DaVinciBot/CDR-CAD/CAD/CDR_2023/Louis-Amaury.jpg

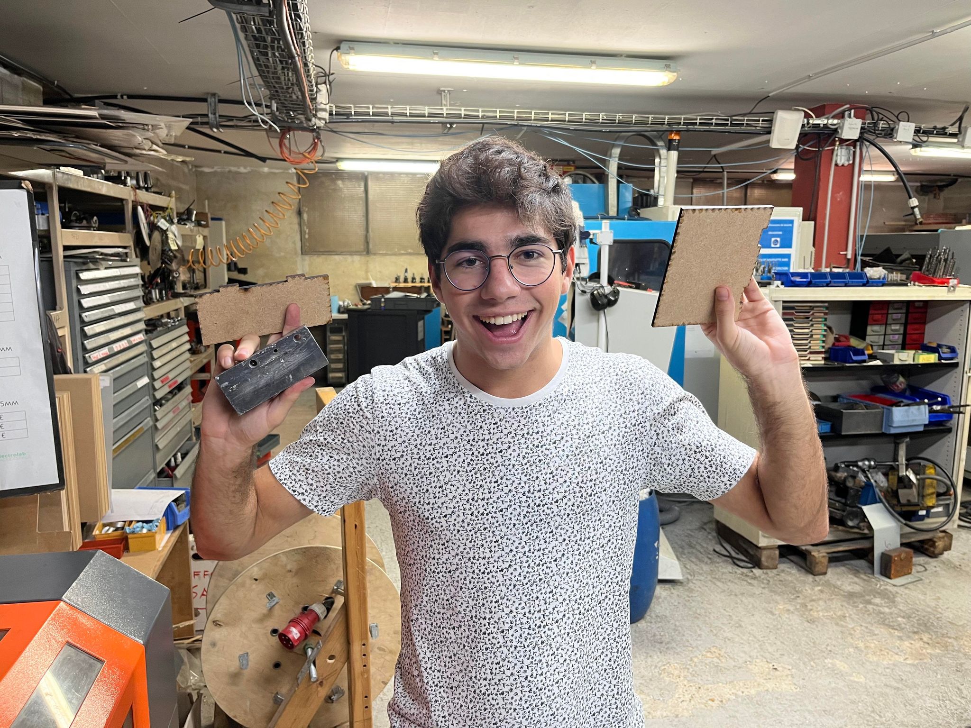
CAD/CDR_2023/Louis-Amaury.jpg
