DaVinciBot/CDR-CAD/CAD/CDR_2025/Robot_Main/1.Base_Roulante/1.Bloc_Moteur_2.0/1.Parties_Moteur_FAULHABER/3242_CR_3D-CAD/3242G_CR/3242G_CR.pdf

If you see this message, please change

"Comments and Forms" from Print Dialog to

"Document and Markups"

Explode / Move Parts
