DaVinciBot/CDR-CAD/CAD/CDR_2025/Robot_Main/1.Base_Roulante/1.Bloc_Moteur_2.0/1.Parties_Moteur_FAULHABER/32GPT_3D-CAD/32GPT_1stage/32gpt-1stage_standard+KSx+KRx.pdf

Wenn Sie diesen Text sehen, stellen Sie bitte

"Kommentare und Fomulare" im Drucken Dialog

auf "Dokument und Markierungen"

Explosion / Teile bewegen
