DaVinciBot/CDR-CAD/CAD/CDR_2025/Robot_Main/1.Base_Roulante/3.Roue_Encodeuse_2.0/Same_Sky_AMT102-0048-N5000-S/BOM.txt

3DX_Same_Sky_Supplier: Same Sky
3DX_Same_Sky_Description: AMT10 Radial, Fixed Resolution, 48 PPR, 8 Index Pulses, 5 mm Bore, Standard, Incremental, Capacitive Modular Encoder
3DX_Same_Sky_Model Number: AMT102-0048-N5000-S
