DaVinciBot/CDR-CAD/CAD/CDR_2022/Robot/etage 1/bras electrode/bras electrode sans bras.SLDASM

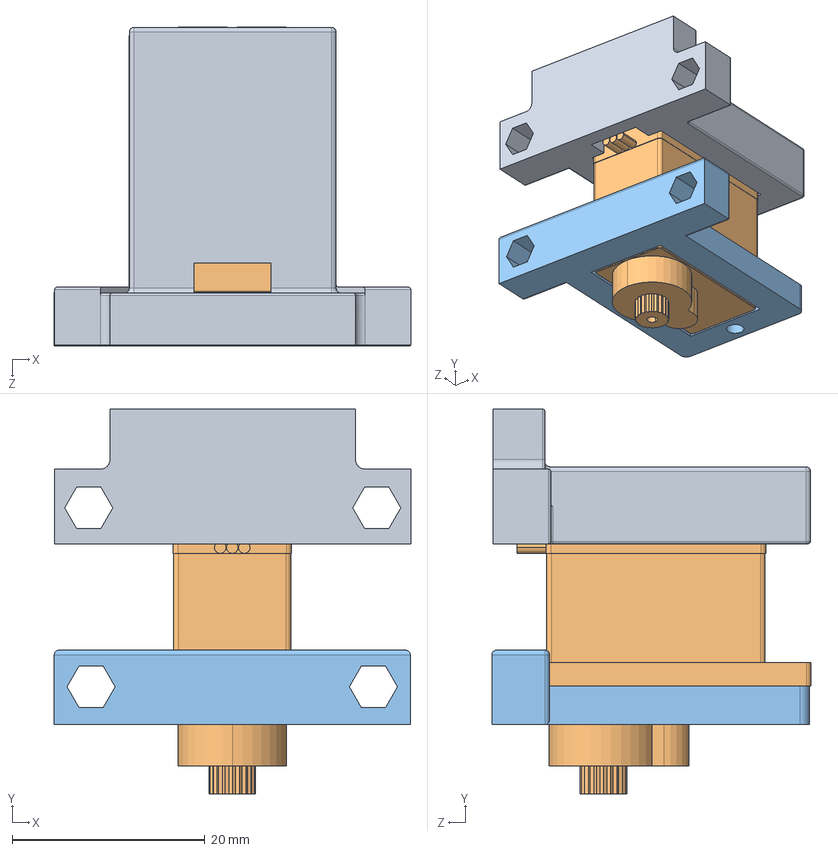
[picture p2: CAD file, 2024-01-29]
CAD/CDR_2022/Robot/etage 1/bras electrode/bras electrode sans bras.SLDASM
37.0 x 40.0 x 33.2 mm
soutien servo fond
servo 9g
soutien servo
