DaVinciBot/CDR-CAD/CAD/CDR_2022/Robot/Rdc/actionneur abri de chantier/actionneur gauche.SLDASM

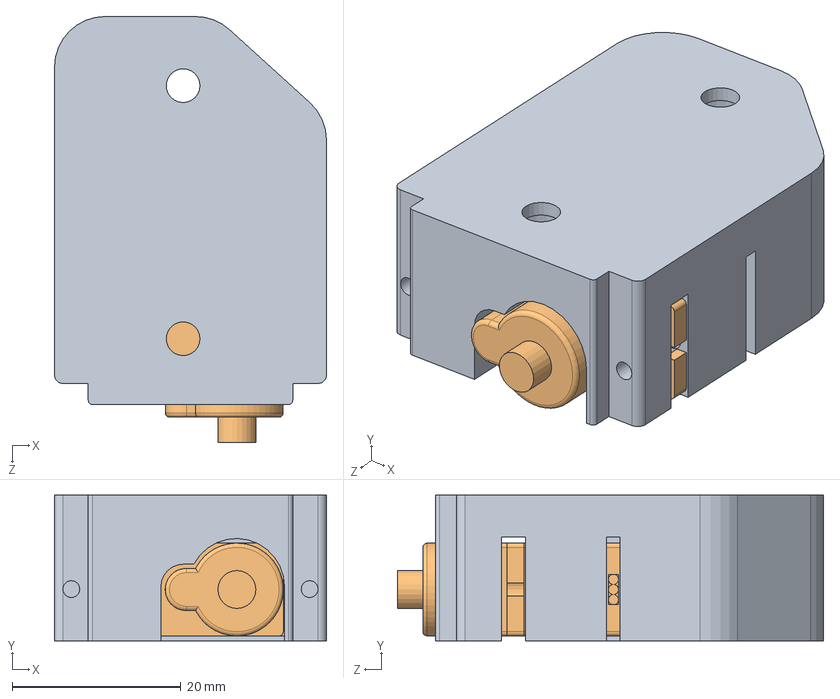
[picture p3: CAD file, 2024-01-29]
CAD/CDR_2022/Robot/Rdc/actionneur abri de chantier/actionneur gauche.SLDASM
32.2 x 17.3 x 50.5 mm
Support servo moteur (gauche)
Servo Motor SF90
