DaVinciBot/CDR-CAD/CAD/CDR_2022/Robot/Rdc/base roulante/base roulante.SLDASM

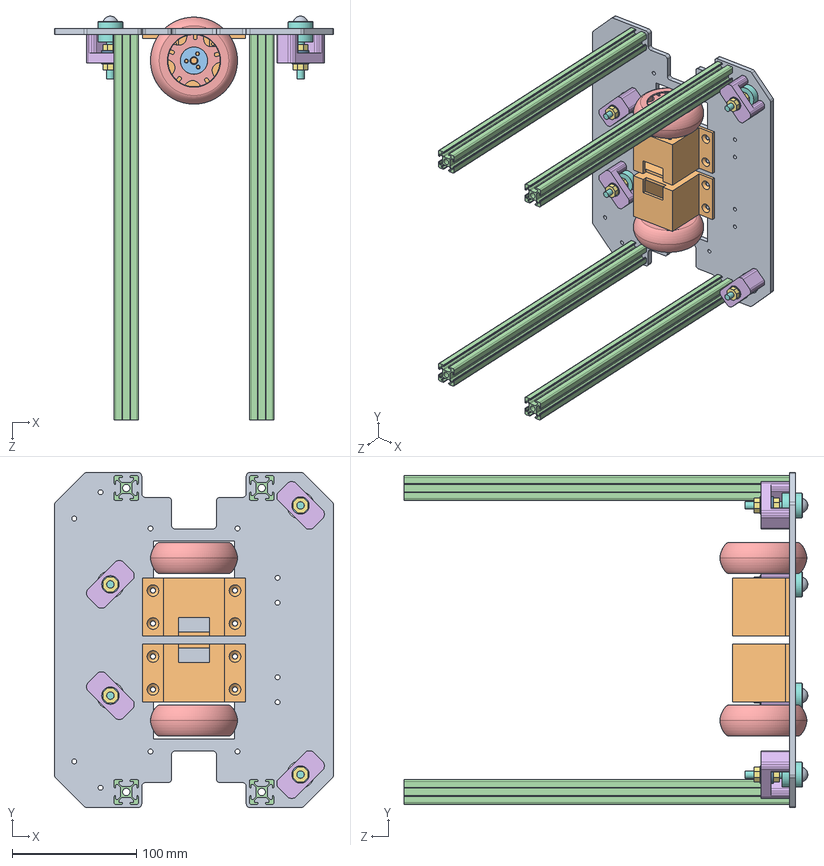
[picture p4: CAD file, 2024-01-29]
CAD/CDR_2022/Robot/Rdc/base roulante/base roulante.SLDASM
224.5 x 269.5 x 324.8 mm
plaque base roulante 2
support x 2
moyeu pololu (axe 5mm) part 2 x 2
moyeux pololu (axe 5mm) x 2
Roue Scooter noire 70x25 mm 3272 x 2
Support Bille porteuse x 4
Ecrou M6 x 8
Bille porteuse ALWAYE D12_7 x 4
Bille D12 x 4
Insert M4 x 8
Rondelle M6 x 16
Profilé Aluminium Bosch Rexroth 20 x 20 mm x 4
