DaVinciBot/CDR-CAD/CAD/CDR_2022/Robot/Rdc/base roulante/Roue/5mm/Assemblage 5mm.SLDASM

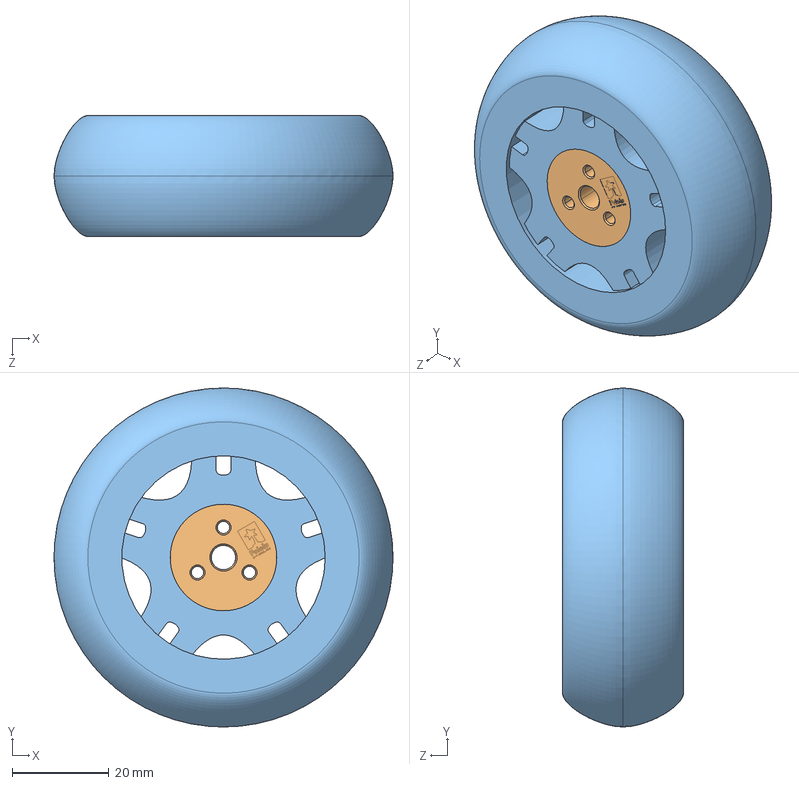
[picture p5: CAD file, 2024-01-29]
CAD/CDR_2022/Robot/Rdc/base roulante/Roue/5mm/Assemblage 5mm.SLDASM
70.0 x 70.0 x 25.0 mm
moyeu pololu (axe 5mm) part 2
moyeux pololu (axe 5mm)
Roue Scooter noire 70x25 mm 3272
