DaVinciBot/CDR-CAD/CAD/CDR_2023/Robot_1/1.Base roulante/base roulante/Assemblage Moteur-réducteur Faulhaber.SLDASM

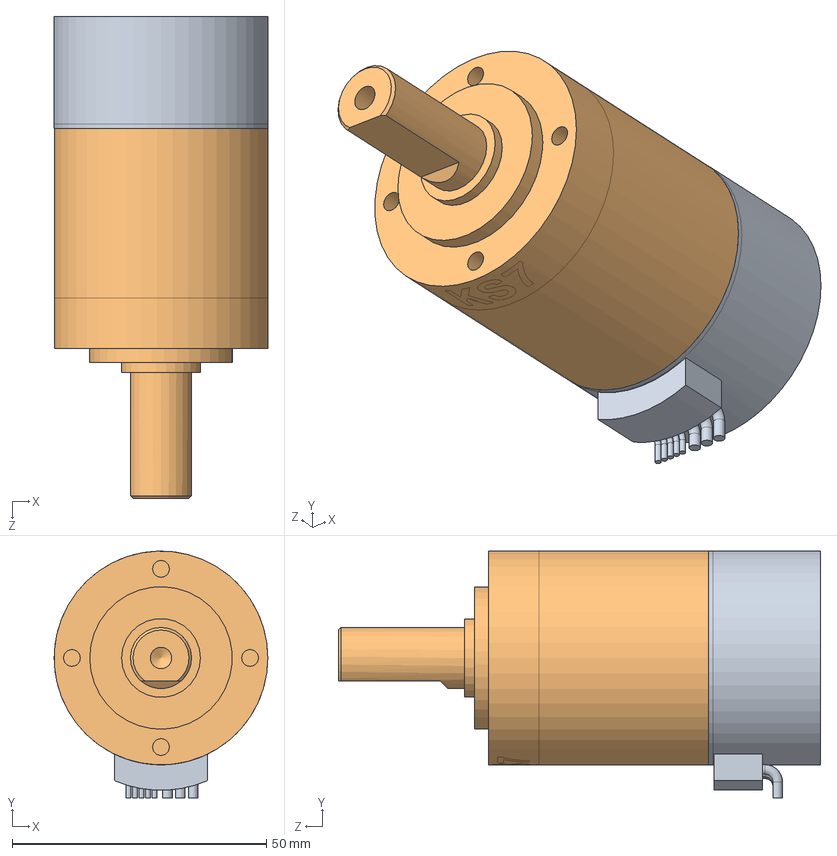
[picture p6: CAD file, 2024-01-29]
CAD/CDR_2023/Robot_1/1.Base roulante/base roulante/Assemblage Moteur-réducteur Faulhaber.SLDASM
42.0 x 48.5 x 94.7 mm
4221G_BXTH _ moteur
42gpt-2stage_standard+KSx _ reducteur
