DaVinciBot/CDR-CAD/CAD/CDR_2023/Robot_1/1.Base roulante/base roulante/Optimisation support moteur/Assemblage support opti.SLDASM

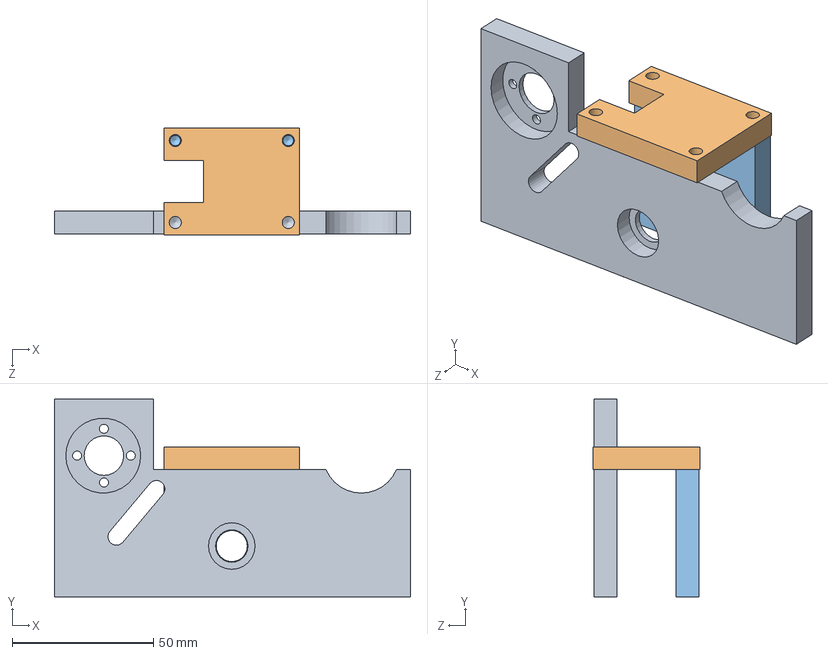
[picture p7: CAD file, 2024-01-29]
CAD/CDR_2023/Robot_1/1.Base roulante/base roulante/Optimisation support moteur/Assemblage support opti.SLDASM
126.0 x 70.0 x 38.0 mm
support principal
dessus support
côté support
