DaVinciBot/CDR-CAD/CAD/CDR_2023/Robot_1/2.Premier étage/Assemblage_interieur_Robot_1.SLDASM

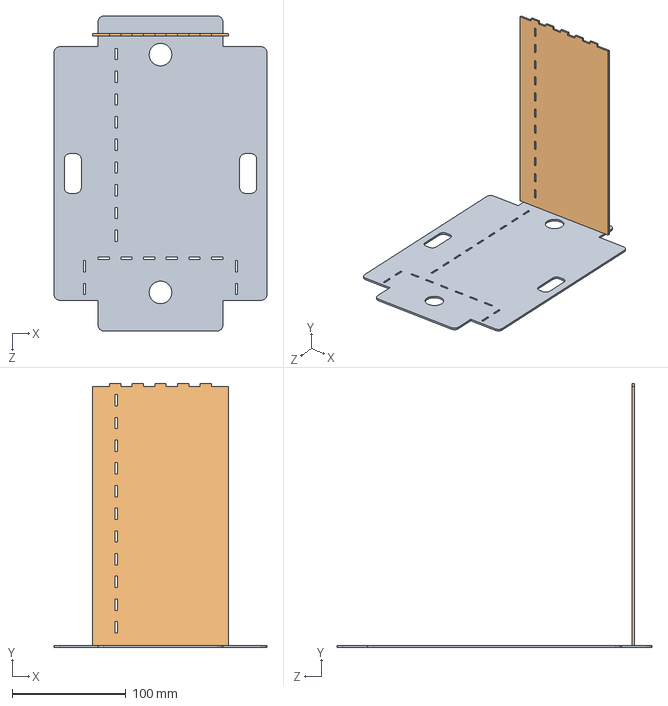
[picture p8: CAD file, 2024-01-29]
CAD/CDR_2023/Robot_1/2.Premier étage/Assemblage_interieur_Robot_1.SLDASM
187.5 x 233.0 x 277.5 mm
Plaque etage 1 BreadBoard
Plaque coté actionneur
