DaVinciBot/CDR-CAD/CAD/CDR_2023/Robot_1/5.Profilés et plexiglasse/Assemblage_plexi_exerieur.SLDASM

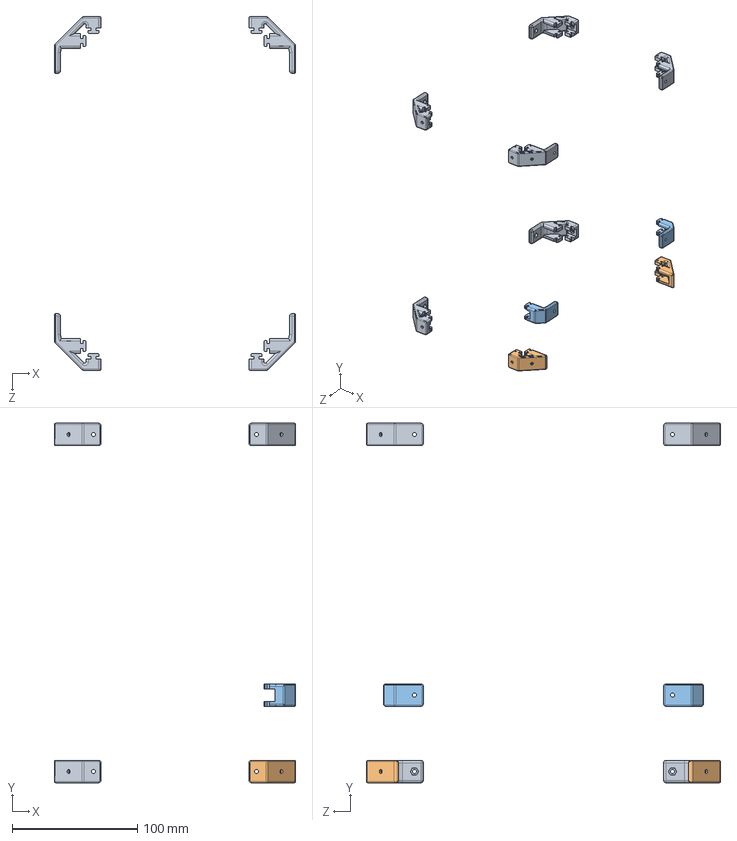
[picture p9: CAD file, 2024-01-29]
CAD/CDR_2023/Robot_1/5.Profilés et plexiglasse/Assemblage_plexi_exerieur.SLDASM
192.5 x 287.0 x 282.5 mm
support_plexi_vis_3mm_angle_1 x 6
support_plexi_vis_3mm_angle_2 x 2
support_plexi_vis_3mm_angle_3 x 2
