DaVinciBot/CDR-CAD/CAD/CDR_2023/Robot_2/5.Robot général/Système de remontée/Assemblage cage cerise milieu.SLDASM

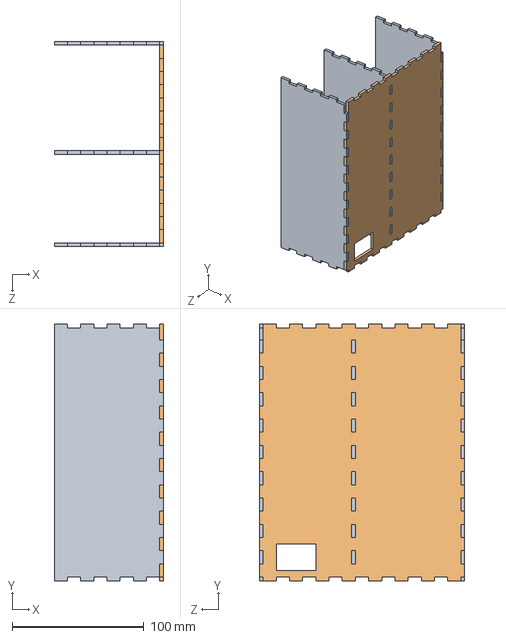
[picture p10: CAD file, 2024-01-29]
CAD/CDR_2023/Robot_2/5.Robot général/Système de remontée/Assemblage cage cerise milieu.SLDASM
83.0 x 195.1 x 156.0 mm
Paroi protection cerise 1 x 3
Paroi protection cerise 2
