DaVinciBot/CDR-CAD/CAD/CDR_2023/Robot_2/Assemblage Robot 2 2023.SLDASM

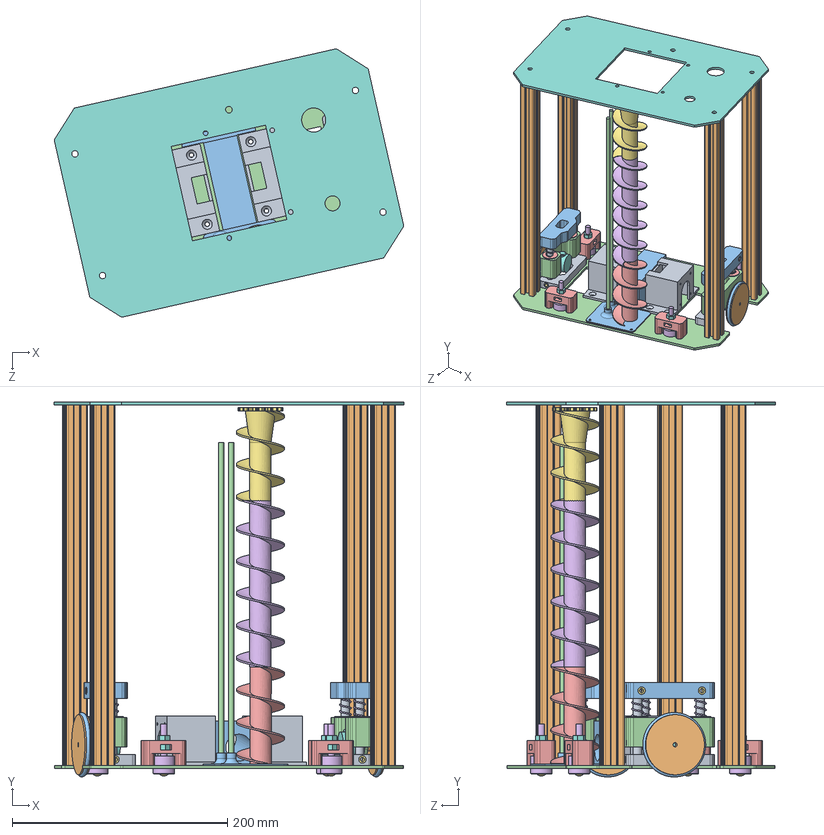
[picture p11: CAD file, 2024-01-29]
CAD/CDR_2023/Robot_2/Assemblage Robot 2 2023.SLDASM
325.2 x 348.8 x 249.8 mm
Axe_Support_Codeurs x 4
Roulement linéaire x 4
Support Ressort x 2
Support Encodeurs x 2
Rondelle M8 x 4
Ressort M8 x 4
Insert M4 x 20
Codeurs Kuebler D24 x 2
Support Plaque Encodeurs x 2
Roue folle D56 BRS x 2
Joint Torique D52 T4 BRS x 2
plaque base roulante V3
Support Bille porteuse V2 x 4
Bille porteuse ALWAYE D12_7 x 4
Bille D12 x 4
Ecrou M6 x 8
Cage stepper x 2
Profilé Aluminium Bosch Rexroth 20 x 20 x 335 mm x 4
Support vis base
Tige de guidage x 2
P1 vis sans fin
P2 vis sans fin
P3 vis sans fin V.2
Plaque LIDAR V.1
