DaVinciBot/CDR-CAD/CAD/CDR_2023/Robot_2/Robot/Bras/Assemblage support + moteur.SLDASM

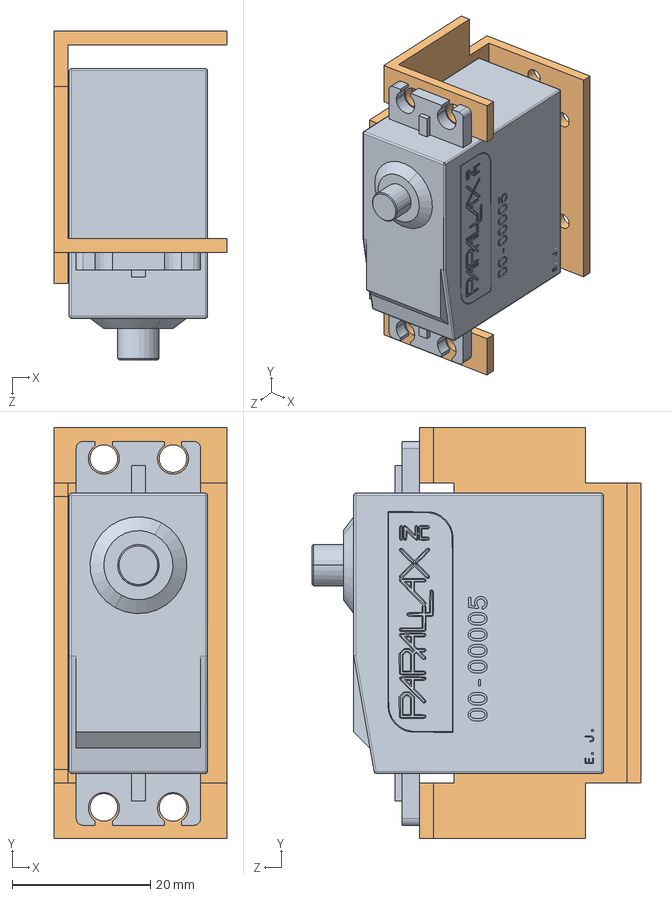
[picture p12: CAD file, 2024-01-29]
CAD/CDR_2023/Robot_2/Robot/Bras/Assemblage support + moteur.SLDASM
25.0 x 59.4 x 47.5 mm
Parallax Servo 900-00005
support servomoteur
