DaVinciBot/CDR-CAD/CAD/CDR_2024/Robot Main/1.Base roulante/2.Bille Porteuse/Assemblage Roue Porteuse V2.SLDASM

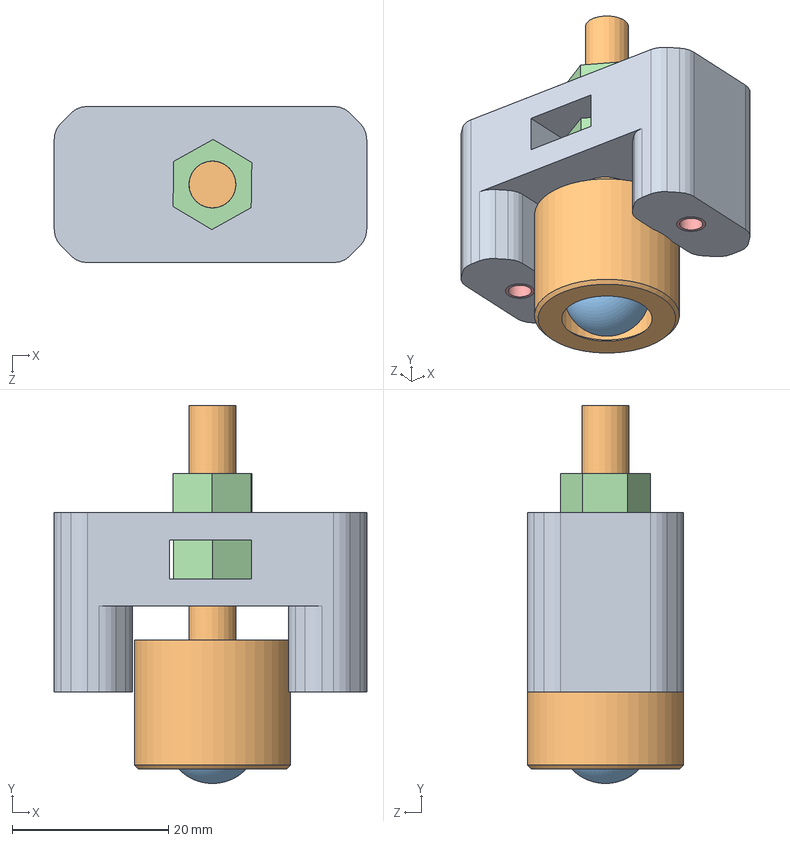
[picture p14: CAD file, 2025-04-10]
CAD/CDR_2024/Robot Main/1.Base roulante/2.Bille Porteuse/Assemblage Roue Porteuse V2.SLDASM
40.0 x 48.4 x 20.0 mm
Support Bille porteuse V3
Bille porteuse ALWAYE D12_7
Bille D12
Ecrou M6 x 2
Insert_M3x8x5 x 2
