DaVinciBot/CDR-CAD/CAD/CDR_2024/Robot Main/1.Base roulante/3.Roue Encodeuse/roue encodeuse/Assemblage Roue Codeuse.SLDASM

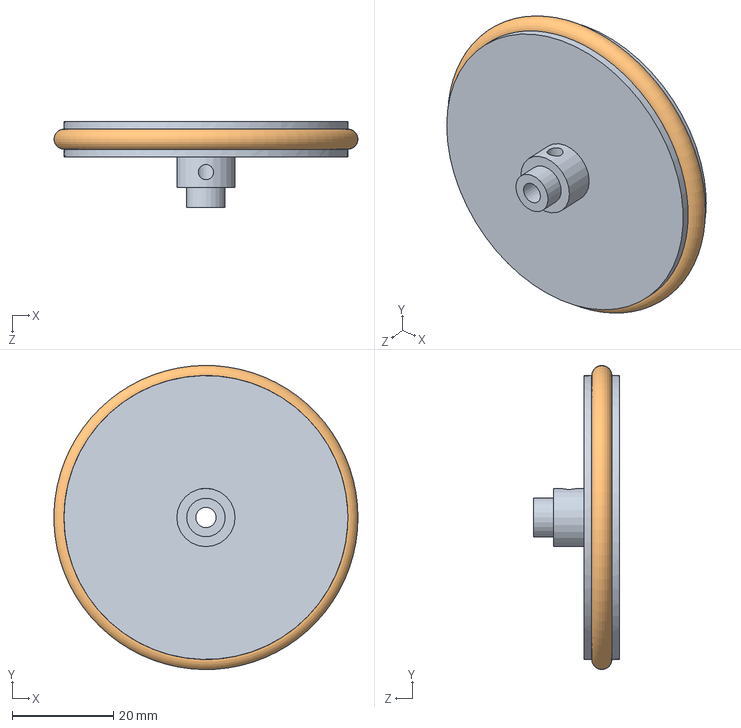
[picture p15: CAD file, 2024-05-05]
CAD/CDR_2024/Robot Main/1.Base roulante/3.Roue Encodeuse/roue encodeuse/Assemblage Roue Codeuse.SLDASM
60.0 x 60.0 x 17.0 mm
Roue folle D56 BRS
Joint Torique D52 T4 BRS
