DaVinciBot/CDR-CAD/CAD/CDR_2022/Robot/etage 1/bras retourneur/bras retourneur sans bras.SLDASM

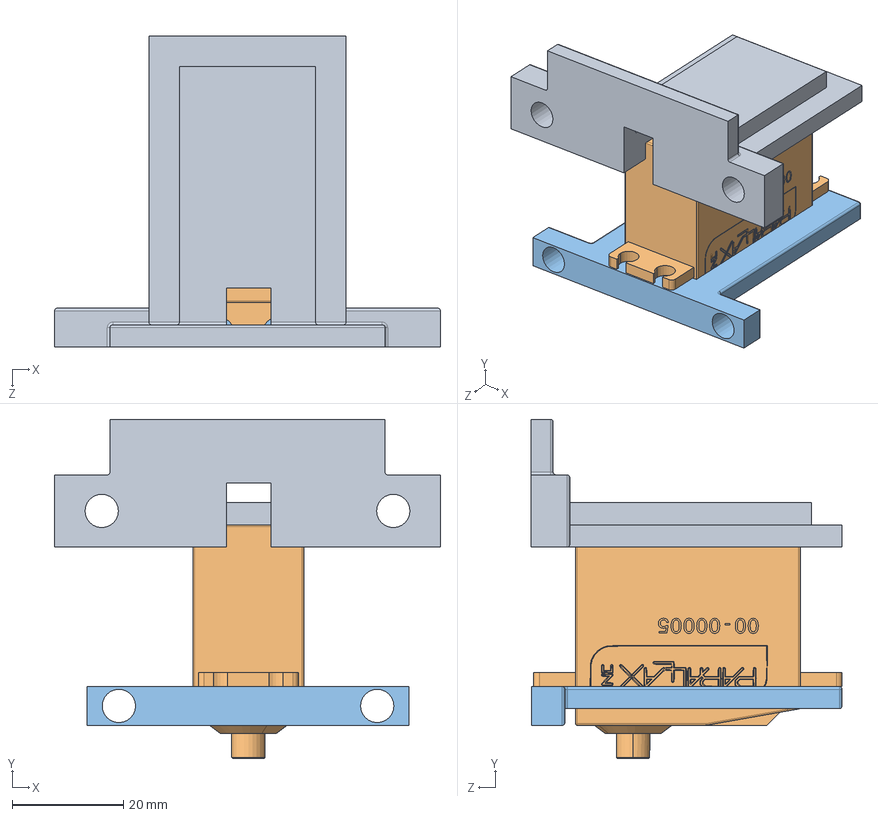
[picture p16: CAD file, 2024-01-29]
CAD/CDR_2022/Robot/etage 1/bras retourneur/bras retourneur sans bras.SLDASM
69.5 x 61.1 x 56.0 mm
soutien-servo-fond M4 INSERT BIEN
Parallax Servo 900-00005
soutien-servo M4 INSERT BIEN
