DaVinciBot/CDR-CAD/CAD/CDR_2023/Robot_1/1.Base roulante/base roulante/encodeurs/Systeme Encodeurs Partie Fixe.SLDASM

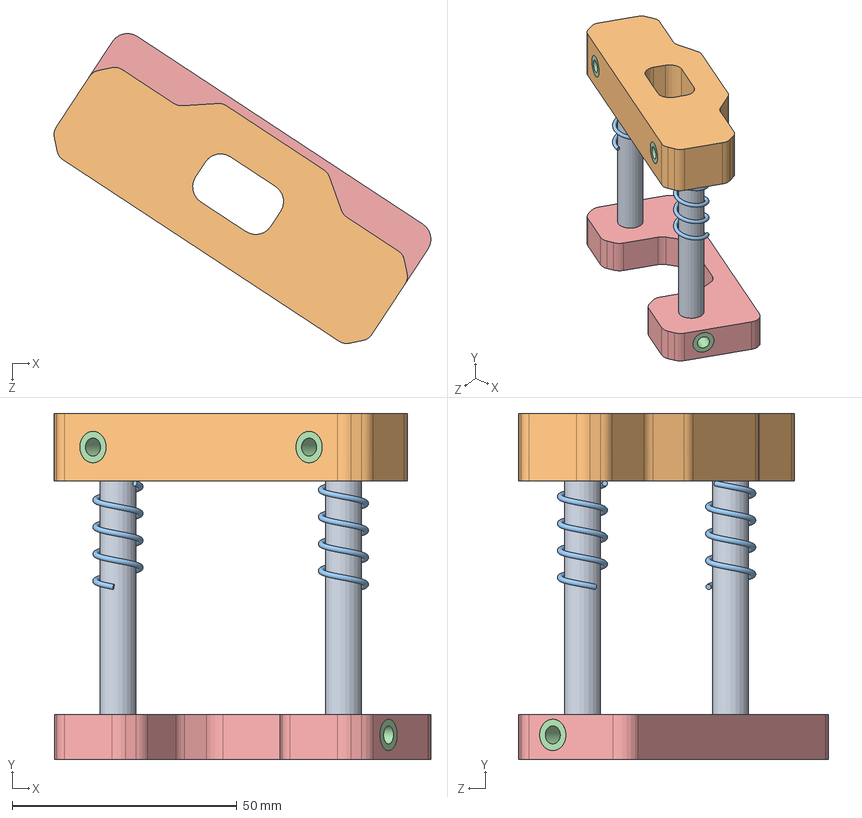
[picture p17: CAD file, 2024-01-29]
CAD/CDR_2023/Robot_1/1.Base roulante/base roulante/encodeurs/Systeme Encodeurs Partie Fixe.SLDASM
83.8 x 77.0 x 68.9 mm
Axe_Support_Codeurs x 2
Support Ressort
Ressort M8 x 2
Insert M4 x 6
Support Plaque Encodeurs
