DaVinciBot/CDR-CAD/CAD/CDR_2023/Robot_2/1.Base roulante/Assemblage Base Roulante Robot 2.SLDASM

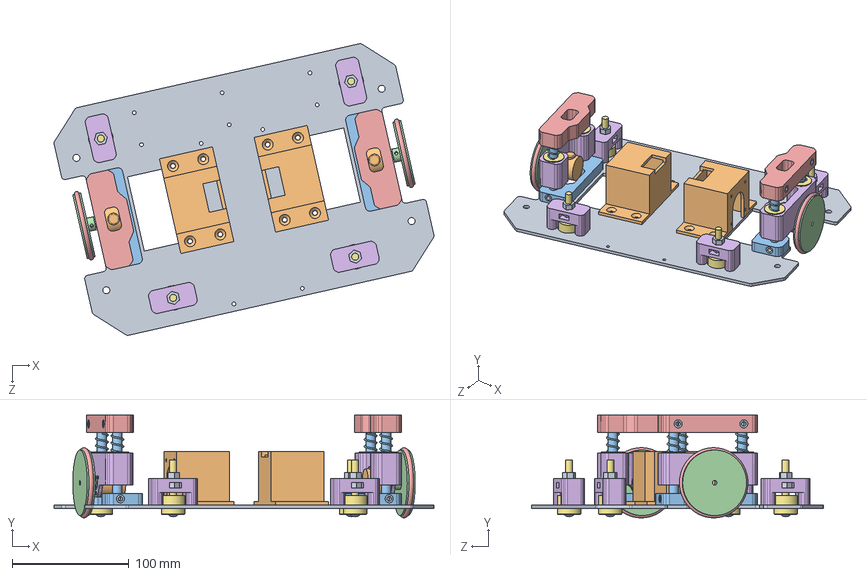
[picture p18: CAD file, 2024-01-29]
CAD/CDR_2023/Robot_2/1.Base roulante/Assemblage Base Roulante Robot 2.SLDASM
324.8 x 87.8 x 249.4 mm
plaque base roulante V3
Cage stepper x 2
Axe_Support_Codeurs x 4
Roulement linéaire x 4
Support Ressort x 2
Support Encodeurs x 2
Rondelle M8 x 4
Ressort M8 x 4
Insert M4 x 20
Codeurs Kuebler D24 x 2
Support Plaque Encodeurs x 2
Roue folle D56 BRS x 2
Joint Torique D52 T4 BRS x 2
Support Bille porteuse V2 x 4
Bille porteuse ALWAYE D12_7 x 4
Bille D12 x 4
Ecrou M6 x 8
