DaVinciBot/CDR-CAD/CAD/CDR_2023/Robot_2/3.Deuxième étage/Assemblage deuxieme etage Robot 2.SLDASM

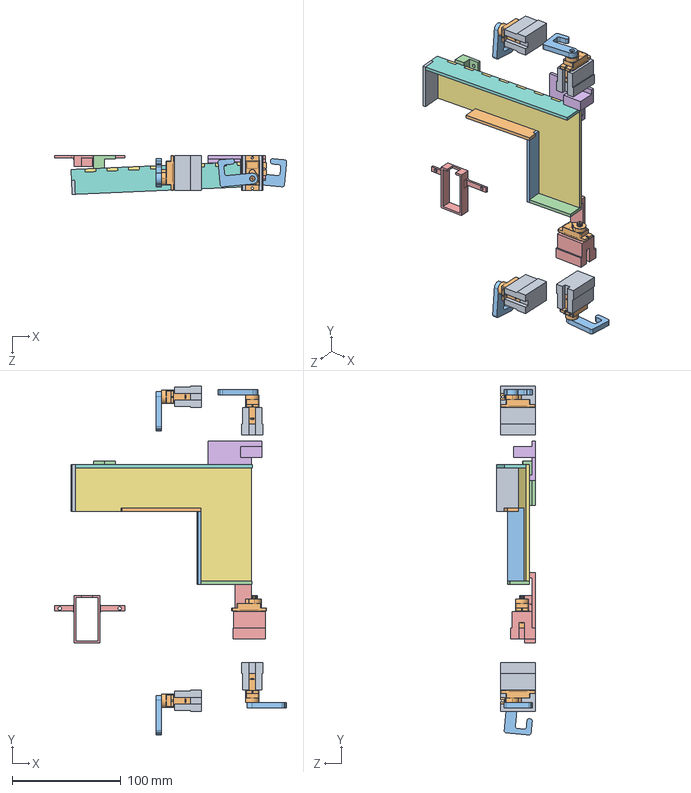
[picture p19: CAD file, 2024-01-29]
CAD/CDR_2023/Robot_2/3.Deuxième étage/Assemblage deuxieme etage Robot 2.SLDASM
213.7 x 321.1 x 35.8 mm
Support Servo x 4
SG90 Servo x 5
Crochet x 4
Support pente first
Support pente pièce 1
Support pente pièce 2
Pente stockage cerise
Mur extérieur pente cerise
Mur haut pente cerise
Mur intérieur 1 pente cerise
Mur intérieur 2 pente cerise
Mur intérieur 3 pente cerise
suport servo modifié
