DaVinciBot/CDR-CAD/CAD/CDR_2023/Robot_2/3.Deuxième étage/Déguisement/Assemblage Servo-Support Servo.SLDASM

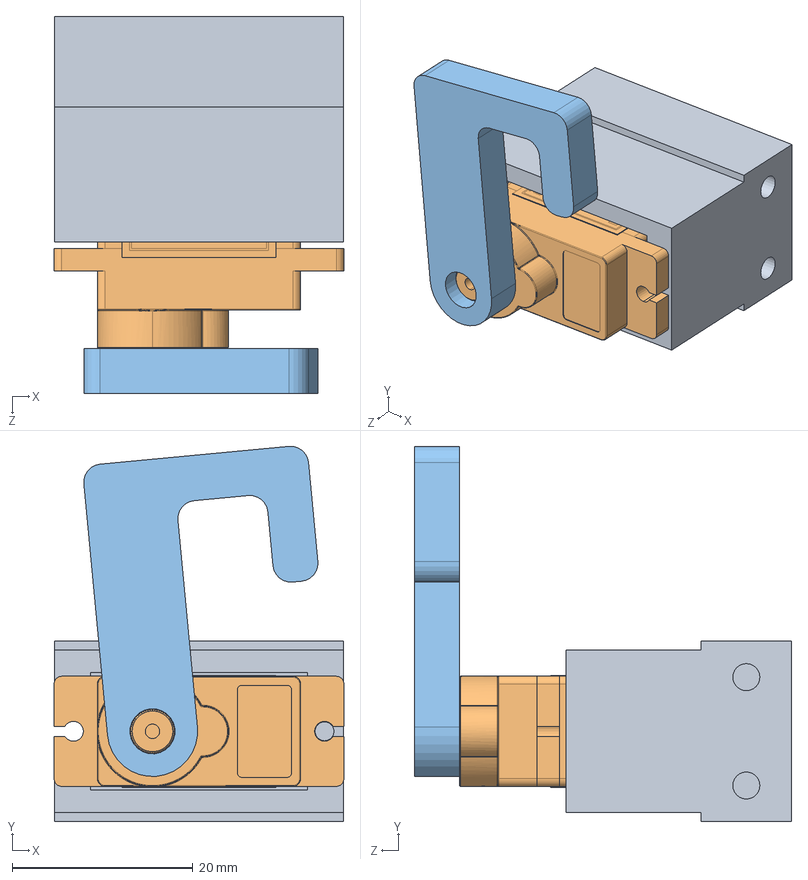
[picture p20: CAD file, 2024-01-29]
CAD/CDR_2023/Robot_2/3.Deuxième étage/Déguisement/Assemblage Servo-Support Servo.SLDASM
32.1 x 41.6 x 41.7 mm
Support Servo
SG90 Servo
Crochet
