DaVinciBot/CDR-CAD/CAD/CDR_2023/Robot_2/6.Cartes électroniques/Teensy-Sheild.SLDASM

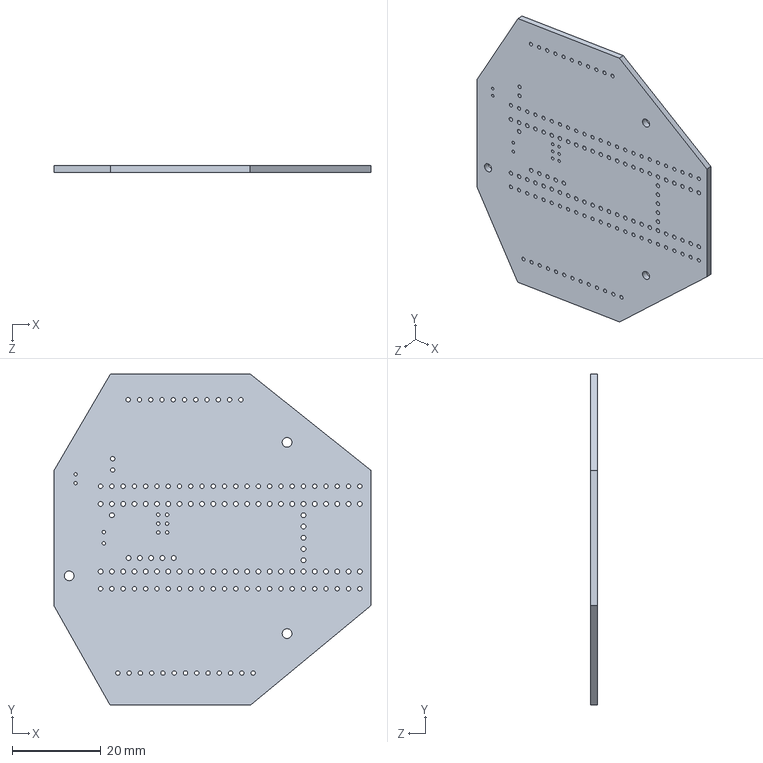
[picture p21: CAD file, 2024-01-29]
CAD/CDR_2023/Robot_2/6.Cartes électroniques/Teensy-Sheild.SLDASM
71.4 x 74.6 x 1.60 mm
