DaVinciBot/CDR-CAD/CAD/CDR_2023/Robot_2/Assemblage Robot 2 CDR 2023 V3.SLDASM

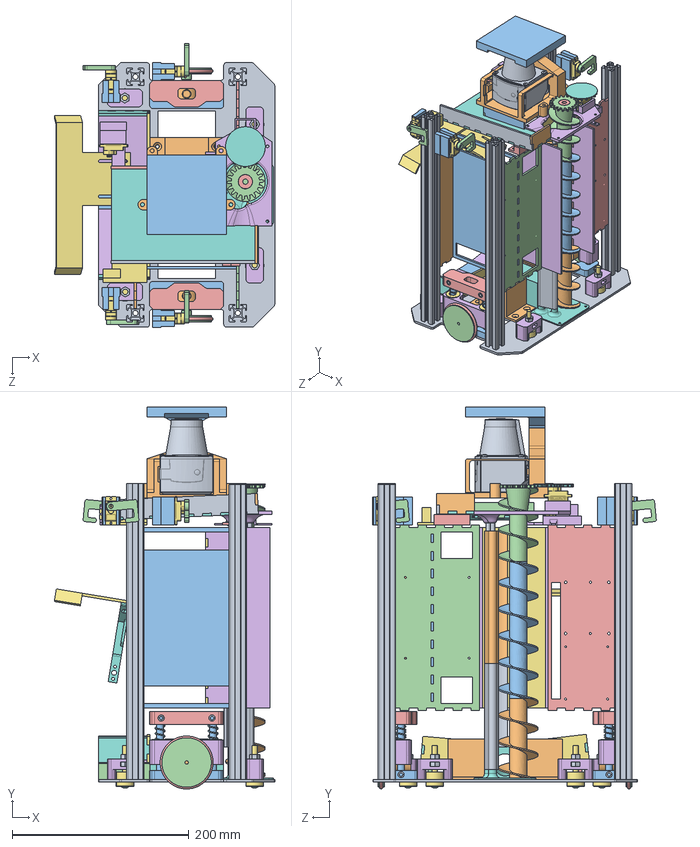
[picture p22: CAD file, 2024-01-29]
CAD/CDR_2023/Robot_2/Assemblage Robot 2 CDR 2023 V3.SLDASM
249.6 x 432.4 x 321.1 mm
plaque base roulante V3
Cage stepper x 2
Axe_Support_Codeurs x 4
Roulement linéaire x 4
Support Ressort x 2
Support Encodeurs x 2
Rondelle M8 x 4
Ressort M8 x 4
Insert M4 x 20
Codeurs Kuebler D24 x 2
Support Plaque Encodeurs x 2
Roue folle D56 BRS x 2
Joint Torique D52 T4 BRS x 2
Support Bille porteuse V2 x 4
Bille porteuse ALWAYE D12_7 x 4
Bille D12 x 4
Ecrou M6 x 8
Support pente centrale
Pente centrale
Support pente droit
Support pente gauche
Pente billes gauche x 2
Mur pente base x 2
Mur 2 pente base x 2
Profilé Aluminium Bosch Rexroth 20 x 20 x 335 mm x 4
Plaque côté batterie
Plaque arrière batterie
Plaque support carte alim
Plaque support droite
Cagette vis côté x 2
Cagette vis arrière
Support vis base
Tige de guidage x 2
Support vis haut
SG90 Servo x 6
Engrenage
Guidage remontée 2
Guidage remontée
Support Servo x 4
Crochet x 4
Support pente first
Support pente pièce 1
Support pente pièce 2
Pente stockage cerise
Mur extérieur pente cerise
Mur haut pente cerise
Mur intérieur 1 pente cerise
Mur intérieur 2 pente cerise
Mur intérieur 3 pente cerise
suport servo modifié
bras cerise plaque
bras cerise base
TIM561-Part
Support Sick TIM562 Bas Robot 2
Support Sick TIM562 Haut Robot 2
