DaVinciBot/CDR-CAD/CAD/CDR_2023/Robot_2/Robot/Rdc/base roulante/Assemblage moteur-cache-insert Total.SLDASM

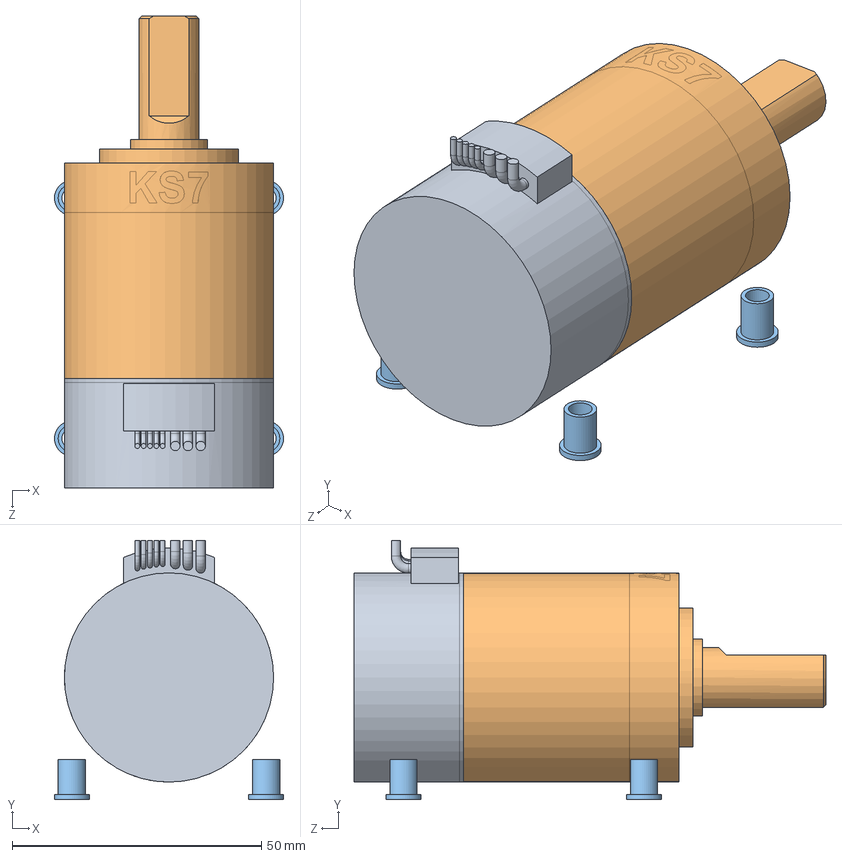
[picture p23: CAD file, 2024-01-29]
CAD/CDR_2023/Robot_2/Robot/Rdc/base roulante/Assemblage moteur-cache-insert Total.SLDASM
46.0 x 52.0 x 94.7 mm
4221G_BXTH _ moteur
42gpt-2stage_standard+KSx _ reducteur
Insert M4 x 4
