DaVinciBot/CDR-CAD/CAD/CDR_2023/Robot_2/Robot/Rdc/base roulante/Optimisation support moteur/Assemblage support opti.SLDASM

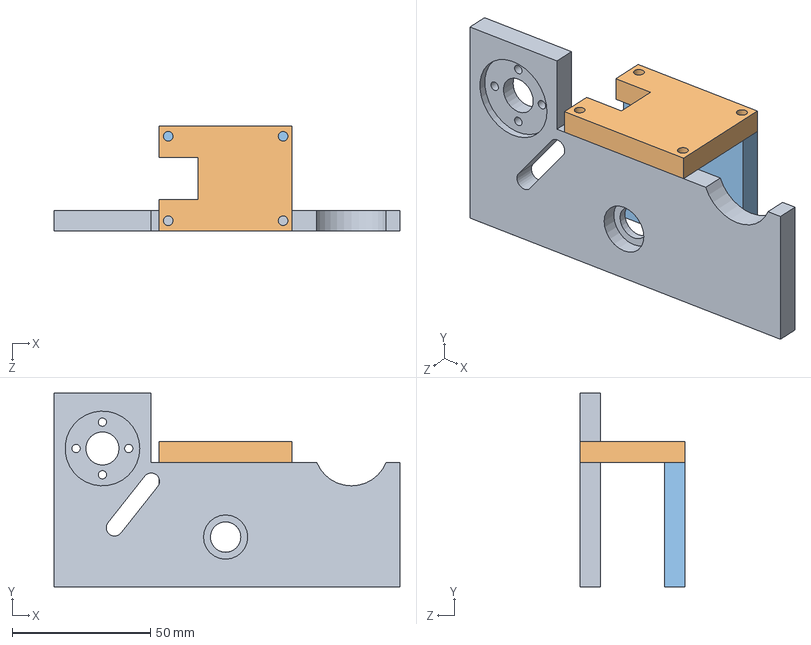
[picture p24: CAD file, 2024-01-29]
CAD/CDR_2023/Robot_2/Robot/Rdc/base roulante/Optimisation support moteur/Assemblage support opti.SLDASM
125.0 x 70.0 x 38.0 mm
support principal
dessus support
côté support
