DaVinciBot/CDR-CAD/CAD/CDR_2024/Robot Main/3.Actioneur/Main De Dieu/Support_Tige_Main_De_Dieu.SLDPRT

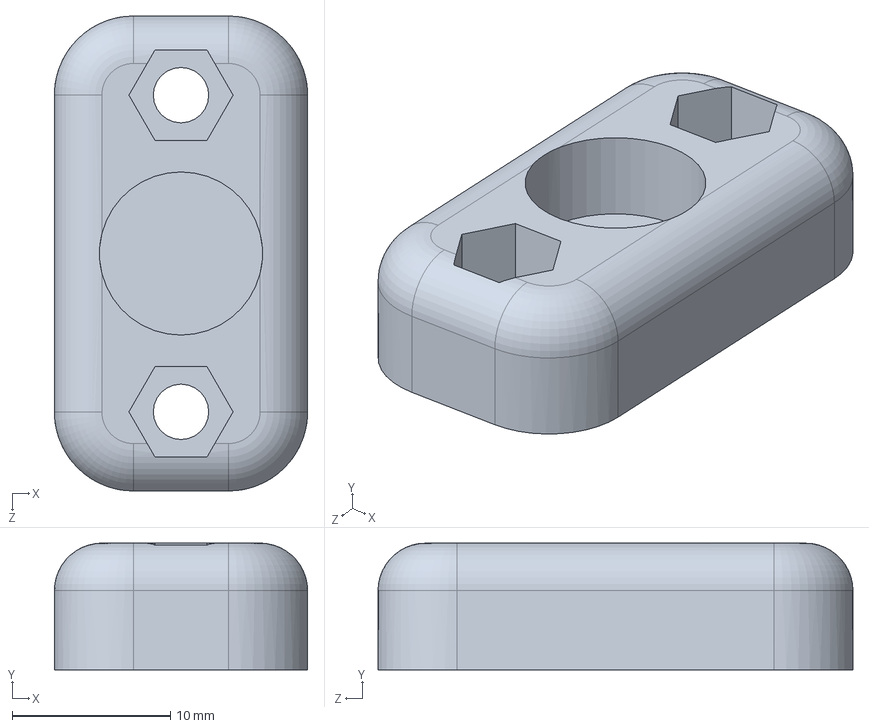
[picture p25: CAD file, 2025-04-10]
CAD/CDR_2024/Robot Main/3.Actioneur/Main De Dieu/Support_Tige_Main_De_Dieu.SLDPRT
16.0 x 8.00 x 30.0 mm
