DaVinciBot/CDR-CAD/CAD/CDR_2025/Banderole/Maintien_Banderole.SLDPRT

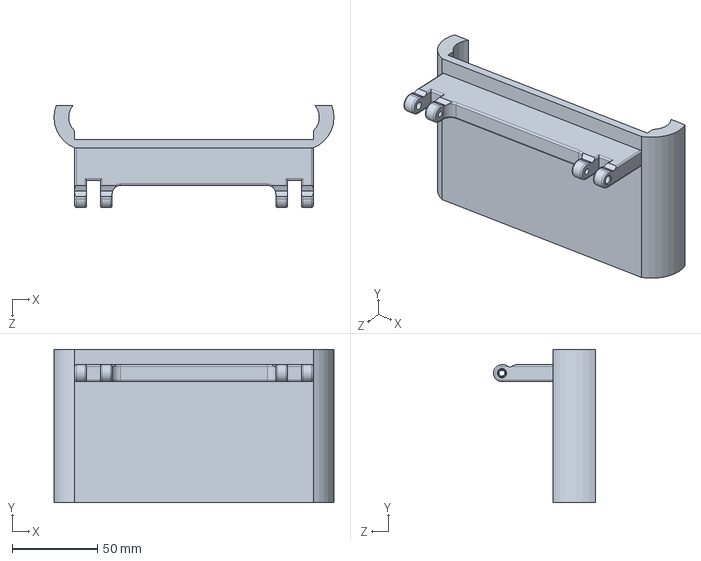
[picture p26: CAD file, 2025-05-21]
CAD/CDR_2025/Banderole/Maintien_Banderole.SLDPRT
164.3 x 90.0 x 60.0 mm
