DaVinciBot/CDR-CAD/CAD/Servos/DIGITAL SERVO ASSEMBLY.SLDASM

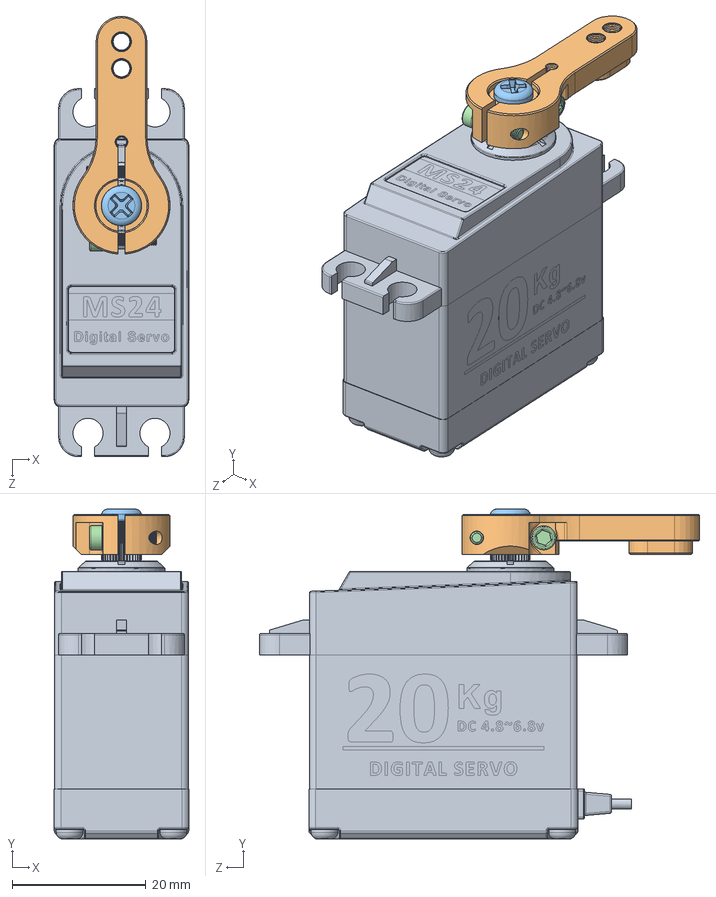
[picture p27: CAD file, 2025-04-10]
CAD/Servos/DIGITAL SERVO ASSEMBLY.SLDASM
20.1 x 49.3 x 65.8 mm
DS3218MG MS24 Digital Servo 270
Servo Arm for DS3218MG
Screw-01 for DS3218MG
Screw-02 for DS3218MG x 2
