DaVinciBot/CDR-CAD/CAD/CDR_2022/Robot/toit/Lidar/Assemblage Support SICK TIM561.SLDASM

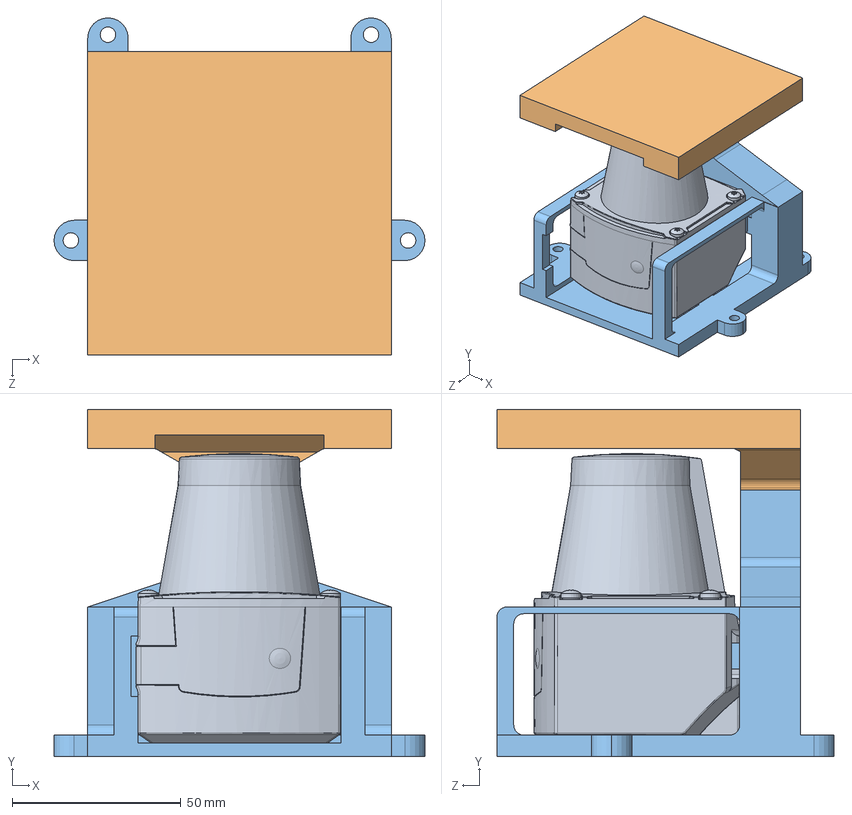
[picture p28: CAD file, 2024-01-29]
CAD/CDR_2022/Robot/toit/Lidar/Assemblage Support SICK TIM561.SLDASM
110.0 x 103.0 x 100.0 mm
TIM561-Part
Support Sick TIM562 Haut
Support Sick TIM562 Bas
