DaVinciBot/CDR-CAD/CAD/CDR_2023/Robot_1/1.Base roulante/base roulante/encodeurs/Assemblage Systeme Encodeurs.SLDASM

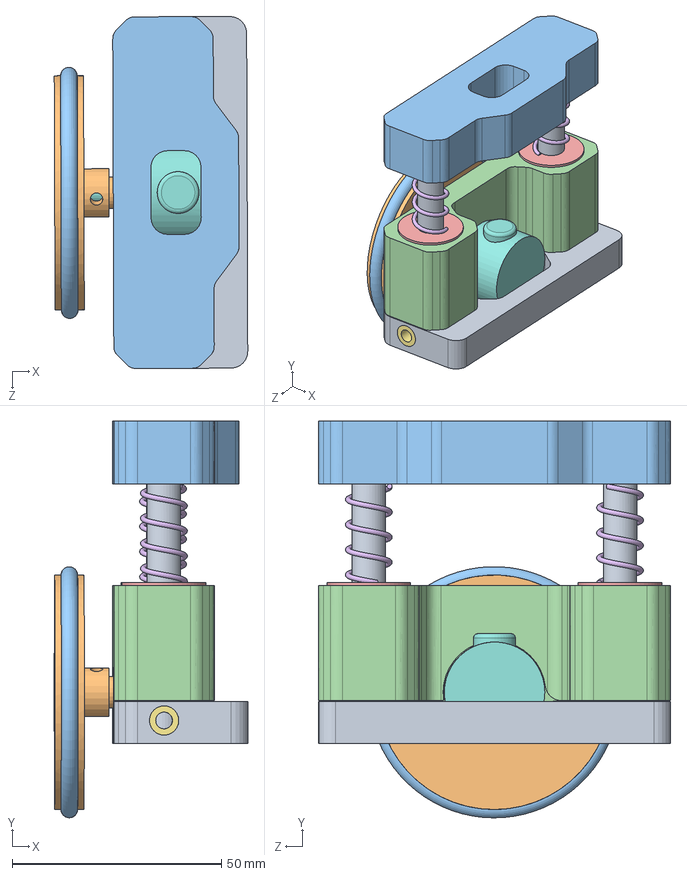
[picture p29: CAD file, 2024-01-29]
CAD/CDR_2023/Robot_1/1.Base roulante/base roulante/encodeurs/Assemblage Systeme Encodeurs.SLDASM
46.2 x 94.8 x 84.1 mm
Axe_Support_Codeurs x 2
Roulement linéaire x 2
Support Ressort
Support Encodeurs
Rondelle M8 x 2
Ressort M8 x 2
Insert M4 x 6
Codeurs Kuebler D24
Support Plaque Encodeurs
Roue folle D56 BRS
Joint Torique D52 T4 BRS
