DaVinciBot/CDR-CAD/CAD/CDR_2023/Robot_2/4.Dernier étage/Lidar/Assemblage Support SICK TIM561 Robot 2.SLDASM

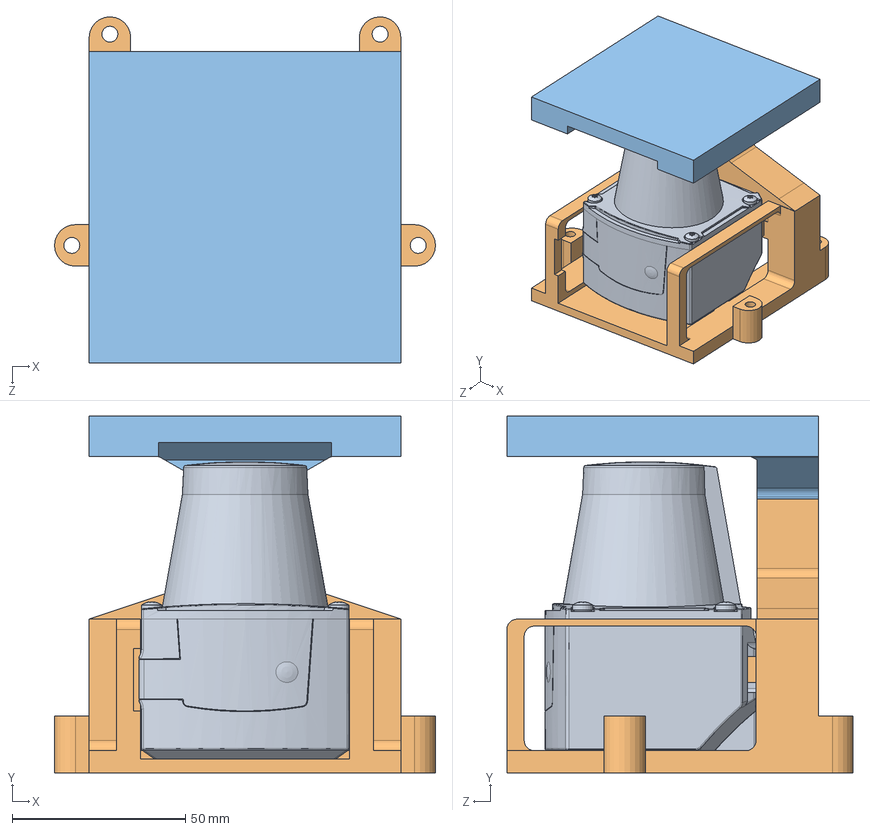
[picture p30: CAD file, 2024-01-29]
CAD/CDR_2023/Robot_2/4.Dernier étage/Lidar/Assemblage Support SICK TIM561 Robot 2.SLDASM
110.0 x 103.0 x 100.0 mm
TIM561-Part
Support Sick TIM562 Bas Robot 2
Support Sick TIM562 Haut Robot 2
