DaVinciBot/CDR-CAD/CAD/CDR_2024/Elements de jeu/Jardinière/Assemblage Jardinière.SLDASM

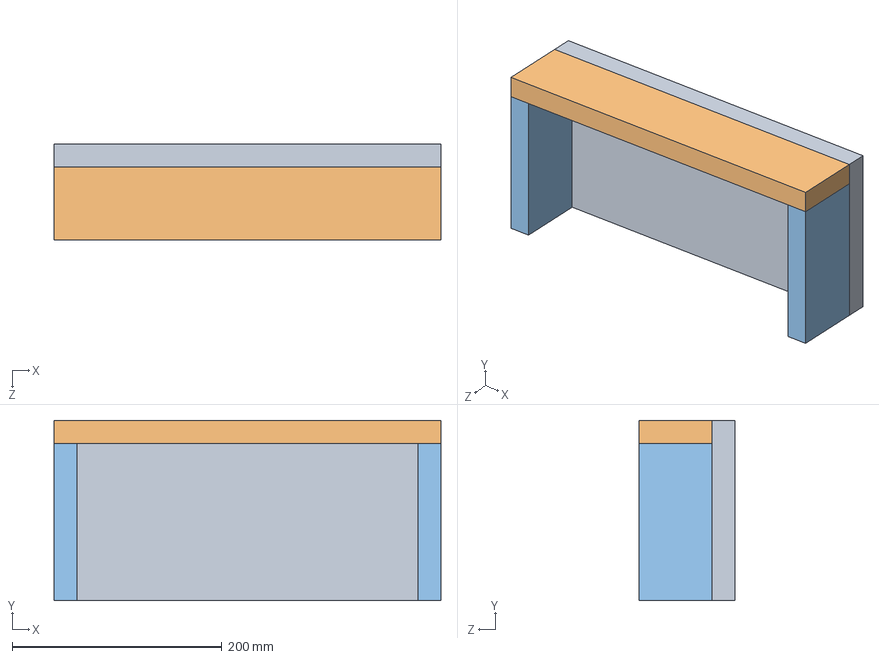
[picture p31: CAD file, 2024-01-29]
CAD/CDR_2024/Elements de jeu/Jardinière/Assemblage Jardinière.SLDASM
369.0 x 172.0 x 92.0 mm
Base_J
Fond_J
Cote_J x 2
