DaVinciBot/CDR-CAD/CAD/CDR_2024/Elements de jeu/Panneau solaire/Assemblage panneau solaire.SLDASM

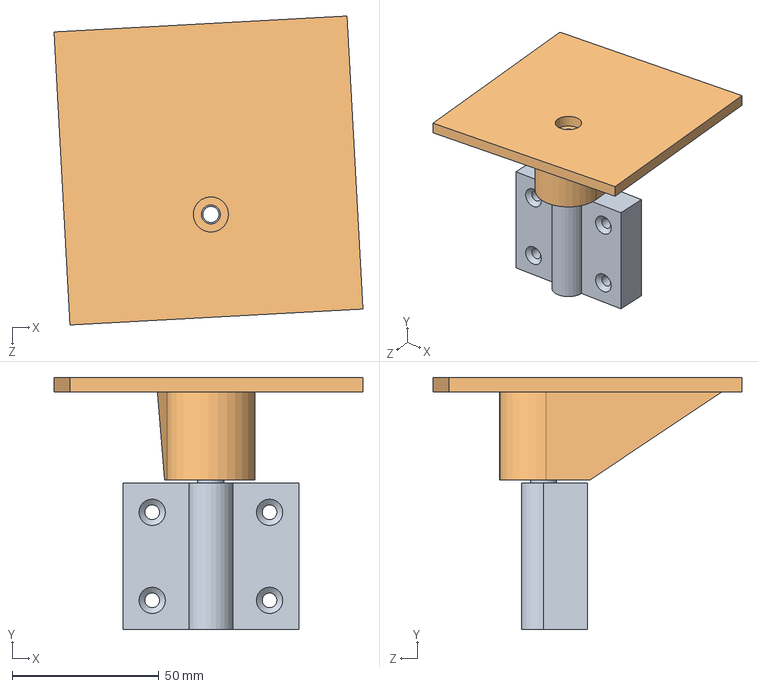
[picture p32: CAD file, 2024-01-29]
CAD/CDR_2024/Elements de jeu/Panneau solaire/Assemblage panneau solaire.SLDASM
105.3 x 86.0 x 105.3 mm
Support panneau solaire
Panneau solaire
