DaVinciBot/CDR-CAD/CAD/CDR_2024/Robot Main/2.Dernier étage/Plaque_Toit_Robot_Main.SLDPRT

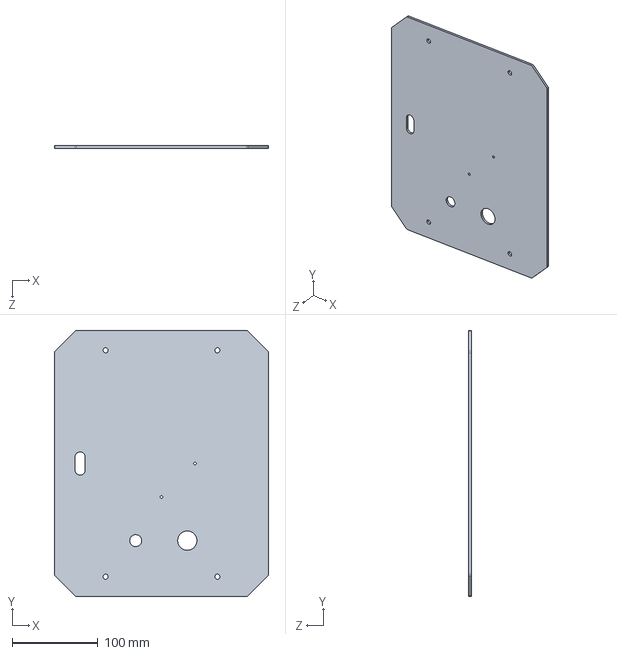
[picture p33: CAD file, 2025-04-10]
CAD/CDR_2024/Robot Main/2.Dernier étage/Plaque_Toit_Robot_Main.SLDPRT
249.5 x 309.5 x 3.00 mm
