DaVinciBot/CDR-CAD/CAD/CDR_2024/Robot Main/3.Actioneur/Main De Dieu/Support_Main_De_Dieu_V3.SLDPRT

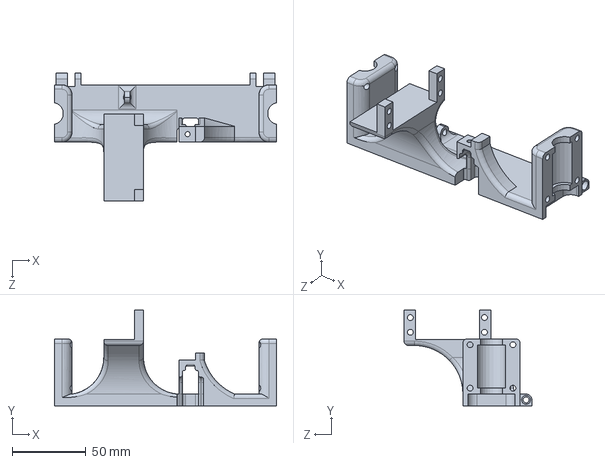
[picture p34: CAD file, 2025-04-10]
CAD/CDR_2024/Robot Main/3.Actioneur/Main De Dieu/Support_Main_De_Dieu_V3.SLDPRT
151.0 x 65.0 x 87.0 mm
