DaVinciBot/CDR-CAD/CAD/CDR_2024/Robot Main/4.Cartes électroniques/Etage_Electronique_Robot_Main.SLDPRT

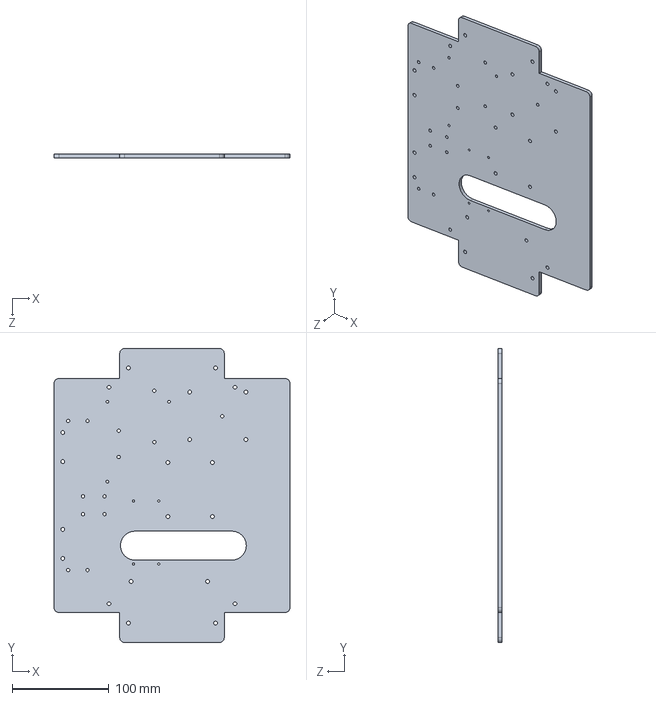
[picture p35: CAD file, 2025-04-10]
CAD/CDR_2024/Robot Main/4.Cartes électroniques/Etage_Electronique_Robot_Main.SLDPRT
243.5 x 303.5 x 4.00 mm
