DaVinciBot/CDR-CAD/CAD/CDR_2025/Elements_De_Jeu/Maintien_Pante.SLDPRT

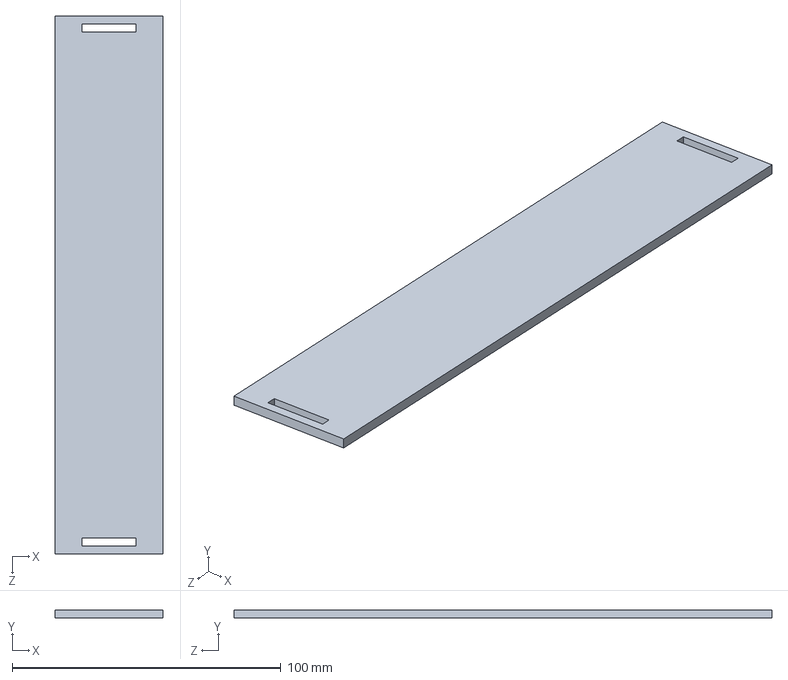
[picture p36: CAD file, 2025-05-21]
CAD/CDR_2025/Elements_De_Jeu/Maintien_Pante.SLDPRT
40.0 x 3.00 x 200.0 mm
