DaVinciBot/CDR-CAD/CAD/CDR_2025/PAMI/Base Roulante/Moteur double assemblé.SLDPRT

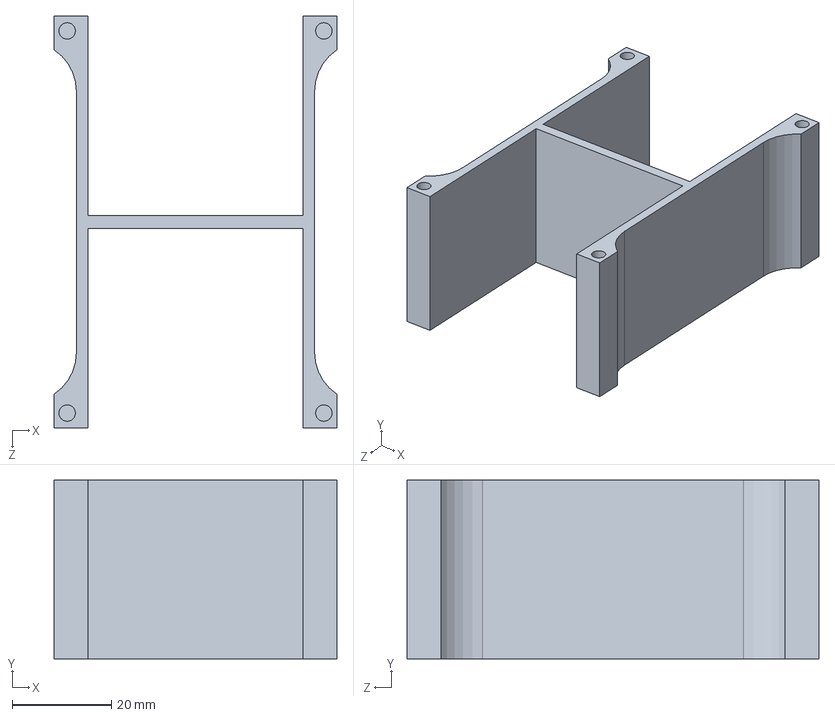
[picture p37: CAD file, 2025-05-21]
CAD/CDR_2025/PAMI/Base Roulante/Moteur double assemblé.SLDPRT
57.0 x 36.0 x 83.0 mm
