DaVinciBot/CDR-CAD/CAD/CDR_2023/Robot_2/2.Premier étage/Assemblage premier etage Robot 2.SLDASM

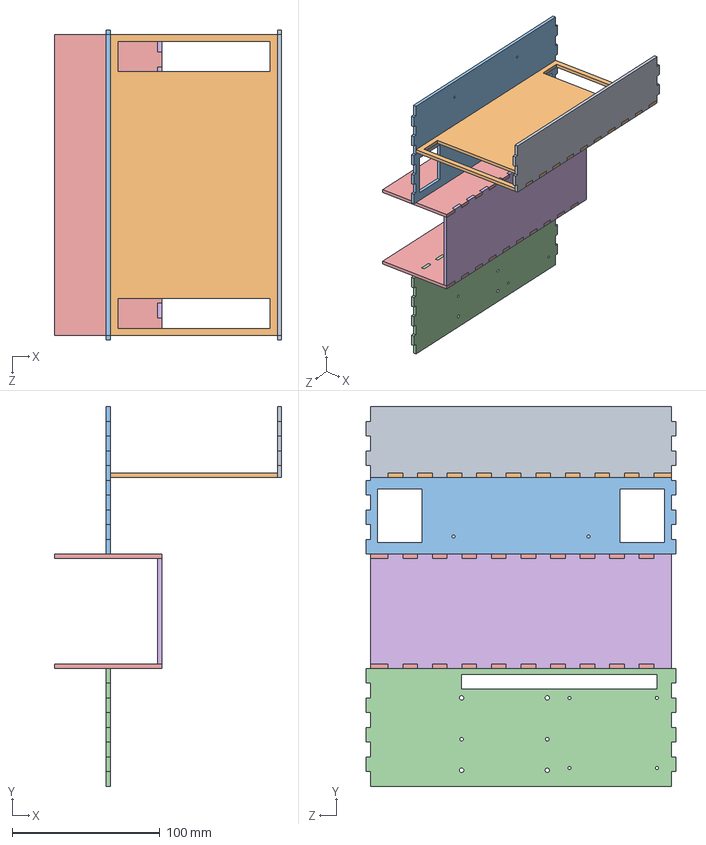
[picture p38: CAD file, 2024-01-29]
CAD/CDR_2023/Robot_2/2.Premier étage/Assemblage premier etage Robot 2.SLDASM
154.0 x 257.3 x 210.0 mm
Plaque côté batterie
Plaque arrière batterie
Plaque support carte alim
Plaque support droite
Cagette vis côté x 2
Cagette vis arrière
