DaVinciBot/CDR-CAD/CAD/CDR_2023/Robot_2/5.Robot général/Assemblage système de remontée des cerises.SLDASM

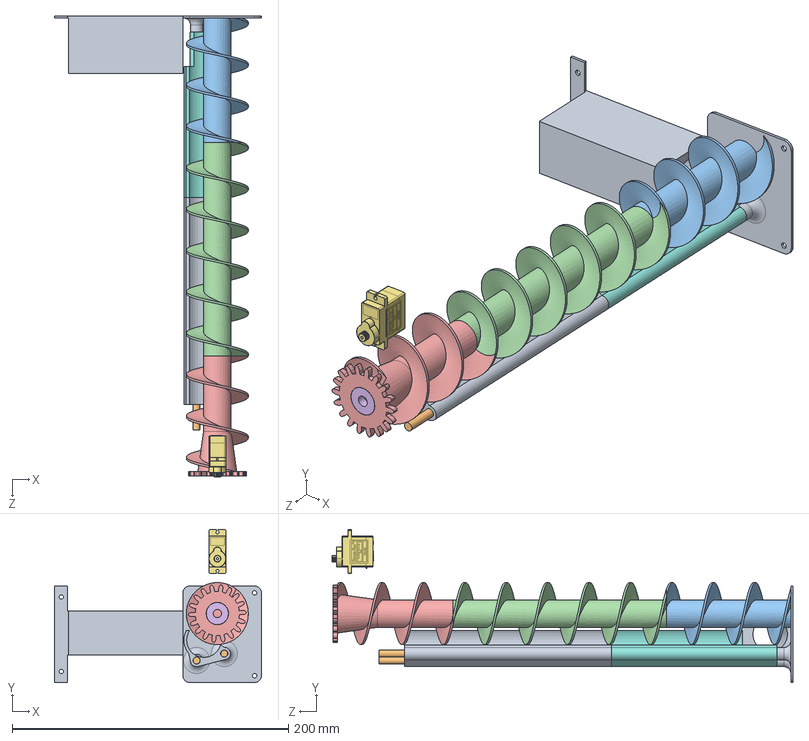
[picture p39: CAD file, 2024-01-29]
CAD/CDR_2023/Robot_2/5.Robot général/Assemblage système de remontée des cerises.SLDASM
150.0 x 110.9 x 334.0 mm
Support vis base
Tige de guidage x 2
P1 vis sans fin
P2 vis sans fin
P3 vis sans fin V.2
Roulement à bille x 2
SG90 Servo
Guidage remontée 2
Guidage remontée
