DaVinciBot/CDR-CAD/CAD/CDR_2023/Panier/V2/Assemblage Panier.SLDASM

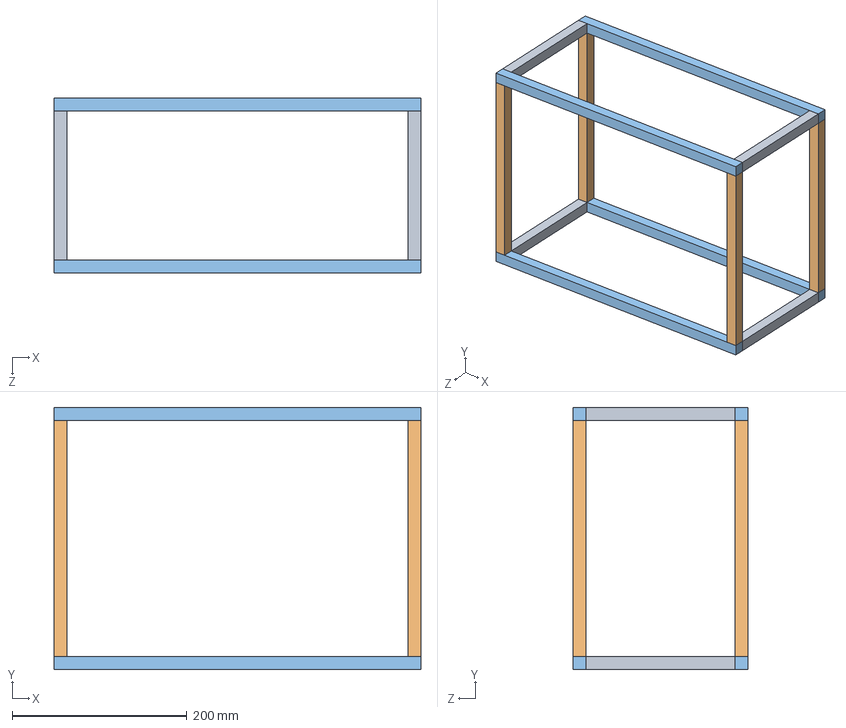
[picture p41: CAD file, 2024-01-29]
CAD/CDR_2023/Panier/V2/Assemblage Panier.SLDASM
420.0 x 300.0 x 200.0 mm
profilé 170x15x15 x 4
profilé 270x15x15 x 4
profilé 420x15x15 x 4
