DaVinciBot/CDR-CAD/CAD/CDR_2023/Robot_2/Robot/Rdc/base roulante/base roulante.SLDASM

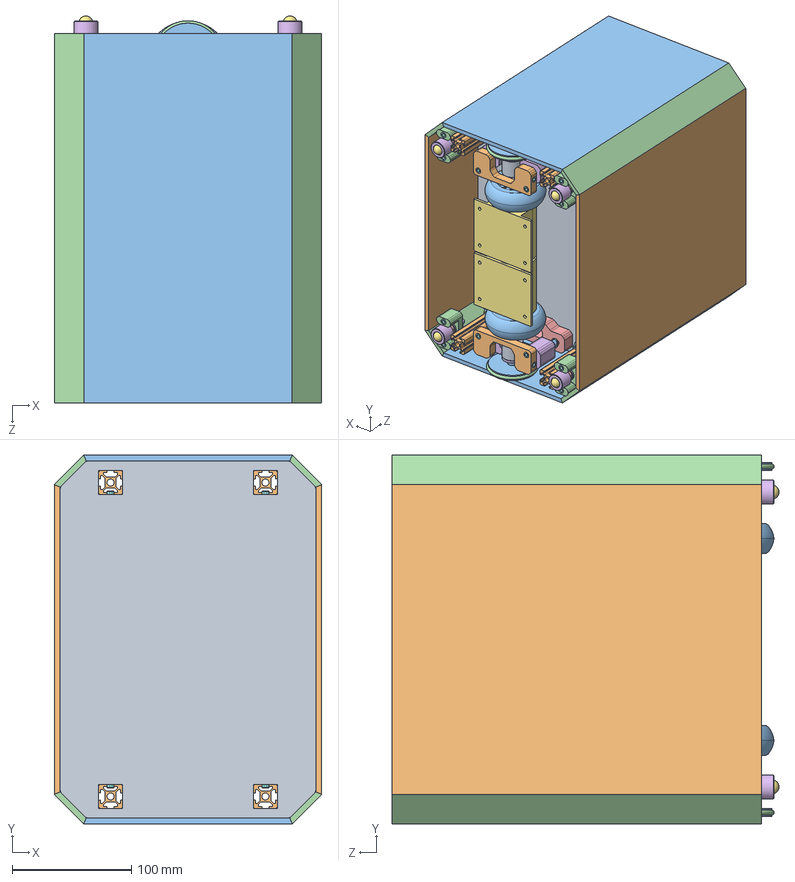
[picture p42: CAD file, 2024-01-29]
CAD/CDR_2023/Robot_2/Robot/Rdc/base roulante/base roulante.SLDASM
224.5 x 309.5 x 324.9 mm
moyeu pololu (axe 5mm) part 2 x 2
moyeux pololu (axe 5mm) x 2
Roue Scooter noire 70x25 mm 3272 x 2
Support Bille porteuse x 4
Ecrou M6 x 8
Bille porteuse ALWAYE D12_7 x 4
Bille D12 x 4
Insert M4 x 20
Rondelle M6 x 16
Profilé Aluminium Bosch Rexroth 20 x 20 mm x 4
Axe_Support_Codeurs x 4
Roulement linéaire x 4
Support Ressort x 2
Support Encodeurs x 2
Rondelle M8 x 4
Ressort M8 x 4
Codeurs Kuebler D24 x 2
Support Plaque Encodeurs x 2
Roue folle D56 BRS x 2
Joint Torique D52 T4 BRS x 2
4221G_BXTH _ moteur x 2
42gpt-2stage_standard+KSx _ reducteur x 2
Cache moteur x 2
equerre profilé x 4
Plaque etage 2_plexi pris en compte
plexi_avant x 2
plexi_coté x 2
plexi_coin x 4
