DaVinciBot/CDR-CAD/CAD/CDR_2025/Robot_Main/2.Toit/Plaque_Toit_Robot_Main_2.1.SLDPRT

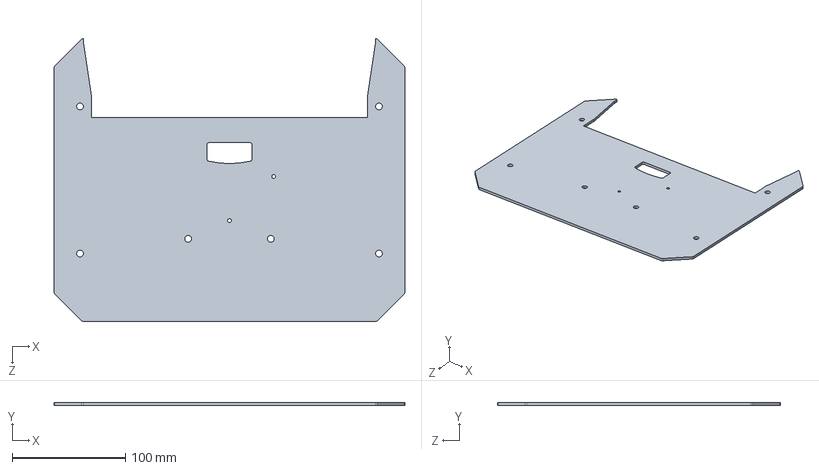
[picture p43: CAD file, 2025-05-21]
CAD/CDR_2025/Robot_Main/2.Toit/Plaque_Toit_Robot_Main_2.1.SLDPRT
310.0 x 3.00 x 250.0 mm
