DaVinciBot/CDR-CAD/CAD/CDR_2023/Robot_1/3.Dernier étage/Lidar/Assemblage Support SICK TIM561 Robot 1.SLDASM

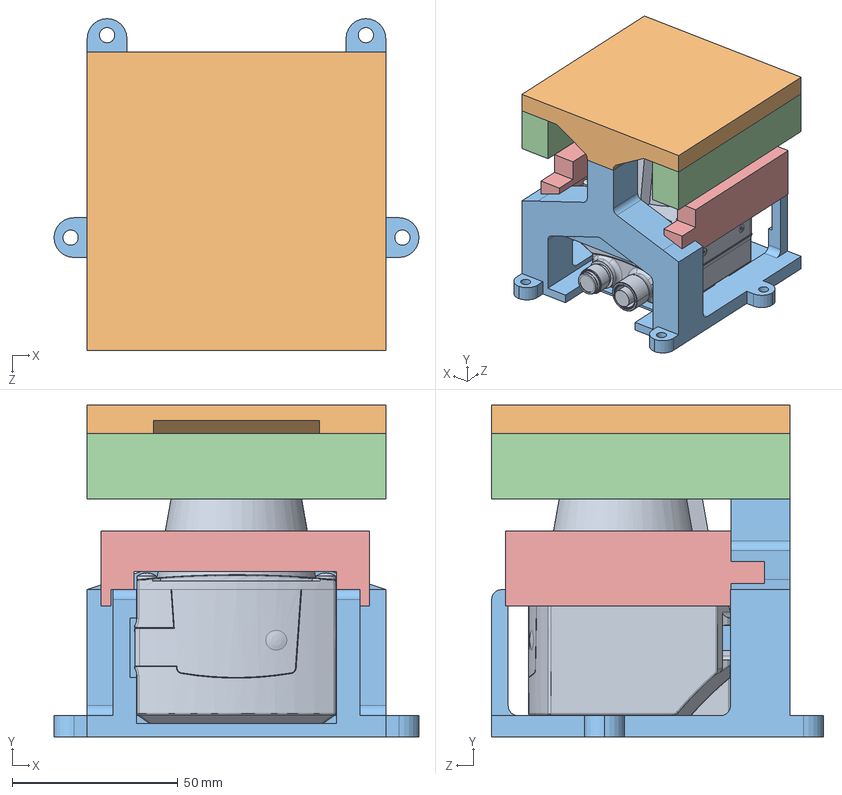
[picture p44: CAD file, 2024-01-29]
CAD/CDR_2023/Robot_1/3.Dernier étage/Lidar/Assemblage Support SICK TIM561 Robot 1.SLDASM
110.0 x 100.0 x 100.0 mm
TIM561-Part
Support Sick TIM562 Haut Robot 1
Support Sick TIM562 Bas Robot 1
Cache LiDAR Haut
Cache LiDAR Bas
