DaVinciBot/CDR-CAD/CAD/CDR_2023/Robot_1/4.Bras/Assemblage support + moteur.SLDASM

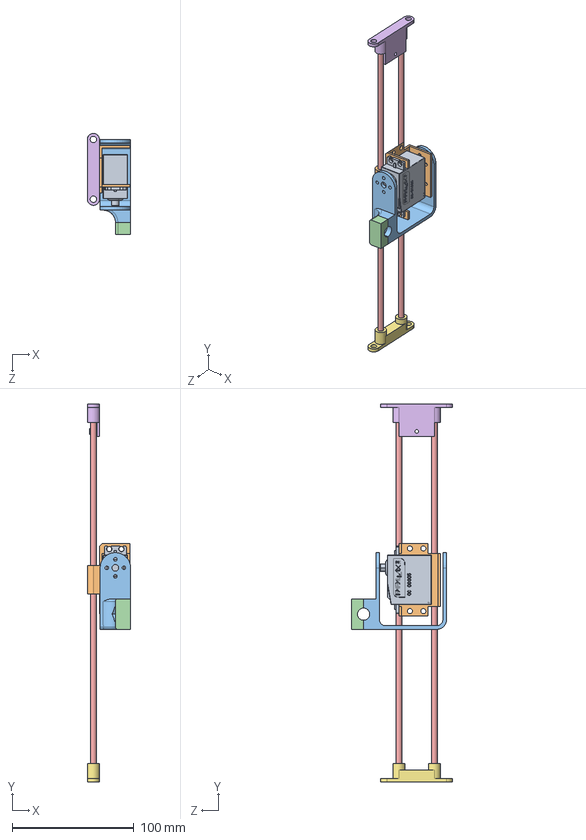
[picture p45: CAD file, 2024-01-29]
CAD/CDR_2023/Robot_1/4.Bras/Assemblage support + moteur.SLDASM
35.6 x 310.0 x 83.0 mm
Parallax Servo 900-00005
support_servomoteur_bras_pompe
bras_pompe_1
bras_pompe_2
Tige_guide_5mm_300mm x 2
support_tige_guide
support_tige_guide_top
