DaVinciBot/CDR-CAD/CAD/CDR_2023/Robot_2/5.Robot général/Assemblage Vis Roulement Engrenage.SLDASM

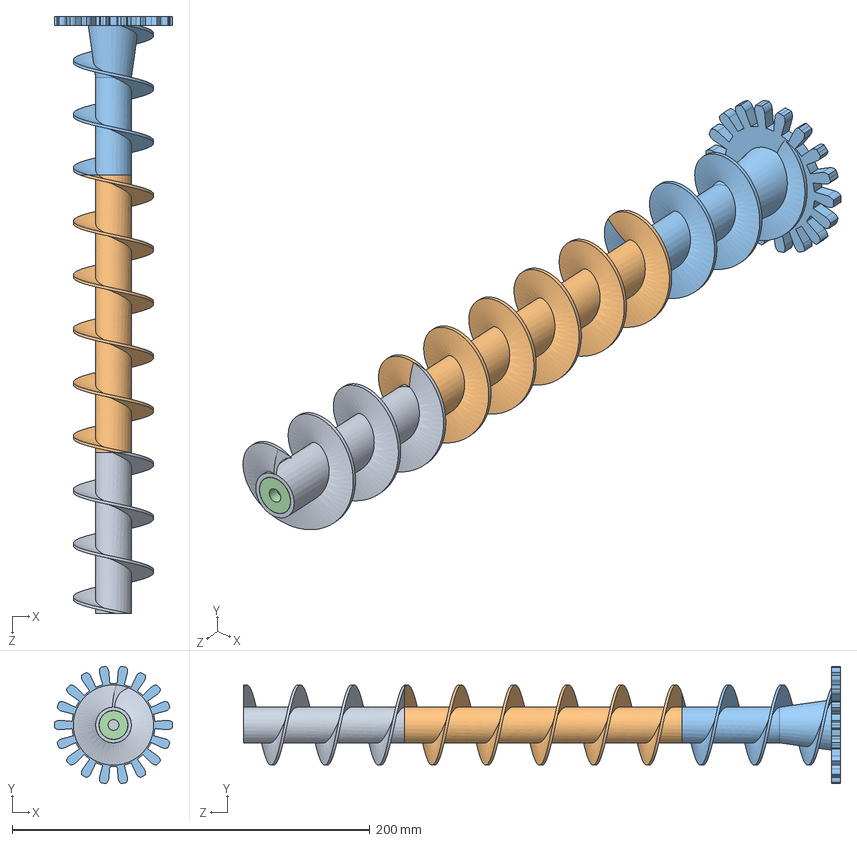
[picture p46: CAD file, 2024-01-29]
CAD/CDR_2023/Robot_2/5.Robot général/Assemblage Vis Roulement Engrenage.SLDASM
66.1 x 65.5 x 333.6 mm
P1 vis sans fin
P2 vis sans fin
P3 vis sans fin V.2
Roulement à bille x 2
