DaVinciBot/CDR-CAD/CAD/CDR_2024/Robot Main/3.Actioneur/Main De Dieu/Main_De_Dieu.SLDPRT

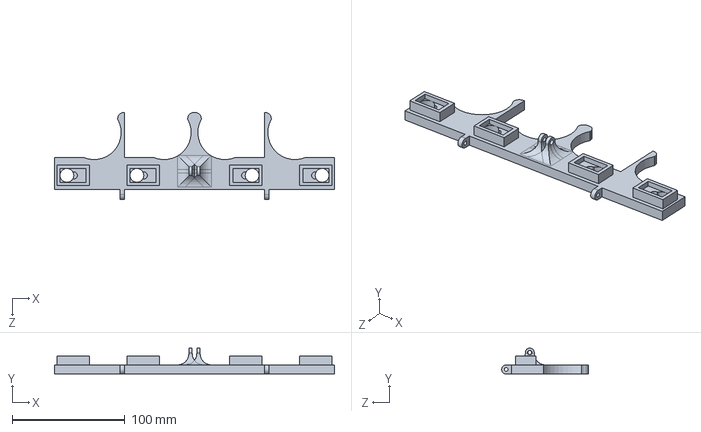
[picture p47: CAD file, 2025-04-10]
CAD/CDR_2024/Robot Main/3.Actioneur/Main De Dieu/Main_De_Dieu.SLDPRT
248.0 x 23.0 x 76.9 mm
