DaVinciBot/CDR-CAD/CAD/CDR_2025/Robot_Main/2.Toit/Plaque_Toit_Robot_Main_2.0.SLDPRT

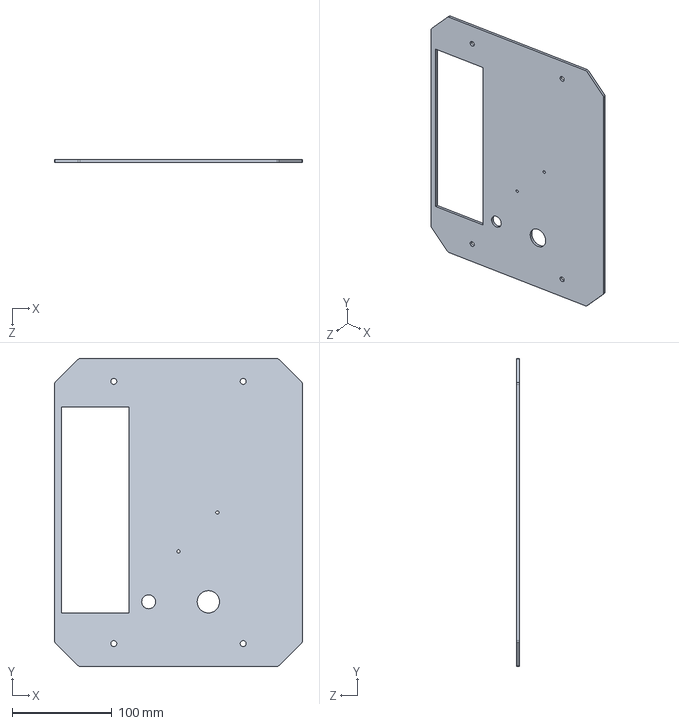
[picture p48: CAD file, 2025-01-13]
CAD/CDR_2025/Robot_Main/2.Toit/Plaque_Toit_Robot_Main_2.0.SLDPRT
249.5 x 309.5 x 3.00 mm
