DaVinciBot/CDR-CAD/CAD/CDR_2023/Robot_1/1.Base roulante/base roulante/Assemblage Total moteur-cache.SLDASM

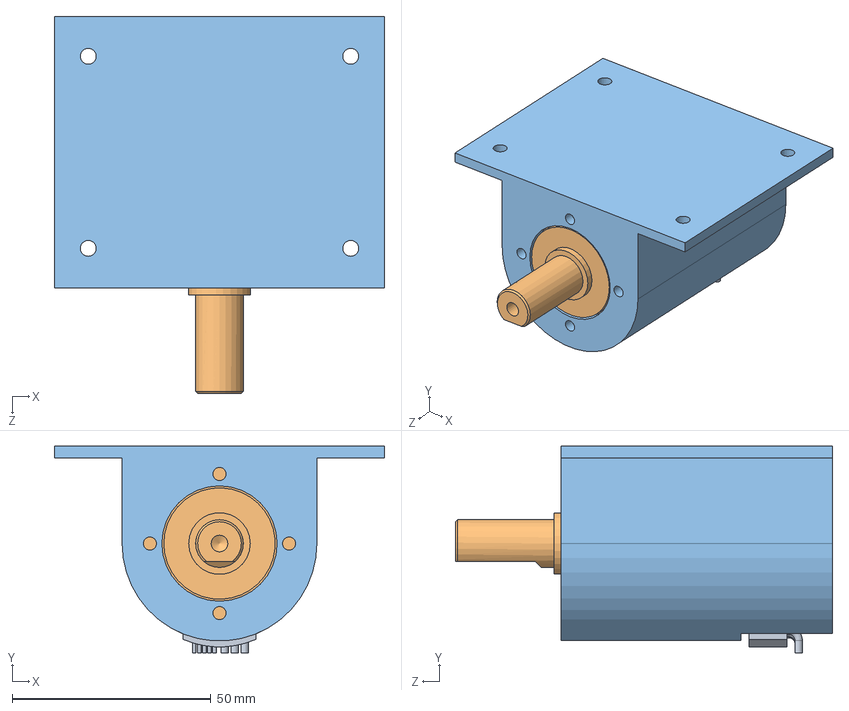
[picture p49: CAD file, 2024-01-29]
CAD/CDR_2023/Robot_1/1.Base roulante/base roulante/Assemblage Total moteur-cache.SLDASM
83.0 x 52.0 x 94.8 mm
4221G_BXTH _ moteur
42gpt-2stage_standard+KSx _ reducteur
Cache moteur
