DaVinciBot/CDR-CAD/CAD/CDR_2023/Robot_2/6.Cartes électroniques/Carte-mère.SLDASM

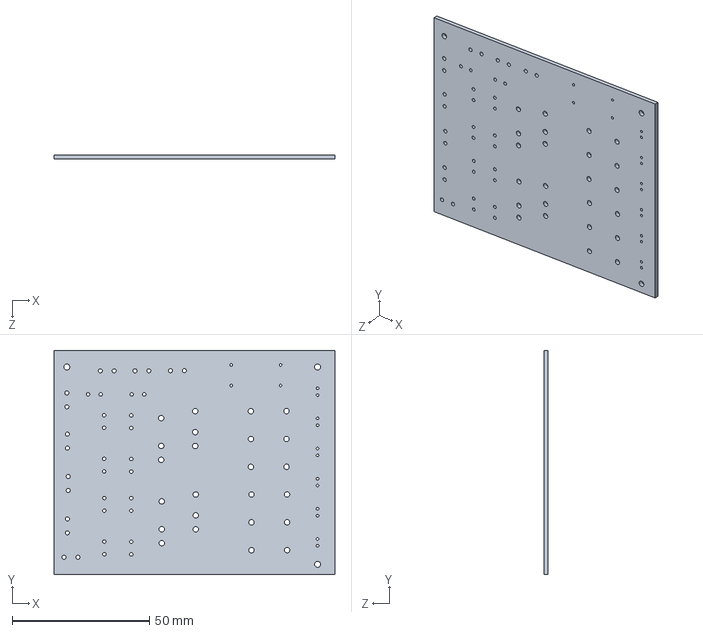
[picture p50: CAD file, 2024-01-29]
CAD/CDR_2023/Robot_2/6.Cartes électroniques/Carte-mère.SLDASM
102.5 x 81.8 x 1.60 mm
