DaVinciBot/CDR-CAD/CAD/CDR_2023/Robot_2/Robot/Rdc/base roulante/encodeurs/Systeme Encodeurs Partie Mobile.SLDASM

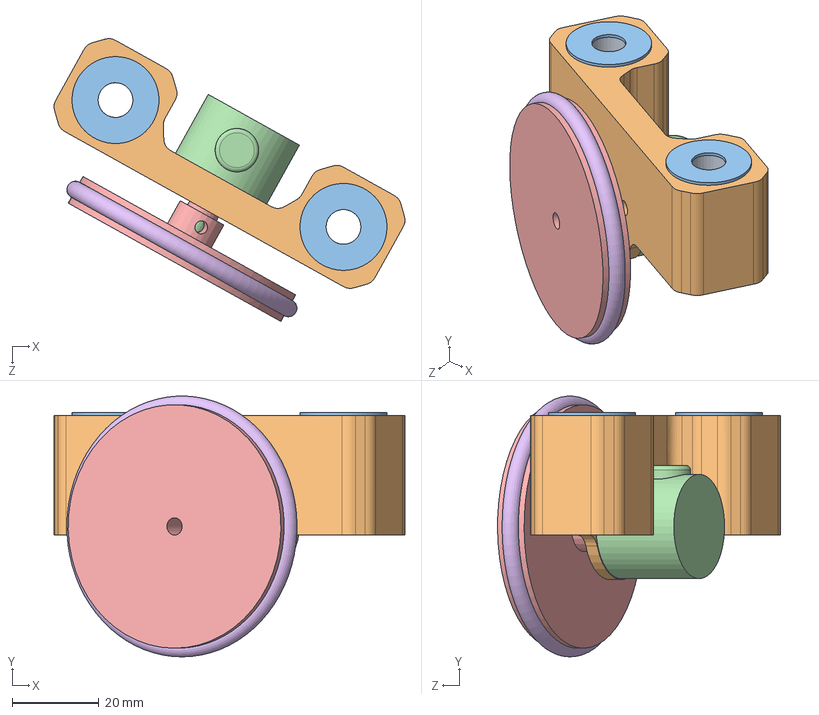
[picture p51: CAD file, 2024-01-29]
CAD/CDR_2023/Robot_2/Robot/Rdc/base roulante/encodeurs/Systeme Encodeurs Partie Mobile.SLDASM
80.7 x 60.0 x 65.1 mm
Roulement linéaire x 2
Support Encodeurs
Rondelle M8 x 2
Codeurs Kuebler D24
Roue folle D56 BRS
Joint Torique D52 T4 BRS
