DaVinciBot/CDR-CAD/CAD/CDR_2024/Robot Main/4.Cartes électroniques/Etage_elec_Robot_Main.SLDPRT

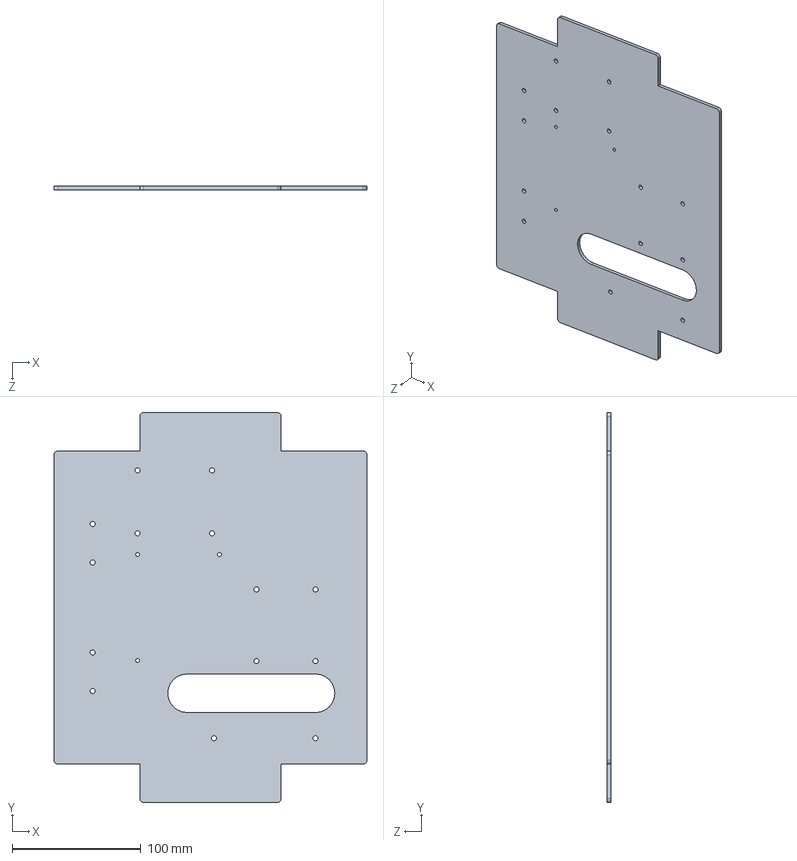
[picture p52: CAD file, 2024-04-08]
CAD/CDR_2024/Robot Main/4.Cartes électroniques/Etage_elec_Robot_Main.SLDPRT
243.5 x 303.5 x 3.00 mm
