DaVinciBot/CDR-CAD/CAD/CDR_2023/Robot_2/3.Deuxième étage/stockage cerises.SLDASM

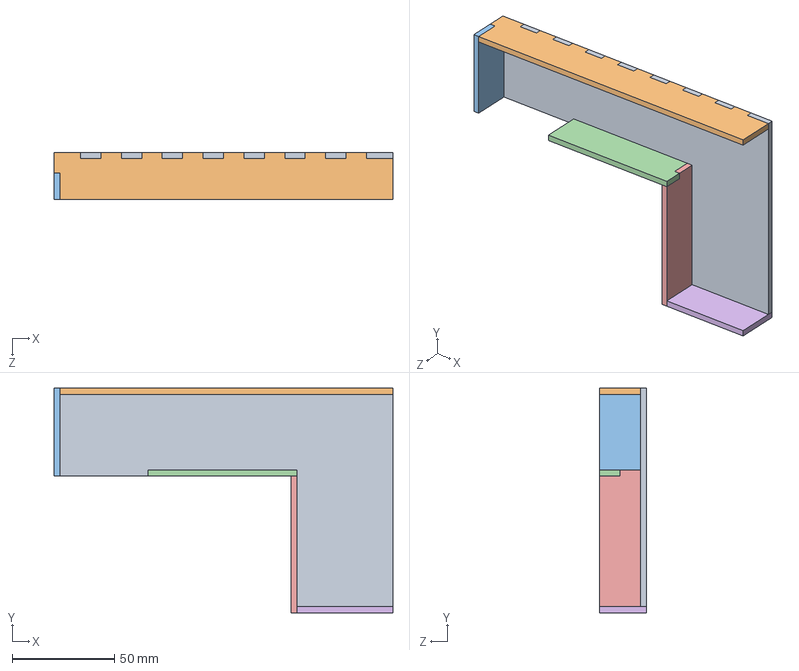
[picture p53: CAD file, 2024-01-29]
CAD/CDR_2023/Robot_2/3.Deuxième étage/stockage cerises.SLDASM
166.0 x 110.0 x 23.0 mm
Pente stockage cerise
Mur extérieur pente cerise
Mur haut pente cerise
Mur intérieur 1 pente cerise
Mur intérieur 2 pente cerise
Mur intérieur 3 pente cerise
