DaVinciBot/CDR-CAD/CAD/CDR_2024/Robot Main/3.Actioneur/Main De Dieu/Tige_Guide_Main_De_Dieu_10mm.SLDPRT

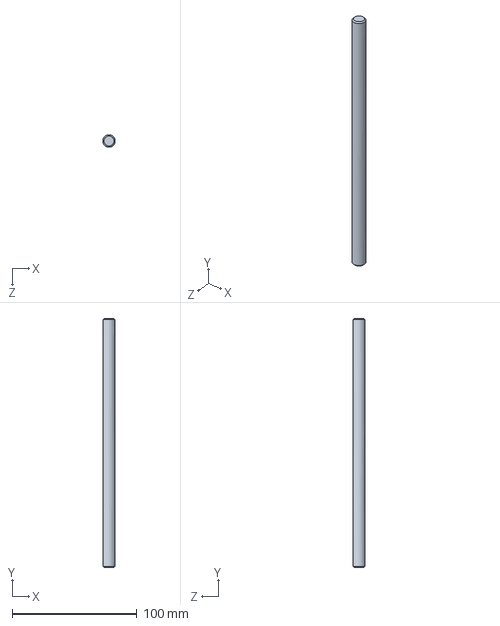
[picture p54: CAD file, 2025-04-10]
CAD/CDR_2024/Robot Main/3.Actioneur/Main De Dieu/Tige_Guide_Main_De_Dieu_10mm.SLDPRT
9.99 x 200.0 x 10.0 mm
