DaVinciBot/CDR-CAD/CAD/CDR_2023/Robot_1/1.Base roulante/base roulante/Assemnlage base roulante V2.SLDASM

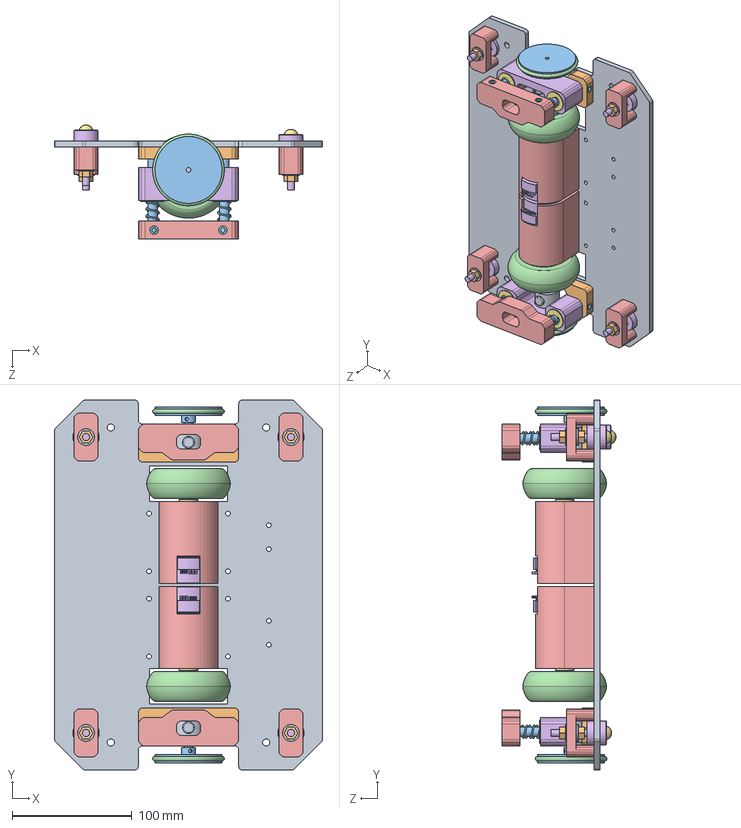
[picture p55: CAD file, 2024-01-29]
CAD/CDR_2023/Robot_1/1.Base roulante/base roulante/Assemnlage base roulante V2.SLDASM
224.5 x 309.5 x 95.5 mm
plaque base roulante 2
moyeu pololu (axe 5mm) part 2 x 2
moyeux pololu (axe 5mm) x 2
Roue Scooter noire 70x25 mm 3272 x 2
Support Bille porteuse x 4
Bille porteuse ALWAYE D12_7 x 4
Bille D12 x 4
Insert M4 x 28
Rondelle M6 x 16
Ecrou M6 x 8
Axe_Support_Codeurs x 4
Roulement linéaire x 4
Support Ressort x 2
Support Encodeurs x 2
Rondelle M8 x 4
Ressort M8 x 4
Codeurs Kuebler D24 x 2
Support Plaque Encodeurs x 2
Roue folle D56 BRS x 2
Joint Torique D52 T4 BRS x 2
Cache moteur_V2 x 2
4221G_BXTH _ moteur x 2
42gpt-2stage_standard+KSx _ reducteur x 2
