DaVinciBot/CDR-CAD/CAD/CDR_2023/Robot_2/1.Base roulante/Réception billes/Assemblage bac récepteur cerises.SLDASM

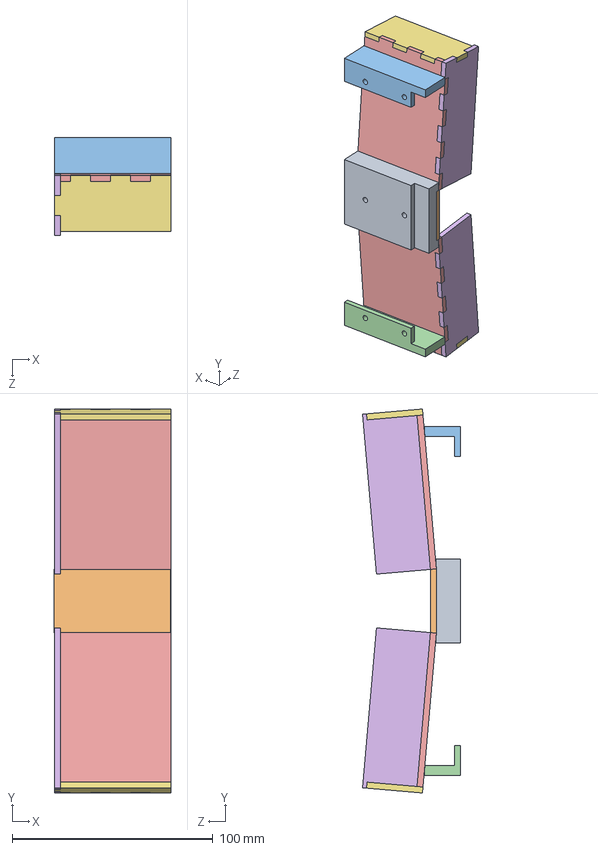
[picture p56: CAD file, 2024-01-29]
CAD/CDR_2023/Robot_2/1.Base roulante/Réception billes/Assemblage bac récepteur cerises.SLDASM
58.1 x 191.4 x 48.8 mm
Support pente centrale
Pente centrale
Support pente droit
Support pente gauche
Pente billes gauche x 2
Mur pente base x 2
Mur 2 pente base x 2
