DaVinciBot/CDR-CAD/CAD/CDR_2023/Robot_1/Assemblage_Robot_1_V2.SLDASM

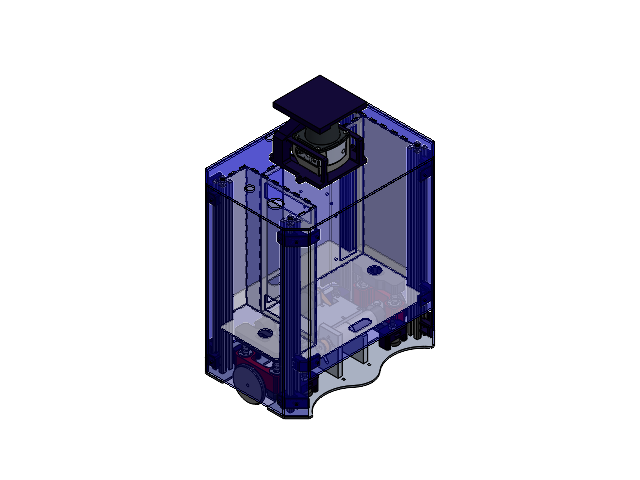
[picture p57: CAD file, 2024-04-08]
CAD/CDR_2023/Robot_1/Assemblage_Robot_1_V2.SLDASM
plaque BR ancien Faulhaber finale
Axe_Support_Codeurs x 4
Roulement linéaire x 4
Support Ressort x 2
Support Encodeurs x 2
Rondelle M8 x 4
Ressort M8 x 4
Insert M4 x 12
Codeurs Kuebler D24 x 2
Support Plaque Encodeurs x 2
Roue folle D56 BRS x 2
Joint Torique D52 T4 BRS x 2
Support Bille porteuse V3 x 4
Bille porteuse ALWAYE D12_7 x 4
Bille D12 x 4
Ecrou M6 x 8
Insert_M3x8x5 x 8
Support Moteur BRS x 2
Moteur faulhaber D26 BRS Access x 2
Poulie D32 BRS x 2
Poulie D20 BRS x 2
Courroie tendu BRS x 2
Support Axe Roue BRS x 2
Support Dessus Moteur Axe BRS
Profilé Aluminium Bosch Rexroth 20 x 20 x 310 mm x 4
Plaque etage 1 BreadBoard
Plaque coté batterie x 2
Plaque coté actionneur
Plaque arrière robot
Plaque arrière batterie
support_plexi_vis_3mm_angle_1 x 6
face arrière robot 1
face angles x 4
face cotés x 2
support_plexi_vis_3mm_angle_2 x 2
support_plexi_vis_3mm_angle_3 x 2
face avant
Toit_Robot_1
TIM561-Part
Support Sick TIM562 Haut Robot 1
Support Sick TIM562 Bas Robot 1
