DaVinciBot/CDR-CAD/CAD/CDR_2024/Robot Main/1.Base roulante/Assemblage Base roulante.SLDASM

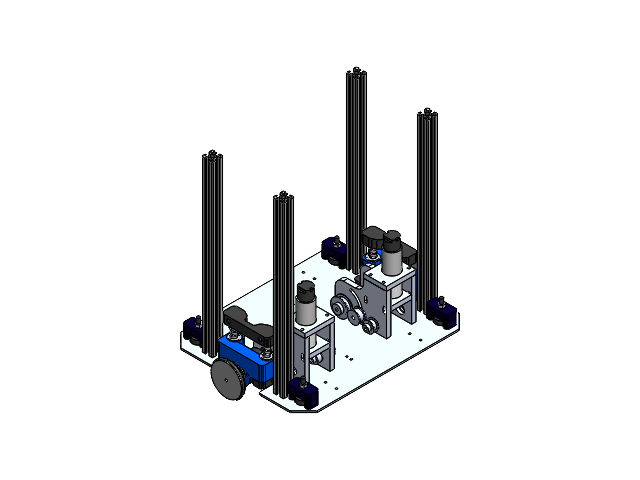
[picture p58: CAD file, 2025-04-10]
CAD/CDR_2024/Robot Main/1.Base roulante/Assemblage Base roulante.SLDASM
Plaque Base Roulante 1
Profilé Aluminium Bosch Rexroth 20 x 20 x 310 mm x 4
Support Bille porteuse V3 x 4
Bille porteuse ALWAYE D12_7 x 4
Bille D12 x 4
Ecrou M6 x 8
Insert_M3x8x5 x 8
Plaque_Droite_Bloc_Moteur_Droit
Plaque_Gauche_Bloc_Moteur_Droit
Plaque_Axe_Moteur x 2
Plaque_Support_Moteur x 2
Poulie_D20 x 2
Poulie_D22 x 2
Poulie_D32 x 2
Ecrou_M6 x 4
Engrenage_Biseau_45 x 4
Rondelle_D5x11x1 x 6
Moteur_Faulhaber_D26 x 2
Plaque_Droite_Bloc_Moteur_Gauche
Plaque_Gauche_Bloc_Moteur_Gauche
Support_Plaque_Encodeurs_V2 x 2
Axe_Guide_Encodeur_V2 x 4
Support_Ressort_V2 x 2
Ressort_M8_V2 x 4
Support_Encodeurs_V2 x 2
codeurs_travelers x 2
Roulement_Lineaire_V2 x 4
Rondelle_M8_V2 x 4
Roue folle D56 BRS x 2
Joint Torique D52 T4 BRS x 2
