DaVinciBot/CDR-CAD/CAD/CDR_2024/Robot Main/3.Actioneur/Ascenseur Barillet/Barillet 1/Assemblage Barillet 1.SLDASM

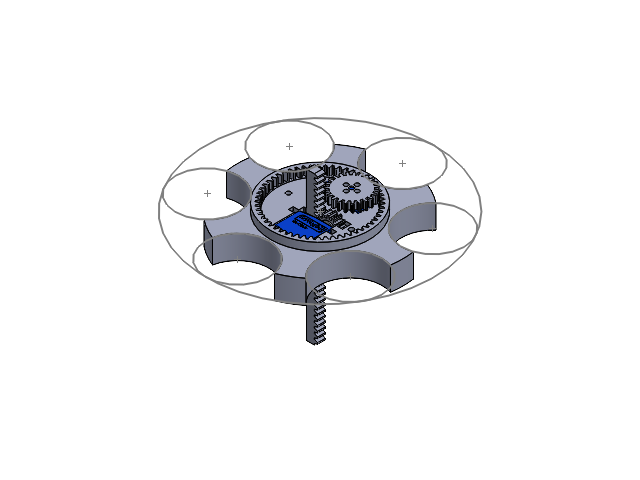
[picture p59: CAD file, 2024-01-29]
CAD/CDR_2024/Robot Main/3.Actioneur/Ascenseur Barillet/Barillet 1/Assemblage Barillet 1.SLDASM
Barillet 1 fixe
Barillet 1 dynamique
Engrenage (pignon cremaillere)
Cremaillere (pignon cremaillere)
Parallax Servo 900-00005 x 2
Engrenage (ring gear)
