DaVinciBot/CDR-CAD/CAD/CDR_2024/Robot Main/3.Actioneur/Joute solaire/Proto3_Horiz_Larg_Long/Assemblage_Joute_Solaire.SLDASM

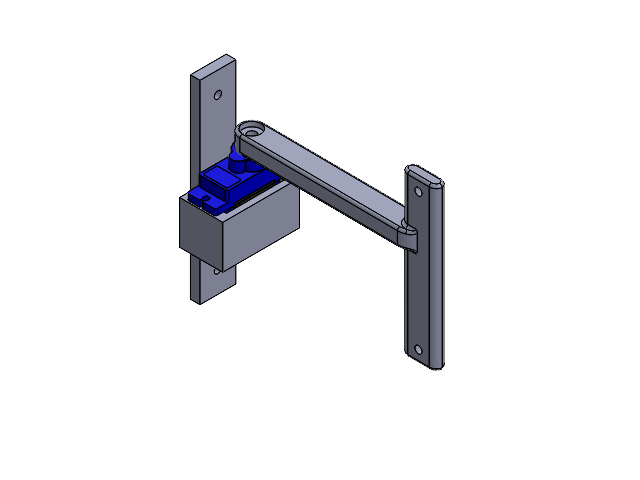
[picture p60: CAD file, 2025-04-10]
CAD/CDR_2024/Robot Main/3.Actioneur/Joute solaire/Proto3_Horiz_Larg_Long/Assemblage_Joute_Solaire.SLDASM
Support_Servo_Horiz
Servo_SG90
Bras_Panneau_Solaire_Horiz_Flex_New
