DaVinciBot/CDR-CAD/CAD/CDR_2024/Robot Main/3.Actioneur/Main De Dieu/Assemblage_Main_De_Dieu_V3.SLDASM

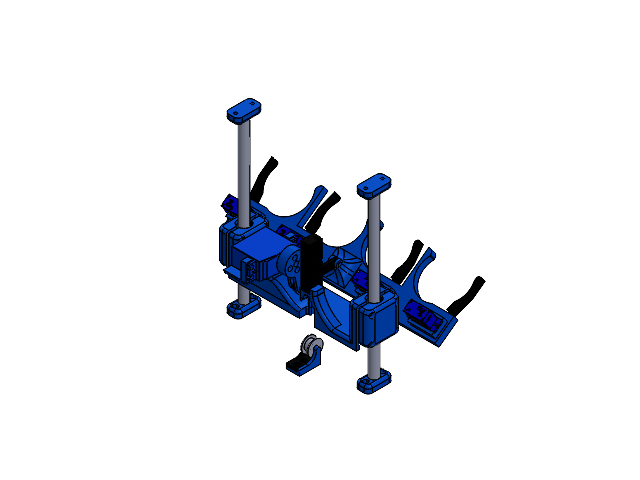
[picture p61: CAD file, 2026-01-05]
CAD/CDR_2024/Robot Main/3.Actioneur/Main De Dieu/Assemblage_Main_De_Dieu_V3.SLDASM
Support_Main_De_Dieu_V3
Support_Main_De_Dieu_V3_Capsule_Roulement x 2
Main_De_Dieu
Doigt_De_Dieu_1 x 2
Doigt_De_Dieu_2 x 2
Servo_SG90 x 4
Poulie_GT2_12mm x 2
Servo_Parallax_900-00005
Articulation_De_Dieu_1
Articulation_De_Dieu_2
Tige_Guide_Main_De_Dieu_10mm x 2
Support_Tige_Main_De_Dieu x 4
