DaVinciBot/CDR-CAD/CAD/CDR_2024/Robot Main/4.Cartes électroniques/Assemblage_Etage_Electrronique.SLDASM

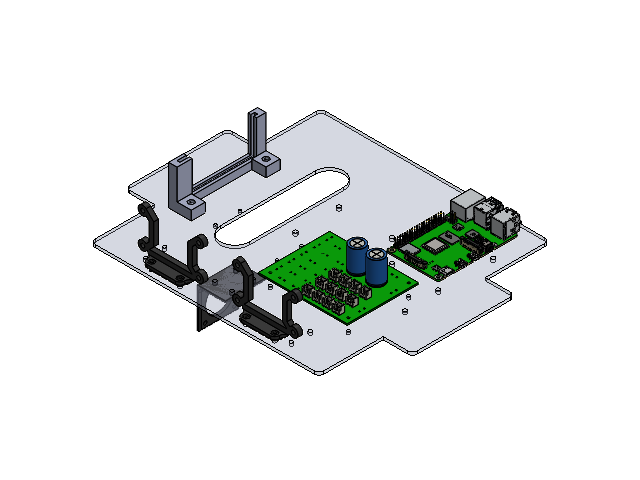
[picture p62: CAD file, 2026-01-05]
CAD/CDR_2024/Robot Main/4.Cartes électroniques/Assemblage_Etage_Electrronique.SLDASM
Etage_Electronique_Robot_Main
Support_LM2596S x 2
Support_Shield_Moteur
Raspberry Pi 4 Model B
SOLID.step x 12
SOLID-0.step x 2
Carte_Alim_V1_CDR2024 PCB.step
Support_Moteur_Ascenseur
