DaVinciBot/CDR-CAD/CAD/CDR_2024/Robot Main/Assemblage_Robot_Main.SLDASM

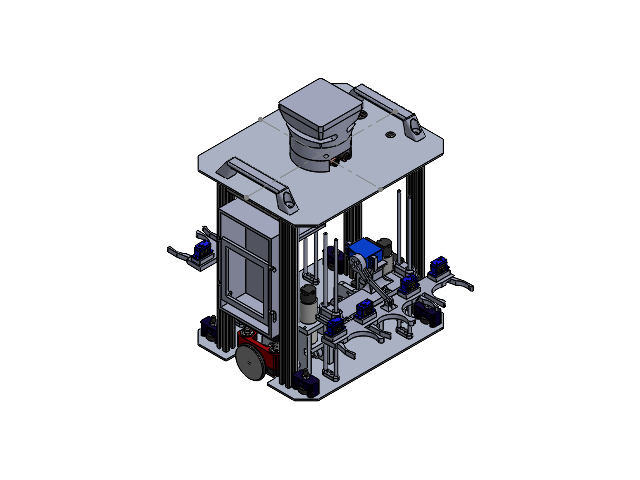
[picture p63: CAD file, 2024-03-21]
CAD/CDR_2024/Robot Main/Assemblage_Robot_Main.SLDASM
Plaque Base Roulante 1
Profilé Aluminium Bosch Rexroth 20 x 20 x 310 mm x 4
Support Bille porteuse V3 x 4
Bille porteuse ALWAYE D12_7 x 4
Bille D12 x 4
Ecrou M6 x 8
Insert_M3x8x5 x 8
Profilé Aluminium Bosch Rexroth 20 x 20 x 110 mm x 2
Plaque_Droite_Bloc_Moteur_Droit
Plaque_Gauche_Bloc_Moteur_Droit
Plaque_Axe_Moteur x 2
Plaque_Support_Moteur x 2
Poulie_D20 x 2
Poulie_D22 x 2
Poulie_D32 x 2
Ecrou_M6 x 4
Engrenage_Biseau_45 x 4
Rondelle_D5x11x1 x 6
Moteur_Faulhaber_D26 x 2
Plaque_Droite_Bloc_Moteur_Gauche
Plaque_Gauche_Bloc_Moteur_Gauche
Axe_Support_Codeurs x 4
Roulement linéaire x 4
Support Ressort x 2
Support Encodeurs x 2
Rondelle M8 x 4
Ressort M8 x 4
Insert M4 x 12
Codeurs Kuebler D24 x 2
Support Plaque Encodeurs x 2
Roue folle D56 BRS x 2
Joint Torique D52 T4 BRS x 2
Compartiement_Batterie
Support_Porte_Batterie
Support_Tige_Main_De_Dieu_V2 x 4
Tige_Guide_Main_De_Dieu x 8
Support_Main_De_Dieu_V2 x 2
Main_De_Dieu x 2
Doigt_De_Dieu_1 x 4
Doigt_De_Dieu_2 x 4
Servo_SG90 x 8
Servo_Parallax_900-00005 x 2
Articulation_De_Dieu_1 x 2
Articulation_De_Dieu_2 x 2
Plaque Toit_Robot_Main
Boitier Lidar Bas
Lidar TIM561-Part
Boitier Lidar Haut
Poingee_Toit x 2
