DaVinciBot/CDR-CAD/CAD/CDR_2024/Zone de calcul/Prototype/ecran/screen arm.SLDASM

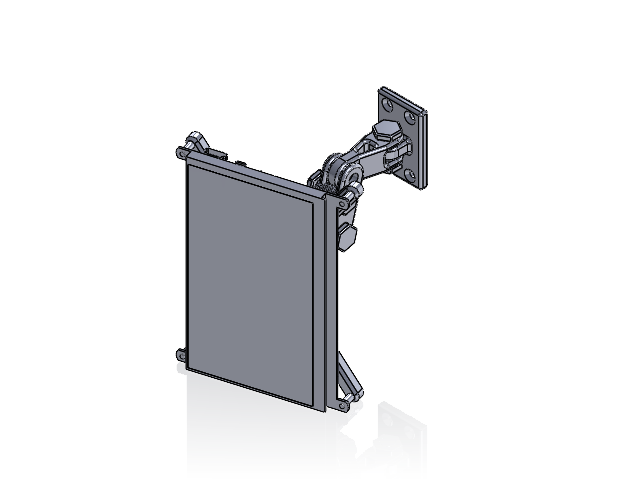
[picture p64: CAD file, 2024-03-12]
CAD/CDR_2024/Zone de calcul/Prototype/ecran/screen arm.SLDASM
profile plate
screen plate
screen.stp
entretoise x 4
screen arm male female x 2
screen arm female flat
M10x25 bolt x 4
M10 nut x 4
