DaVinciBot/CDR-CAD/CAD/CDR_2025/Banderole/Assemblage_Banderole.SLDASM

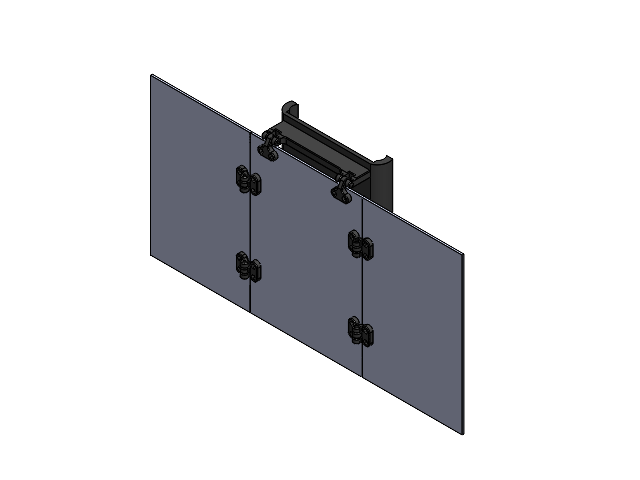
[picture p65: CAD file, 2025-09-29]
CAD/CDR_2025/Banderole/Assemblage_Banderole.SLDASM
Maintien_Banderole
Panneau_Centre
Chraniere_Centre x 2
Chraniere_Lateral_1 x 4
Panneau_Lateral x 2
Chraniere_Lateral_2 x 4
