DaVinciBot/CDR-CAD/CAD/CDR_2025/Robot_Main/1.Base_Roulante/1.Bloc_Moteur_2.0/1.Parties_Moteur_FAULHABER/Moteur_FAULHABER_3242G012CR_+_Reducteur_32GPT-4.5-1.SLDPRT.SLDASM

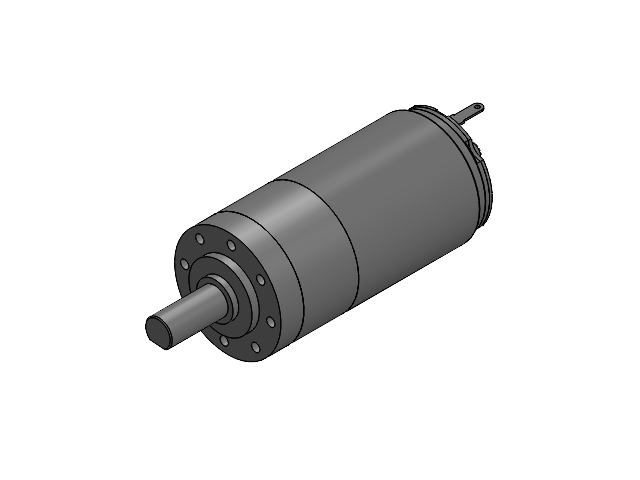
[picture p66: CAD file, 2025-02-25]
CAD/CDR_2025/Robot_Main/1.Base_Roulante/1.Bloc_Moteur_2.0/1.Parties_Moteur_FAULHABER/Moteur_FAULHABER_3242G012CR_+_Reducteur_32GPT-4.5-1.SLDPRT.SLDASM
Moteur_FAULHABER_3242G012CR
Reducteur_FAULHABER_32GPT-4.5-1
