DaVinciBot/CDR-CAD/CAD/CDR_2025/Robot_Main/1.Base_Roulante/1.Bloc_Moteur_2.0/3.Roue_Faite_Maison/Roue_60mm/Assemblage_Roue_60mm.SLDASM

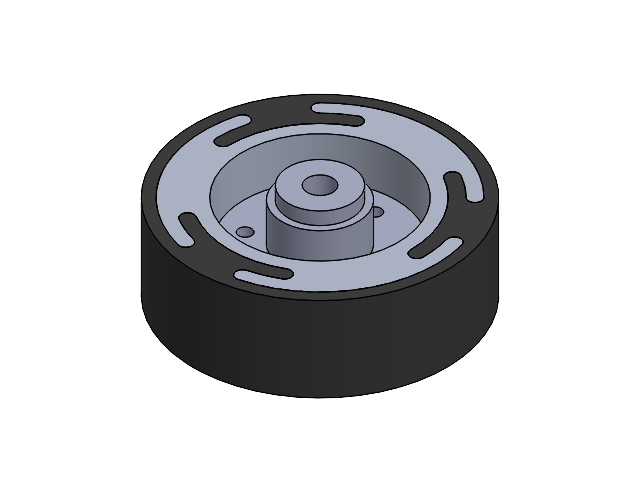
[picture p67: CAD file, 2025-01-13]
CAD/CDR_2025/Robot_Main/1.Base_Roulante/1.Bloc_Moteur_2.0/3.Roue_Faite_Maison/Roue_60mm/Assemblage_Roue_60mm.SLDASM
Jante_60mm
Pneu_Polyuretane_60mm
Moyeu_60mm
