DaVinciBot/CDR-CAD/CAD/CDR_2025/Robot_Main/1.Base_Roulante/1.Bloc_Moteur_2.0/Assemblage_Bloc_Moteur_3242G012CR.SLDASM

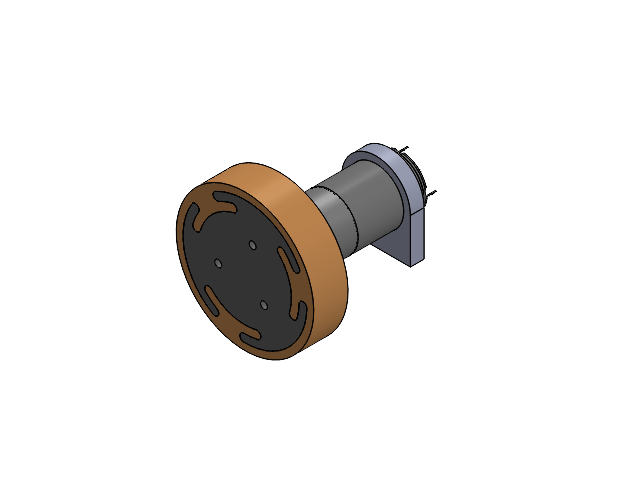
[picture p68: CAD file, 2025-04-10]
CAD/CDR_2025/Robot_Main/1.Base_Roulante/1.Bloc_Moteur_2.0/Assemblage_Bloc_Moteur_3242G012CR.SLDASM
Moteur_FAULHABER_3242G012CR
Reducteur_FAULHABER_32GPT-4.5-1
Support_Moteur_Avant_3242G012CR
Jante_80mm
Pneu_Polyuretane_80mm
Moyeu_80mm
Support_Moteur_Arriere_3242G012CR
