DaVinciBot/CDR-CAD/CAD/CDR_2025/Robot_Main/1.Base_Roulante/Assemblage_Base_Roulante_2.0.SLDASM

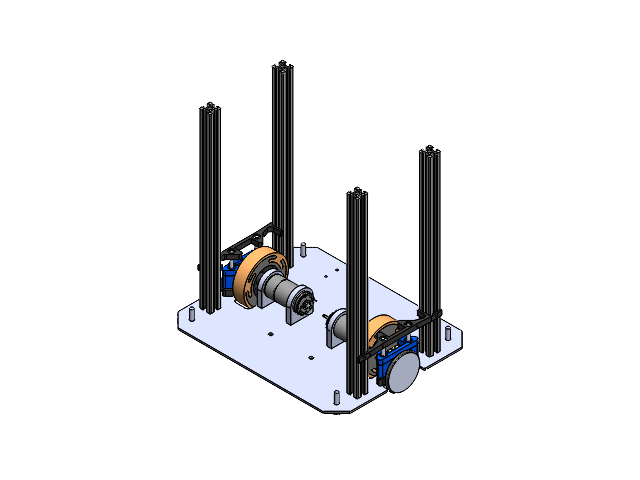
[picture p69: CAD file, 2025-09-29]
CAD/CDR_2025/Robot_Main/1.Base_Roulante/Assemblage_Base_Roulante_2.0.SLDASM
Plaque_Base_Roulante_2.0
Support_Roue_Encodeuse x 2
Same_Sky_AMT-102-Base-REV-K x 2
Same_Sky_AMT-102-Top-Cover-REV-I x 2
Same_Sky_AMT-Sleeve-REV-D(5 mm) x 2
Same_Sky_AMT-Hub-Top-REV-D1 x 2
Same_Sky_AMT-Hub-Bottom-REV-B x 2
Same_Sky_AMT10X-Shaft-Adaptor-REV-E x 2
Same_Sky_Receiver-board x 2
Same_Sky_Rotor-board-REV F x 2
Same_Sky_Transmitter-board AMT10(AMT-102) x 2
Roulement_Lineaire_LME5UU x 4
Roue_Encodeuse x 2
Tige_Guide_Roue_Encodeuse x 4
Support_Haut_Tige_Guide_Roue_Encodeuse x 2
Support_Bas_Tige_Guide_Roue_Encodeuse x 2
Rondelle_5mm_10mm x 4
Support_Haut_Roue_Encodeuse x 2
Joint_Torique_4mm_52mm_Sous_Tension x 2
Patin x 4
Moteur_FAULHABER_3242G012CR x 2
Reducteur_FAULHABER_32GPT-4.5-1 x 2
Support_Moteur_Avant_3242G012CR x 2
Jante_80mm x 2
Pneu_Polyuretane_80mm x 2
Moyeu_80mm x 2
Support_Moteur_Arriere_3242G012CR x 2
Profilé_Aluminium_Bosch_Rexroth_20_x_20_x_310_mm x 4
Rondelle_Patin x 4
