DaVinciBot/CDR-CAD/CAD/CDR_2025/Robot_Main/3.Actionneur/1.Ascenseur/Assemblage_Rail_Linéraie.SLDASM

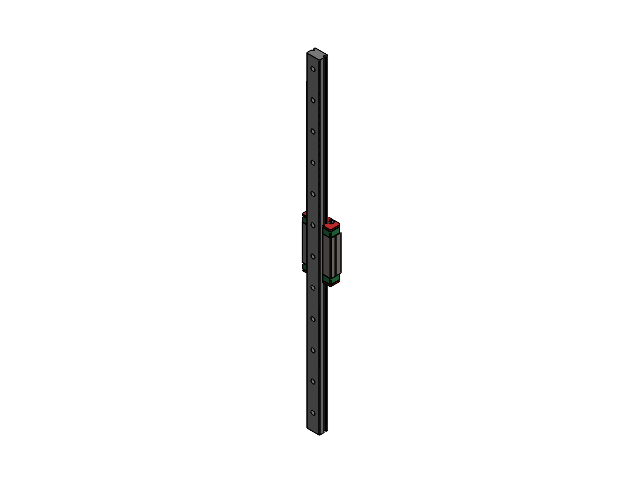
[picture p70: CAD file, 2025-09-29]
CAD/CDR_2025/Robot_Main/3.Actionneur/1.Ascenseur/Assemblage_Rail_Linéraie.SLDASM
MGNR12RHM_L300(15x25)
MGN12H_LINEAR_GUIDE_BLOCK
