DaVinciBot/CDR-CAD/CAD/CDR_2025/Robot_Main/3.Actionneur/2.Usine_A_Gradins/2.Attrape_Colonne/Assemblage_Attrape_Colonne_Aimant_Gauche_V4.SLDASM

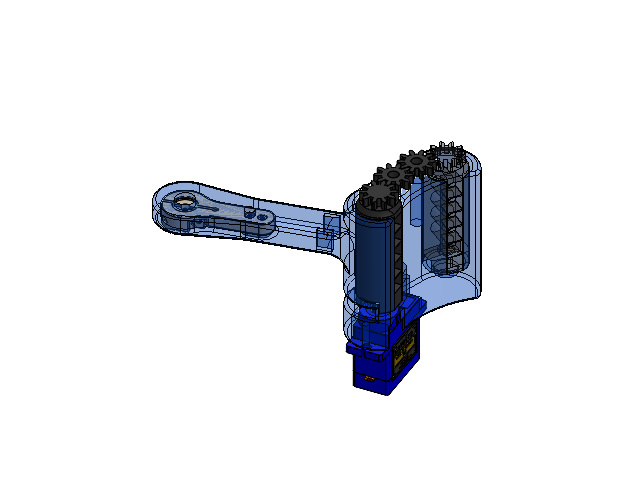
[picture p71: CAD file, 2025-09-29]
CAD/CDR_2025/Robot_Main/3.Actionneur/2.Usine_A_Gradins/2.Attrape_Colonne/Assemblage_Attrape_Colonne_Aimant_Gauche_V4.SLDASM
Attrape_Colonne_Aimant_Gauche_V4
Servo_Arm_MS24
Halbach_Array_5_Aimants_V3_Servo x 2
Engrenage_Module_1_10_Dents x 2
Servo_SG90
