DaVinciBot/CDR-CAD/CAD/CDR_2025/Robot_Main/3.Actionneur/2.Usine_A_Gradins/3.Pince_A_Planche/Assemblage_Pince_A_Planche.SLDASM

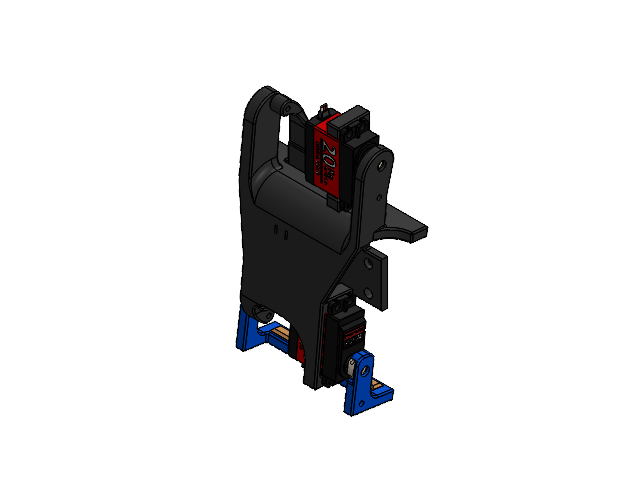
[picture p72: CAD file, 2025-09-29]
CAD/CDR_2025/Robot_Main/3.Actionneur/2.Usine_A_Gradins/3.Pince_A_Planche/Assemblage_Pince_A_Planche.SLDASM
Servo_Arm_MS24 x 2
Digital_Servo_MS24_270 x 2
Pince_A_Planche_Pince
Patin_Pince
Support_Servo_Pince_A_Planche
Bras_Pince_A_Planche
Patin_Pince_Moyen
Patin_Pince_Petit
