DaVinciBot/CDR-CAD/CAD/CDR_2025/Robot_Main/3.Actionneur/2.Usine_A_Gradins/Assemblage_Usine_A_Gradins.SLDASM

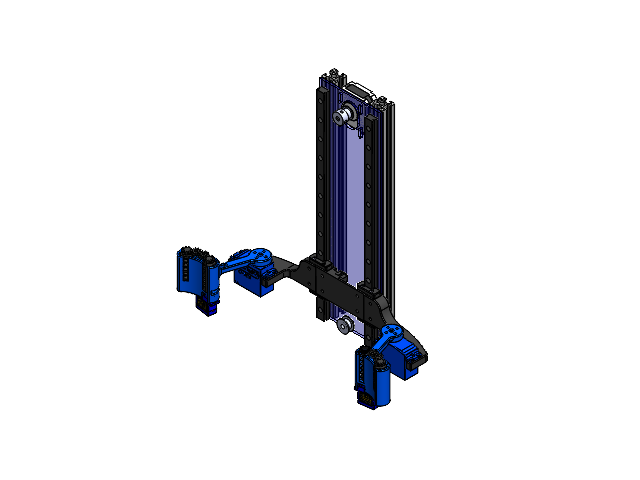
[picture p73: CAD file, 2025-02-25]
CAD/CDR_2025/Robot_Main/3.Actionneur/2.Usine_A_Gradins/Assemblage_Usine_A_Gradins.SLDASM
MGNR12RHM_L300(15x25) x 2
MGN12H_LINEAR_GUIDE_BLOCK x 2
Plaque_Support_Ascenseur
Moteur_Stepper_17HS08-1004S
Jonction_Courroie_Chariot
Poulie_GT2_12mm_W6_T20
Poulie_De_Distribution_GT2_12mm_W6_T20
Profilé_Aluminium_Bosch_Rexroth_20_x_20_x_310_mm x 2
Support_Bras_Gauche
Servo_Parallax_900-00005 x 2
Support_Bras_Droit
Attrape_Colonne_Aimant_Gauche_V3
Halbach_Array_5_Aimants_V3_Servo x 2
Servo_SG90 x 2
Engrenage_Module_1_10_Dents x 4
Halbach_Array_5_Aimants_V3 x 2
Attrape_Colonne_Aimant_Droit_V3
