DaVinciBot/CDR-CAD/CAD/CDR_2025/Robot_Main/4.Electronique/Teensy_Sheild_Actionneur.SLDASM

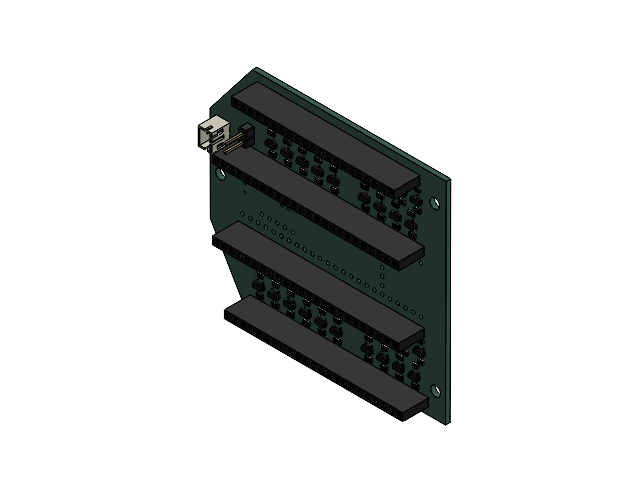
[picture p74: CAD file, 2025-05-21]
CAD/CDR_2025/Robot_Main/4.Electronique/Teensy_Sheild_Actionneur.SLDASM
SOT-23.step x 42
R_0805_2012Metric.step x 84
JST_PH_B2B-PH-K_1x02_P2.00mm_Vertical.step
PinSocket_1x21_P2.54mm_Vertical.step
PinSocket_1x24_P2.54mm_Vertical.step x 2
PinSocket_1x23_P2.54mm_Vertical.step
PinHeader_1x02_P2.54mm_Vertical.step
Shield_PCB.step
