DaVinciBot/CDR-CAD/PCB/CDR_2024/Robot_Main/Carte_Alim_V1_CDR2024.SLDASM

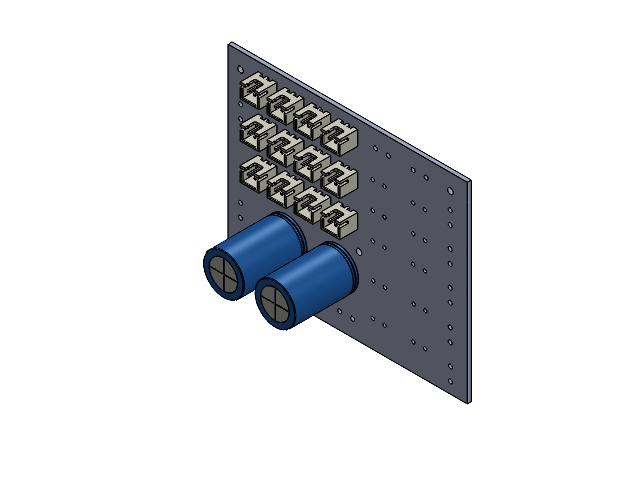
[picture p76: CAD file, 2026-01-05]
PCB/CDR_2024/Robot_Main/Carte_Alim_V1_CDR2024.SLDASM
SOLID.step x 12
SOLID-0.step x 2
Carte_Alim_V1_CDR2024 PCB.step
