DaVinciBot/CDR-CAD/CAD/CDR_2024/Robot Main/1.Base roulante/3.Roue Encodeuse/Assemblage Systeme Encodeurs.SLDASM

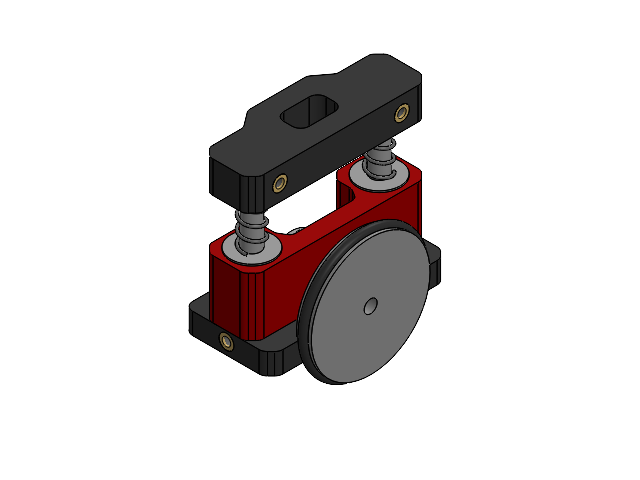
[picture p77: CAD file, 2024-05-05]
CAD/CDR_2024/Robot Main/1.Base roulante/3.Roue Encodeuse/Assemblage Systeme Encodeurs.SLDASM
Axe_Support_Codeurs x 2
Roulement linéaire x 2
Support Ressort
Rondelle M8 x 2
Ressort M8 x 2
Insert M4 x 6
Support Plaque Encodeurs
Roue folle D56 BRS
Joint Torique D52 T4 BRS
Codeurs Kuebler D24
Support Encodeur
