DaVinciBot/CDR-CAD/CAD/CDR_2024/Robot Main/1.Base roulante/3.Roue_Encodeuse_V2/Systeme_Encodeur_Mobile_V2.SLDASM

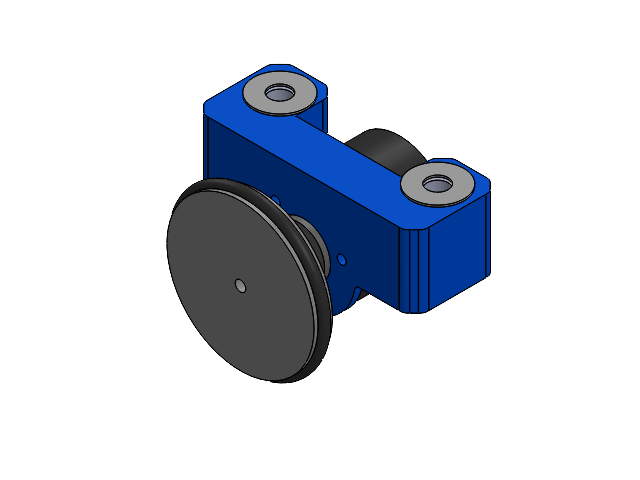
[picture p78: CAD file, 2025-04-10]
CAD/CDR_2024/Robot Main/1.Base roulante/3.Roue_Encodeuse_V2/Systeme_Encodeur_Mobile_V2.SLDASM
Support_Encodeurs_V2
codeurs_travelers
Roulement_Lineaire_V2 x 2
Rondelle_M8_V2 x 2
Roue folle D56 BRS
Joint Torique D52 T4 BRS
