DaVinciBot/CDR-CAD/CAD/CDR_2024/Robot Main/2.Dernier étage/Assemblage_Toit_Robot_Main.SLDASM

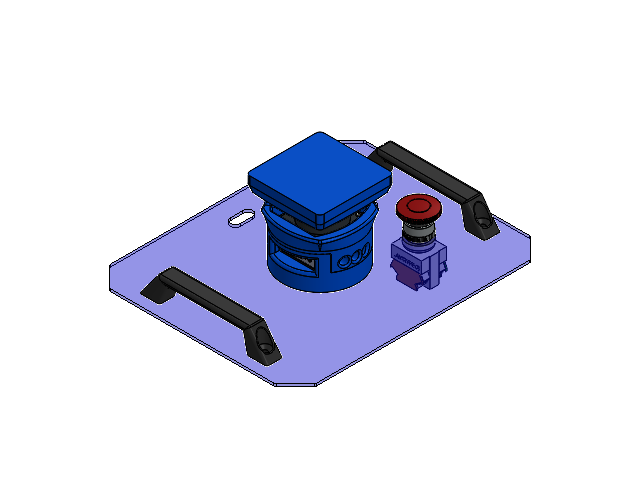
[picture p79: CAD file, 2025-05-21]
CAD/CDR_2024/Robot Main/2.Dernier étage/Assemblage_Toit_Robot_Main.SLDASM
Plaque_Toit_Robot_Main
Poingee_Toit x 2
Boitier_Lidar_Bas
Lidar_TIM561
Boitier_Lidar_Haut
Stop Switch Push Button LAY37 (PBC)
