DaVinciBot/CDR-CAD/CAD/CDR_2024/Robot Main/3.Actioneur/Joute solaire/Proto1_Verti_Horiz/Assemblage_Pic_Panneau_Solaire.SLDASM

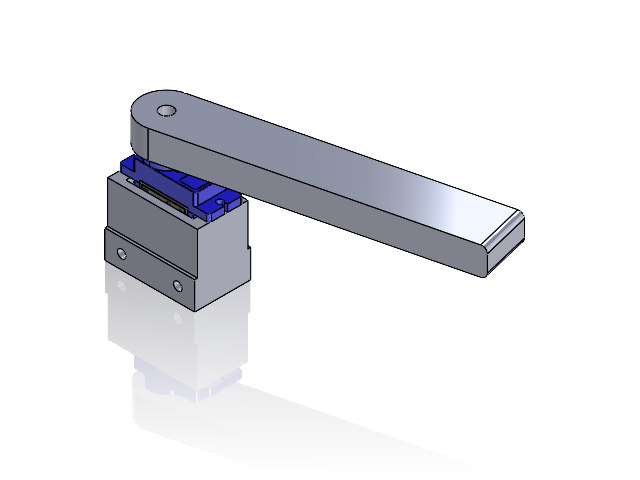
[picture p80: CAD file, 2024-10-26]
CAD/CDR_2024/Robot Main/3.Actioneur/Joute solaire/Proto1_Verti_Horiz/Assemblage_Pic_Panneau_Solaire.SLDASM
Servo_SG90
Bras_Panneau_Solaire
Support_Servo
