DaVinciBot/CDR-CAD/CAD/CDR_2024/Robot Main/Assemblage1.SLDASM

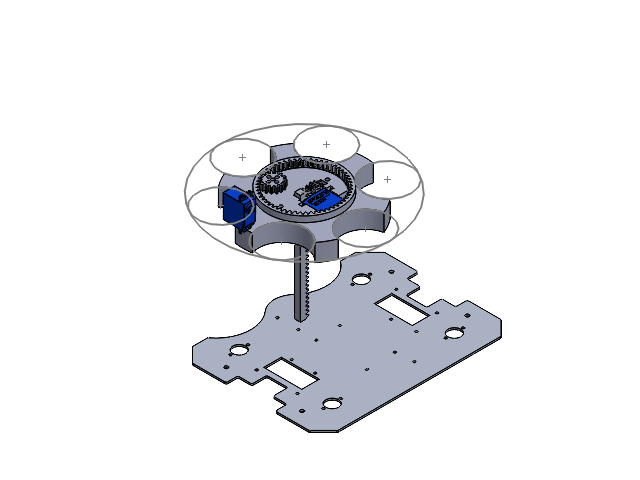
[picture p81: CAD file, 2024-01-29]
CAD/CDR_2024/Robot Main/Assemblage1.SLDASM
Plaque Base Roulante 1
Barillet 1 fixe
Barillet 1 dynamique
Engrenage (pignon cremaillere)
Cremaillere (pignon cremaillere)
Parallax Servo 900-00005 x 2
Engrenage (ring gear)
