DaVinciBot/CDR-CAD/CAD/CDR_2024/Zone de calcul/Prototype/Assemblage_Zone_de_Calcul.SLDASM

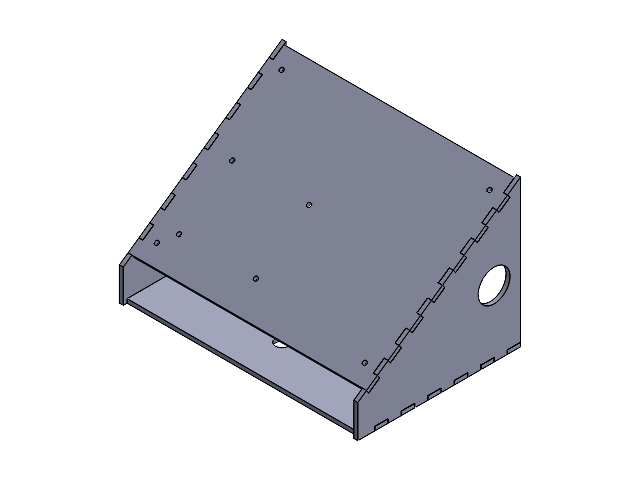
[picture p82: CAD file, 2024-01-29]
CAD/CDR_2024/Zone de calcul/Prototype/Assemblage_Zone_de_Calcul.SLDASM
Base 1
Coté 2
Coté 1
