DaVinciBot/CDR-CAD/CAD/CDR_2025/Assemblage3.SLDASM

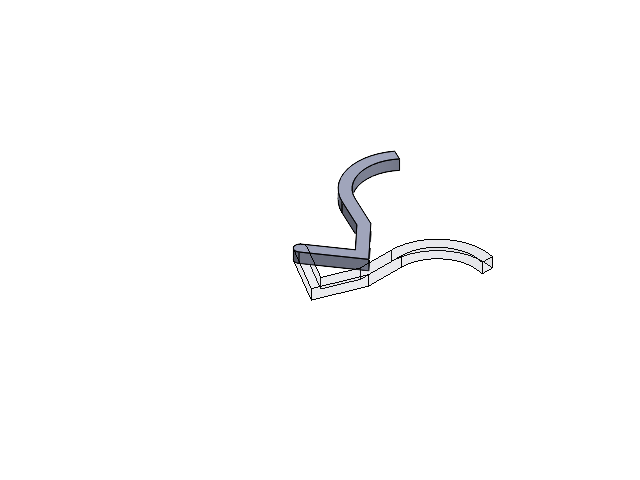
[picture p83: CAD file, 2024-10-26]
CAD/CDR_2025/Assemblage3.SLDASM
Pièce4 x 2
