DaVinciBot/CDR-CAD/CAD/CDR_2025/PAMI/Base Roulante/Assemblage Base Roulante.SLDASM

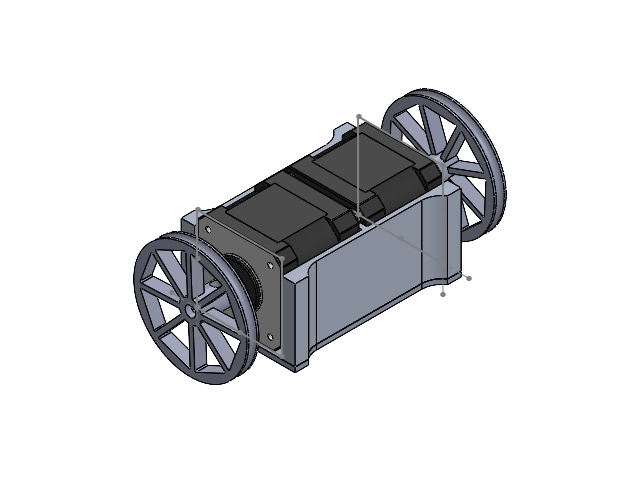
[picture p84: CAD file, 2025-05-21]
CAD/CDR_2025/PAMI/Base Roulante/Assemblage Base Roulante.SLDASM
17HM15-0904S x 2
capot moteur
Moteur double assemblé
ROUE x 2
