DaVinciBot/CDR-CAD/CAD/CDR_2025/PAMI/PAMI v3.SLDASM

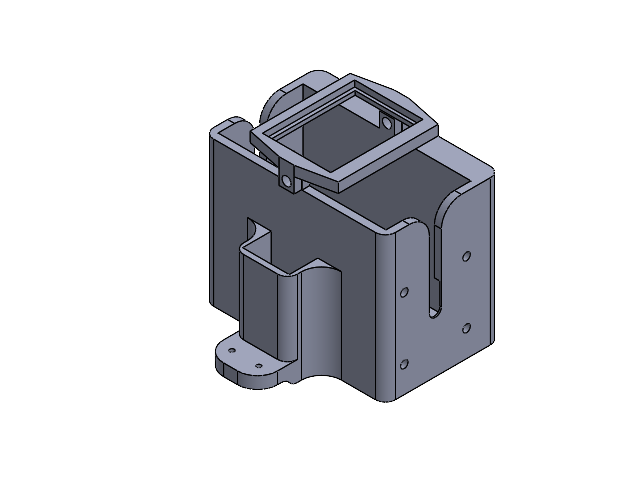
[picture p85: CAD file, 2025-05-21]
CAD/CDR_2025/PAMI/PAMI v3.SLDASM
Boitier
etage
