DaVinciBot/CDR-CAD/CAD/CDR_2025/Robot_Main/1.Base_Roulante/1.Bloc_Moteur_2.0/3.Roue_Faite_Maison/Moule_Roue_80mm/Assemblage_Moule_Roue_80mm.SLDASM

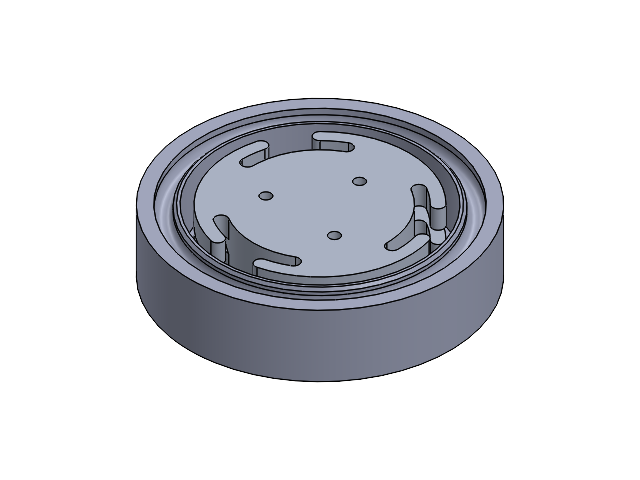
[picture p86: CAD file, 2025-02-25]
CAD/CDR_2025/Robot_Main/1.Base_Roulante/1.Bloc_Moteur_2.0/3.Roue_Faite_Maison/Moule_Roue_80mm/Assemblage_Moule_Roue_80mm.SLDASM
Jante_80mm
Moule_Roue_80mm_V2
