DaVinciBot/CDR-CAD/CAD/CDR_2025/Robot_Main/1.Base_Roulante/1.Bloc_Moteur_2.0/Assemblage_Bloc_Moteur.SLDASM

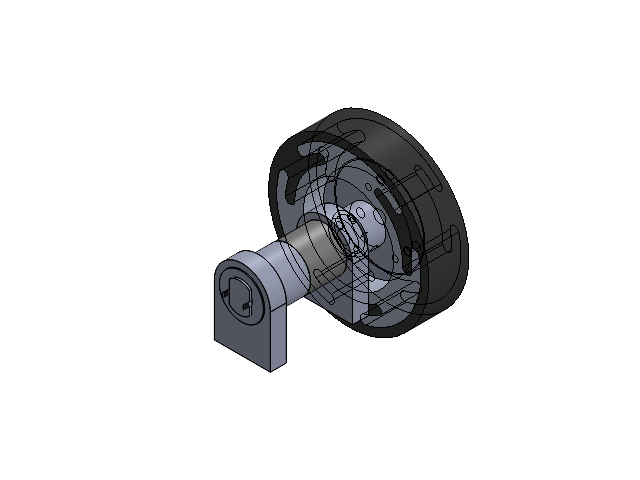
[picture p87: CAD file, 2025-01-13]
CAD/CDR_2025/Robot_Main/1.Base_Roulante/1.Bloc_Moteur_2.0/Assemblage_Bloc_Moteur.SLDASM
Support_Moteur_Avant
Moteur_FAULHABER_2224U_SR
Reducteur_FAULHABER_22GPT-14-1
Support_Moteur_Arriere
Jante_80mm
Pneu_Polyuretane_80mm
Moyeu_80mm
