DaVinciBot/CDR-CAD/CAD/CDR_2025/Robot_Main/2.Toit/Assemblage_Toit.SLDASM

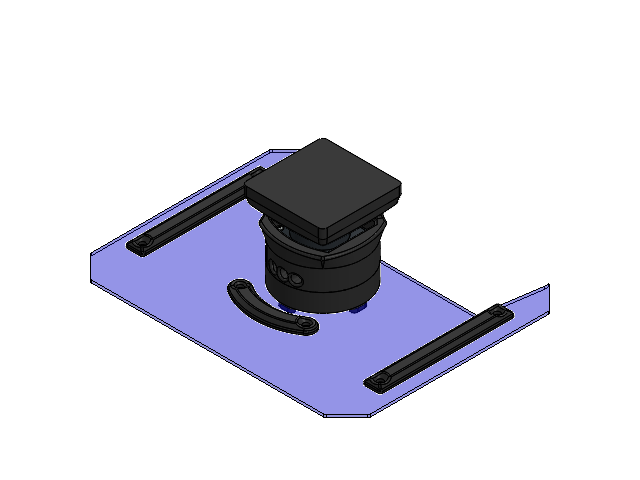
[picture p88: CAD file, 2025-09-29]
CAD/CDR_2025/Robot_Main/2.Toit/Assemblage_Toit.SLDASM
Plaque_Toit_Robot_Main_2.1
Boitier_Lidar_Bas_V2
Lidar_TIM561_V2_1
Lidar_TIM561_V2_2
Boitier_Lidar_Haut_V2
Support_Ecrou_Lidar x 2
Barre_De_Toit x 2
Barre_De_Toit_Ascenseur
