DaVinciBot/CDR-CAD/CAD/CDR_2025/Robot_Main/3.Actionneur/1.Ascenseur/Assemblage_Ascenseur.SLDASM

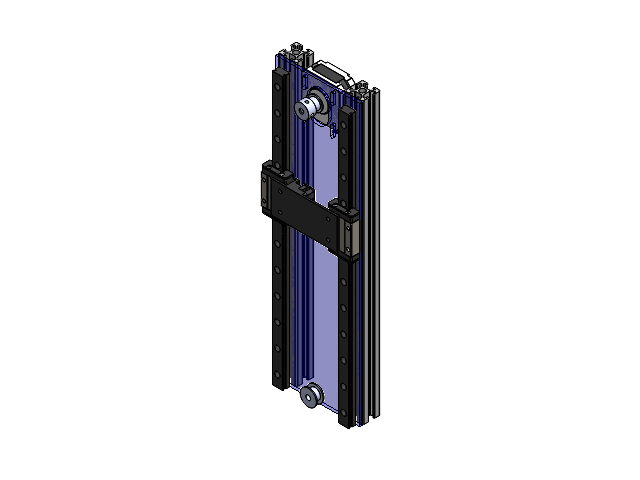
[picture p89: CAD file, 2025-09-29]
CAD/CDR_2025/Robot_Main/3.Actionneur/1.Ascenseur/Assemblage_Ascenseur.SLDASM
MGNR12RHM_L300(15x25) x 2
MGN12H_LINEAR_GUIDE_BLOCK x 2
Plaque_Support_Ascenseur
Moteur_Stepper_17HS08-1004S
Jonction_Courroie_Chariot
Poulie_GT2_12mm_W6_T20
Poulie_De_Distribution_GT2_12mm_W6_T20
Profilé_Aluminium_Bosch_Rexroth_20_x_20_x_310_mm x 2
