DaVinciBot/CDR-CAD/CAD/CDR_2025/Robot_Main/5.Plexi/Assemblage_Plexi.SLDASM

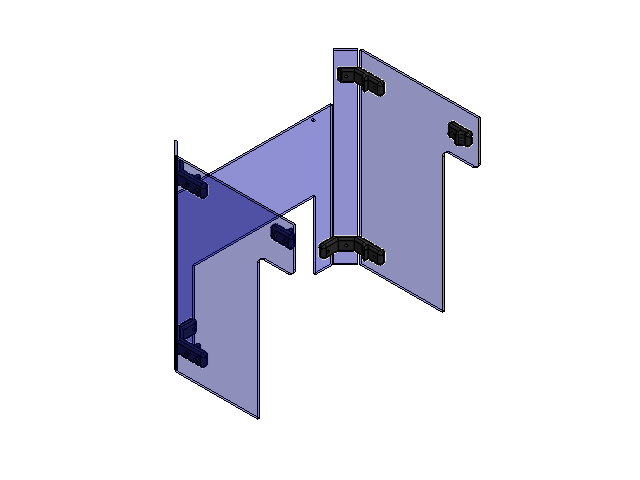
[picture p90: CAD file, 2025-09-29]
CAD/CDR_2025/Robot_Main/5.Plexi/Assemblage_Plexi.SLDASM
Support_Plexi x 2
Support_Plexi_2 x 2
Plexi_Angle_V2 x 2
Plexi_Arrière
Plexi_Latéral x 2
Support_Plexi_1 x 2
