DaVinciBot/CDR-CAD/CAD/CDR_2024/Coupe_OFF/Robot_Monster/Assemblage_teste.SLDASM

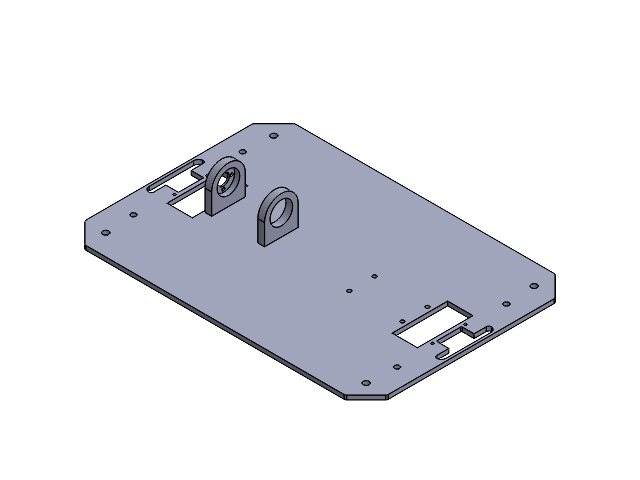
[picture p91: CAD file, 2025-01-13]
CAD/CDR_2024/Coupe_OFF/Robot_Monster/Assemblage_teste.SLDASM
Plaque_Base_Roulante_2.0_teste
Support_Moteur_2_teste
Support_Moteur_1_teste
