DaVinciBot/CDR-CAD/CAD/CDR_2024/Robot Main/1.Base roulante/4.Compartiment Batterie/Assemblage_Compartiment_Batterie_Sol.SLDASM

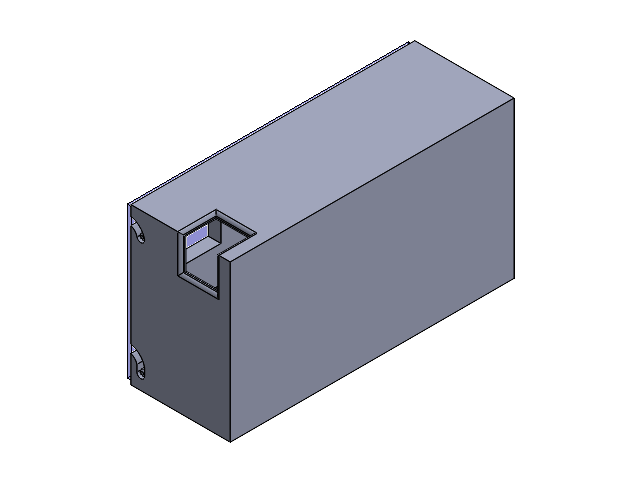
[picture p92: CAD file, 2025-04-10]
CAD/CDR_2024/Robot Main/1.Base roulante/4.Compartiment Batterie/Assemblage_Compartiment_Batterie_Sol.SLDASM
Compartiment_Batterie_Sol
Porte_Compartiment_Batterie_Sol
Plexi_Compartiement_Batterie
