DaVinciBot/CDR-CAD/CAD/CDR_2024/Robot Main/3.Actioneur/Actioneur Triple Pince/Assemblage_pince.SLDASM

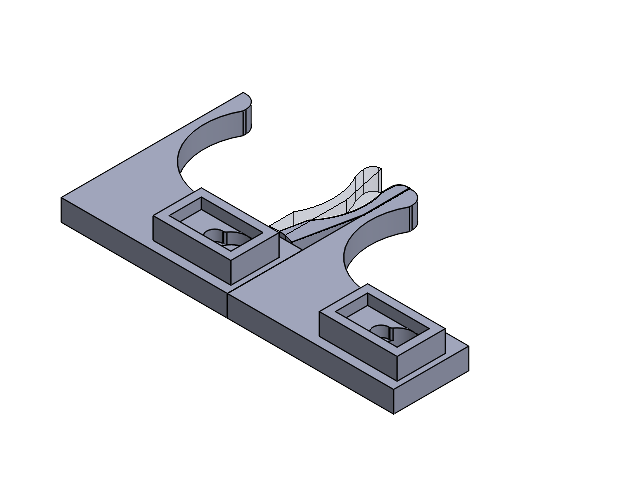
[picture p93: CAD file, 2026-01-05]
CAD/CDR_2024/Robot Main/3.Actioneur/Actioneur Triple Pince/Assemblage_pince.SLDASM
Pince fixe x 2
Pince mobile x 3
