DaVinciBot/CDR-CAD/CAD/CDR_2024/Zone de calcul/calcul_deporte_VF/AssembFinal.SLDASM

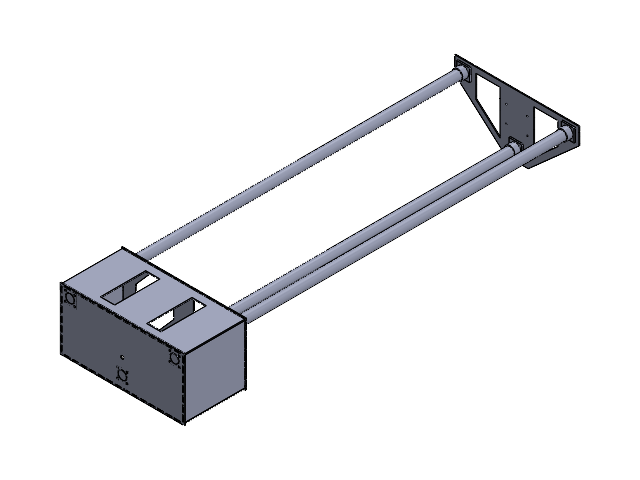
[picture p94: CAD file, 2024-10-26]
CAD/CDR_2024/Zone de calcul/calcul_deporte_VF/AssembFinal.SLDASM
Base_Boite
CôtéDG_Boite x 2
Côté_Arrière_Boite
Côté_Arrière_Boite_ecran
Toit_Boite
Tube_PVC x 3
Support_Tube x 6
Toit_Zone_Calcul
