DaVinciBot/CDR-CAD/CAD/CDR_2025/Robot_Main/1.Base_Roulante/1.Bloc_Moteur_2.0/3.Roue_Faite_Maison/Roue_80mm/Assemblage_Roue_80mm.SLDASM

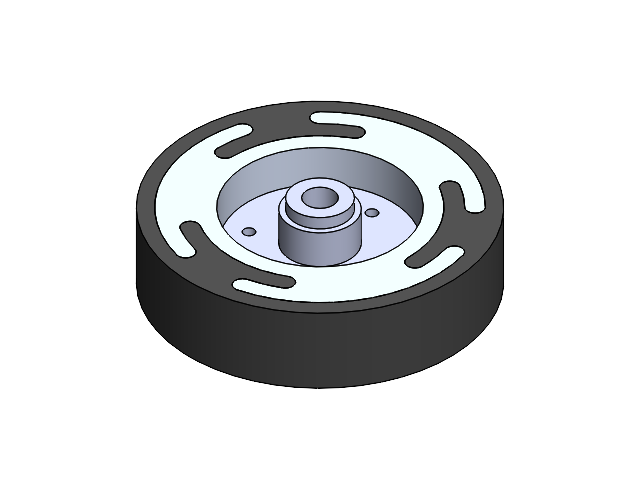
[picture p97: CAD file, 2025-04-10]
CAD/CDR_2025/Robot_Main/1.Base_Roulante/1.Bloc_Moteur_2.0/3.Roue_Faite_Maison/Roue_80mm/Assemblage_Roue_80mm.SLDASM
Jante_80mm
Pneu_Polyuretane_80mm
Moyeu_80mm
