DaVinciBot/CDR-CAD/CAD/CDR_2025/Robot_Main/2.Toit/1.Lidar/Assemblage_Lidar_Boitier_V2.SLDASM

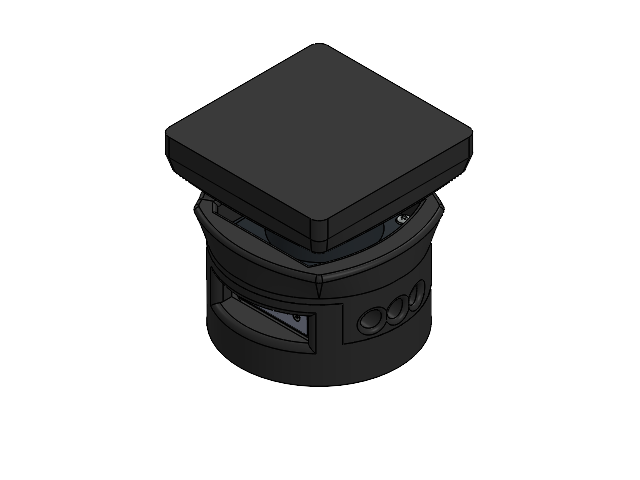
[picture p98: CAD file, 2025-09-29]
CAD/CDR_2025/Robot_Main/2.Toit/1.Lidar/Assemblage_Lidar_Boitier_V2.SLDASM
Boitier_Lidar_Bas_V2
Lidar_TIM561_V2_1
Lidar_TIM561_V2_2
Boitier_Lidar_Haut_V2
