DaVinciBot/CDR-CAD/CAD/CDR_2025/Robot_Main/3.Actionneur/2.Usine_A_Gradins/1.Ventouse/Assemblage_Ventouse.SLDASM

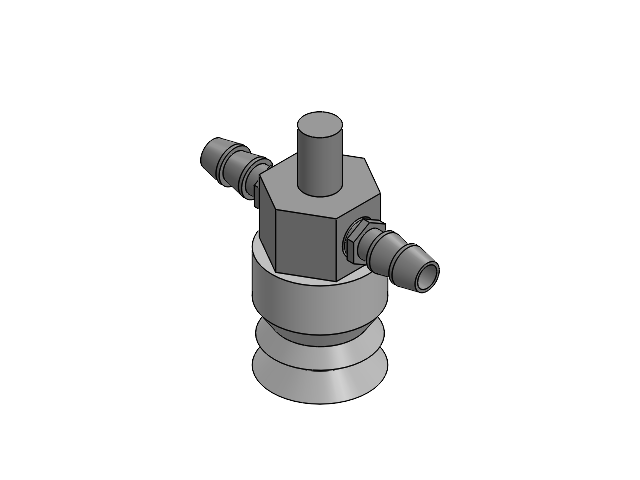
[picture p99: CAD file, 2025-02-25]
CAD/CDR_2025/Robot_Main/3.Actionneur/2.Usine_A_Gradins/1.Ventouse/Assemblage_Ventouse.SLDASM
Adaptateur_Ventouse_M5
Adaptateur_Tube_Ventouse x 2
Ventouse_DP-S15
