DaVinciBot/CDR-CAD/CAD/Table/Assemblage_Table.SLDASM

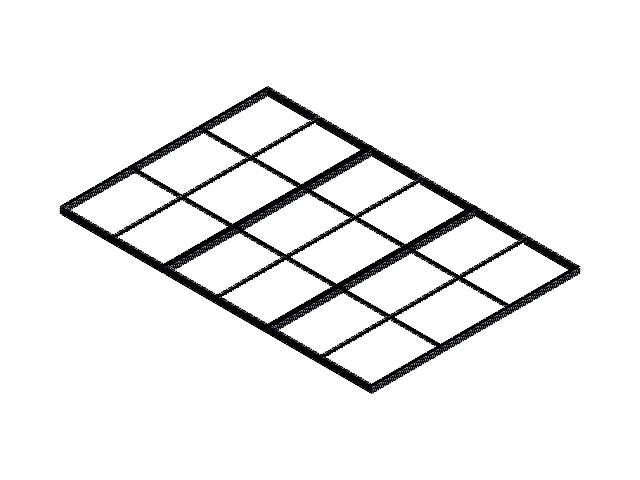
[picture p101: CAD file, 2025-04-10]
CAD/Table/Assemblage_Table.SLDASM
Profile_20mm_60mm_2000mm x 6
Profile_20mm_60mm_960mm x 6
Profile_20mm_20mm_960mm x 6
Profile_20mm_20mm_640mm x 9
