DaVinciBot/CDR-CAD/CAD/CDR_2024/Robot Main/1.Base roulante/1.Bloc Moteur/Bloc Moteur Droit/Assemblage_Bloc_Moteur_Droit_Allege.SLDASM

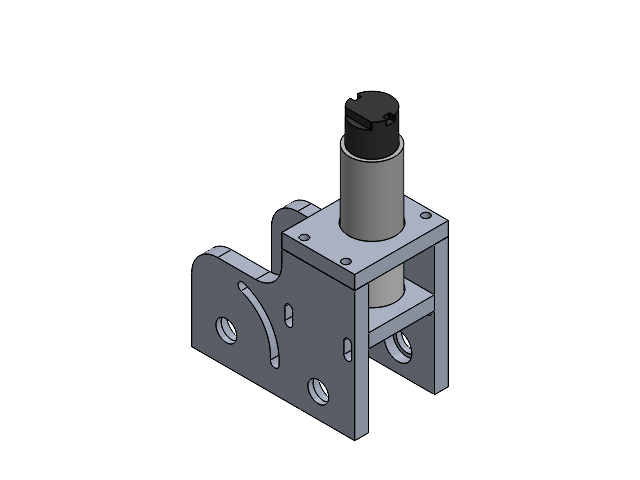
[picture p102: CAD file, 2024-04-08]
CAD/CDR_2024/Robot Main/1.Base roulante/1.Bloc Moteur/Bloc Moteur Droit/Assemblage_Bloc_Moteur_Droit_Allege.SLDASM
Plaque_Droite_Bloc_Moteur_Droit
Plaque_Gauche_Bloc_Moteur_Droit
Plaque_Axe_Moteur
Plaque_Support_Moteur
Moteur_Faulhaber_D26
