DaVinciBot/CDR-CAD/CAD/CDR_2024/Robot Main/1.Base roulante/1.Bloc Moteur/Bloc Moteur Gauche/Assemblage_Bloc_Moteur_Gauche_Allege.SLDASM

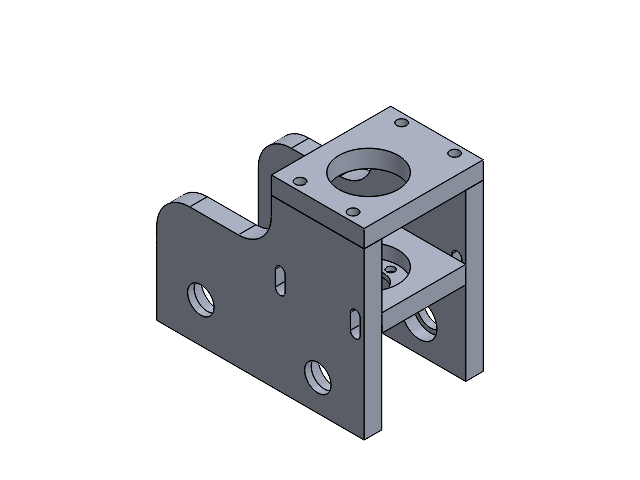
[picture p103: CAD file, 2024-04-08]
CAD/CDR_2024/Robot Main/1.Base roulante/1.Bloc Moteur/Bloc Moteur Gauche/Assemblage_Bloc_Moteur_Gauche_Allege.SLDASM
Plaque_Droite_Bloc_Moteur_Gauche
Plaque_Support_Moteur
Plaque_Axe_Moteur
Plaque_Gauche_Bloc_Moteur_Gauche
