DaVinciBot/CDR-CAD/CAD/CDR_2024/Robot Main/3.Actioneur/Actioneur Triple Pince/Assemblage_pince multiple2.SLDASM

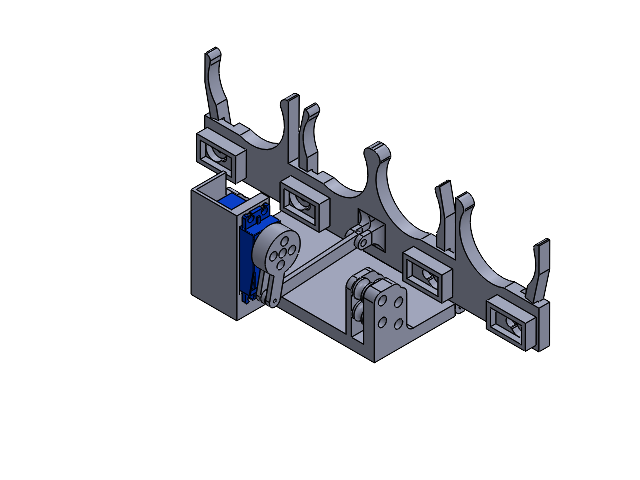
[picture p105: CAD file, 2024-02-19]
CAD/CDR_2024/Robot Main/3.Actioneur/Actioneur Triple Pince/Assemblage_pince multiple2.SLDASM
Support ascenseur
Pince multiple fixe - Copie
SymétriePince mobile x 2
Pince mobile x 2
Parallax Servo 900-00005
Tige liaison
Tige liaison servo
Poulie ascenseur x 8
