DaVinciBot/CDR-CAD/CAD/CDR_2024/Robot Main/3.Actioneur/Main De Dieu/Sous_Assemblage_Main_De_Dieu.SLDASM

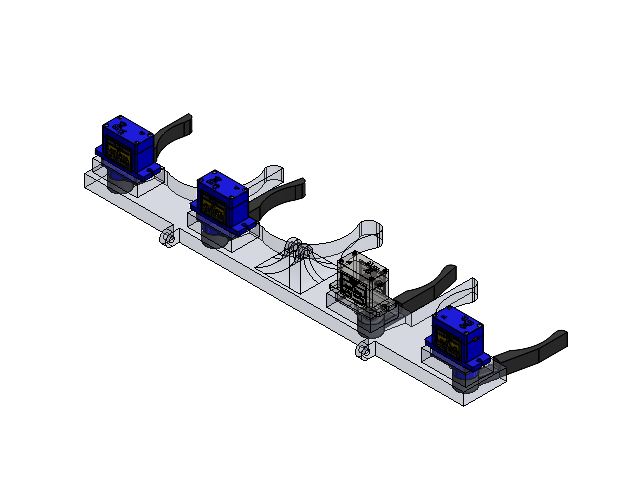
[picture p106: CAD file, 2025-04-10]
CAD/CDR_2024/Robot Main/3.Actioneur/Main De Dieu/Sous_Assemblage_Main_De_Dieu.SLDASM
Main_De_Dieu
Doigt_De_Dieu_1 x 2
Doigt_De_Dieu_2 x 2
Servo_SG90 x 4
