DaVinciBot/CDR-CAD/CAD/CDR_2024/Zone de calcul/Assemblage_Zone_Calcul.SLDASM

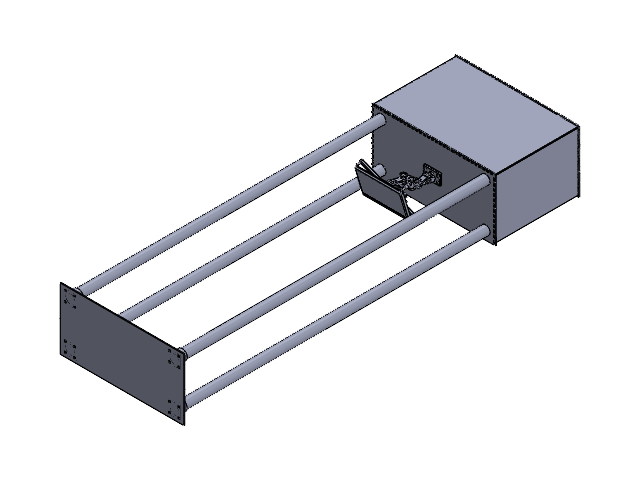
[picture p107: CAD file, 2024-03-12]
CAD/CDR_2024/Zone de calcul/Assemblage_Zone_Calcul.SLDASM
Base_Boite
Support_Tube x 8
Côté_Arrière_Boite
CôtéDG_Boite x 2
Tube_PVC x 4
Toit_Boite
Toit_Zone_Calcul
profile plate
screen plate
screen.stp
entretoise x 4
screen arm male female x 2
screen arm female flat
M10x25 bolt x 4
M10 nut x 4
