DaVinciBot/CDR-CAD/CAD/CDR_2025/Elements_De_Jeu/Assemblage_Elements_De_Jeu.SLDASM

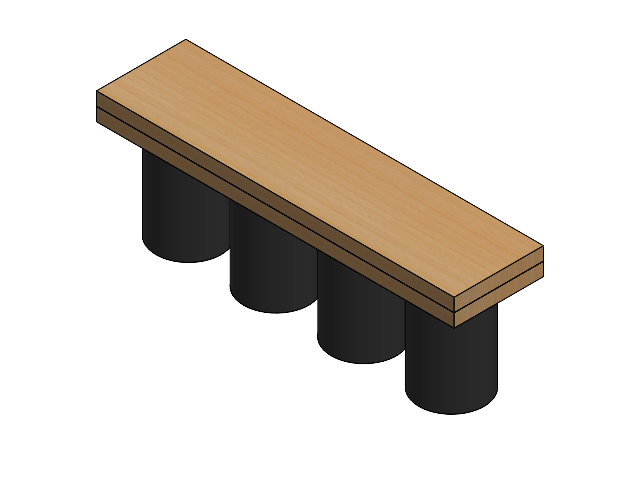
[picture p108: CAD file, 2025-05-21]
CAD/CDR_2025/Elements_De_Jeu/Assemblage_Elements_De_Jeu.SLDASM
Element_De_Jeu_Plate-Forme x 2
Element_De_Jeu_Colonne x 4
