DaVinciBot/CDR-CAD/CAD/CDR_2025/PAMI/elek/carte_mere_sokko.SLDASM

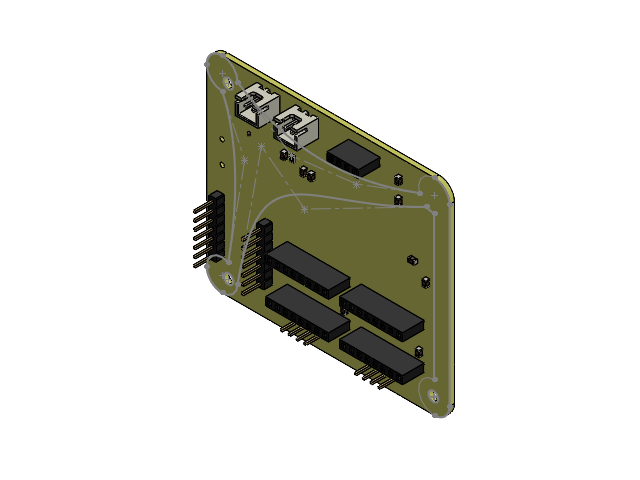
[picture p109: CAD file, 2025-05-21]
CAD/CDR_2025/PAMI/elek/carte_mere_sokko.SLDASM
JST_B2B_XH_A.step x 2
PinSocket_1x08_P254mm_Vertical.step x 4
C_0805_2012Metric-0.step x 9
R_0805_2012Metric-1.step
PinHeader_1x04_P254mm_Vertical.step x 2
PinHeader_1x07_P254mm_Vertical.step x 2
C_0402_1005Metric-2.step
LED_0603_1608Metric-3.step
PinSocket_1x04_P254mm_Vertical.step
carte_mere_sokko_PCB.step
