DaVinciBot/CDR-CAD/CAD/CDR_2025/Robot_En_Bois/Assemblage_Robot_En_Bois.SLDASM

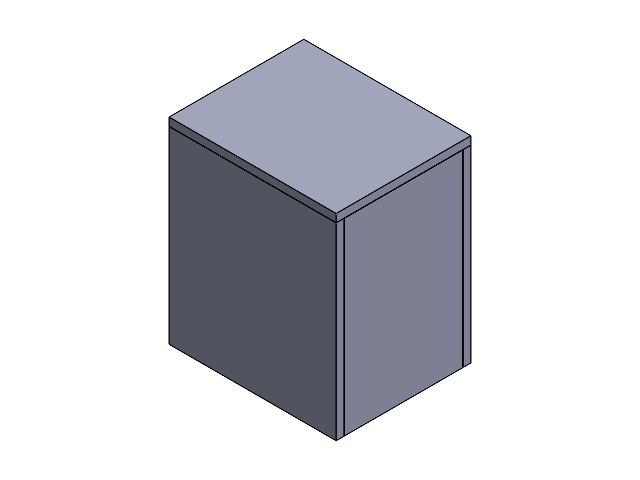
[picture p110: CAD file, 2025-02-25]
CAD/CDR_2025/Robot_En_Bois/Assemblage_Robot_En_Bois.SLDASM
Planche_De_Bois_Face_Largeur x 2
Planche_De_Bois_Face_Epaisseur x 2
Planche_De_Bois_Toit
