DaVinciBot/CDR-CAD/CAD/CDR_2025/Robot_Main/1.Base_Roulante/1.Bloc_Moteur_2.0/1.Parties_Moteur_FAULHABER/Moteur_FAULHABER_2224U_SR_+_Reducteur_22GPT-14-1.SLDPRT.SLDASM

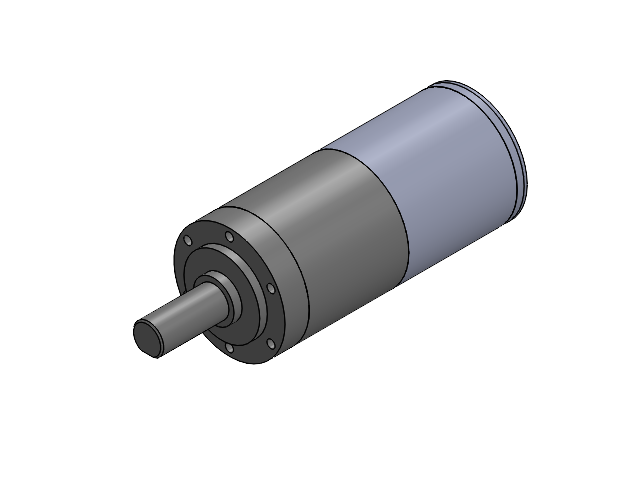
[picture p111: CAD file, 2024-11-03]
CAD/CDR_2025/Robot_Main/1.Base_Roulante/1.Bloc_Moteur_2.0/1.Parties_Moteur_FAULHABER/Moteur_FAULHABER_2224U_SR_+_Reducteur_22GPT-14-1.SLDPRT.SLDASM
Moteur_FAULHABER_2224U_SR
Reducteur_FAULHABER_22GPT-14-1
