DaVinciBot/CDR-CAD/CAD/CDR_2025/Robot_Main/3.Actionneur/2.Usine_A_Gradins/3.Pince_A_Planche/Assemblage_Moule_Patins.SLDASM

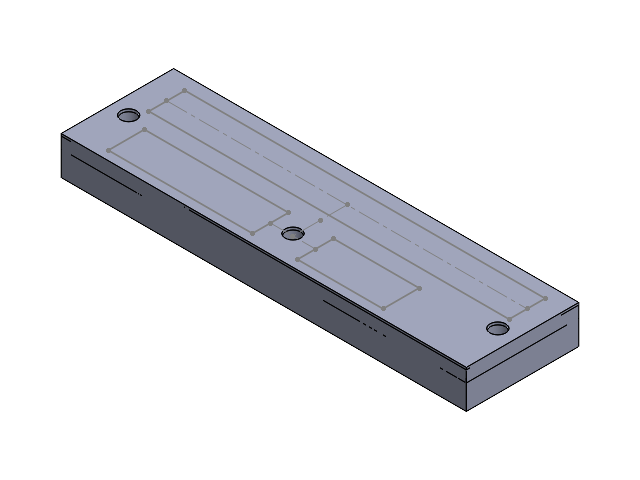
[picture p112: CAD file, 2025-04-10]
CAD/CDR_2025/Robot_Main/3.Actionneur/2.Usine_A_Gradins/3.Pince_A_Planche/Assemblage_Moule_Patins.SLDASM
Moule_Patins
Patin_Pince
Patin_Pince_Moyen
Patin_Pince_Petit
Toit_Moule_Patins
