DaVinciBot/CDR-CAD/PCB/CDR_2024/Robot_Main/PCB_actionneur.SLDASM

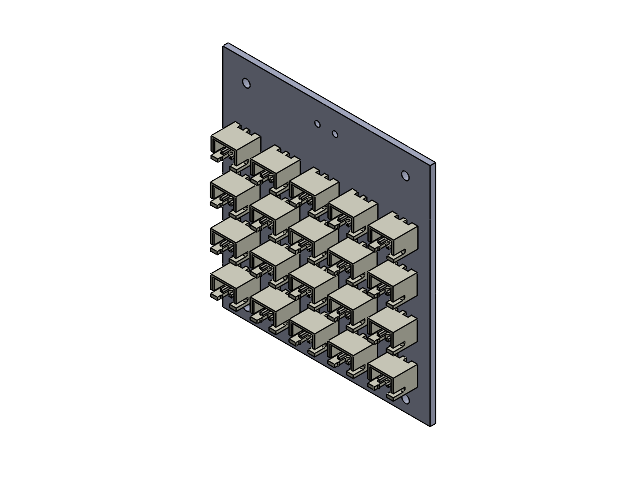
[picture p113: CAD file, 2024-04-08]
PCB/CDR_2024/Robot_Main/PCB_actionneur.SLDASM
SOLID_2.step x 20
PCB_actionneur PCB.step
