DaVinciBot/CDR-CAD/PCB/CDR_2024/Robot_Main/Teensy Sheild.SLDASM

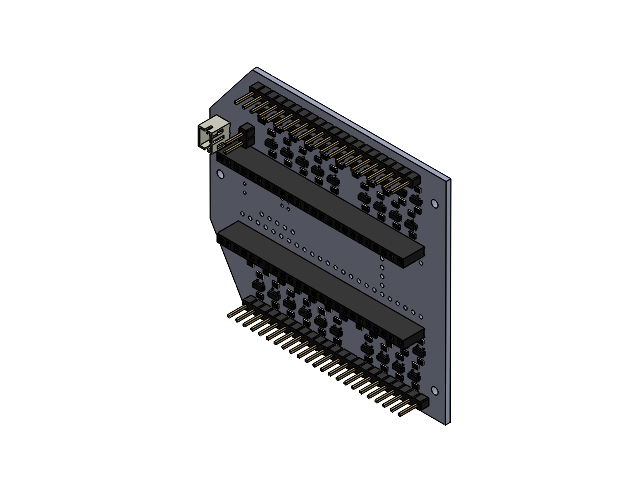
[picture p116: CAD file, 2024-04-08]
PCB/CDR_2024/Robot_Main/Teensy Sheild.SLDASM
SOLID_1.step x 42
SOLID-0_1.step x 84
SOLID-1.step
SOLID-2.step
SOLID-3.step x 2
SOLID-4.step
SOLID-5.step
Shield PCB.step
