DaVinciBot/CDR-CAD/CAD/CDR_2024/Robot Main/4.Cartes électroniques/Assemblage16.SLDASM

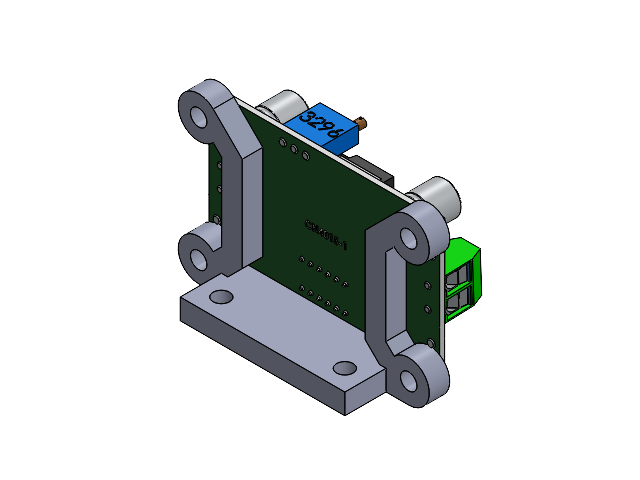
[picture p117: CAD file, 2024-10-26]
CAD/CDR_2024/Robot Main/4.Cartes électroniques/Assemblage16.SLDASM
Support_LM2596S
LM2596_Modelo_3D
