DaVinciBot/CDR-CAD/CAD/CDR_2025/Robot_Main/4.Electronique/Assemblage6.SLDASM

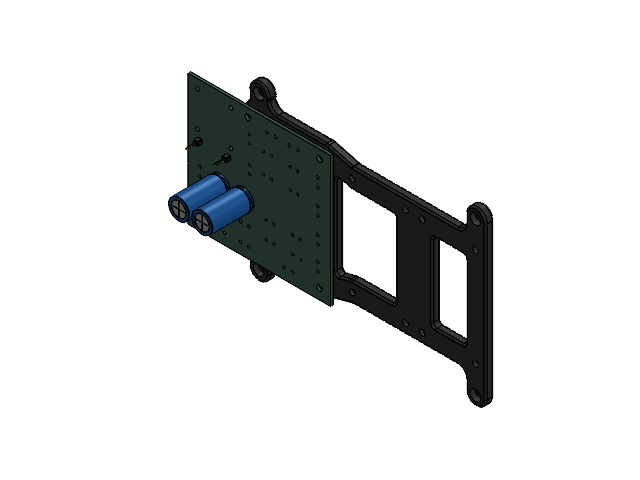
[picture p118: CAD file, 2025-05-21]
CAD/CDR_2025/Robot_Main/4.Electronique/Assemblage6.SLDASM
Support_Crate_Alim_Buck
C_Radial_D125mm_H250mm_P500mm.step x 2
PinHeader_1x01_P254mm_Vertical.step x 2
Carte Alime Vfinale_PCB.step
