DaVinciBot/CDR-CAD/CAD/Table/Tiers_De_Table.SLDASM

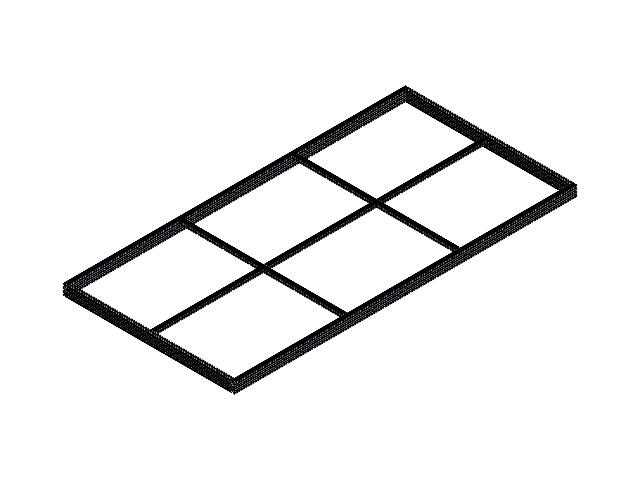
[picture p119: CAD file, 2025-04-10]
CAD/Table/Tiers_De_Table.SLDASM
Profile_20mm_60mm_2000mm x 2
Profile_20mm_60mm_960mm x 2
Profile_20mm_20mm_960mm x 2
Profile_20mm_20mm_640mm x 3
