DaVinciBot/CDR-CAD/CAD/CDR_2025/Robot_Main/1.Base_Roulante/3.Roue_Encodeuse_2.0/Same_Sky_AMT102-0048-N5000-S/Same_Sky_CUI_DEVICES_AMT102-0048-N5000-S.SLDASM

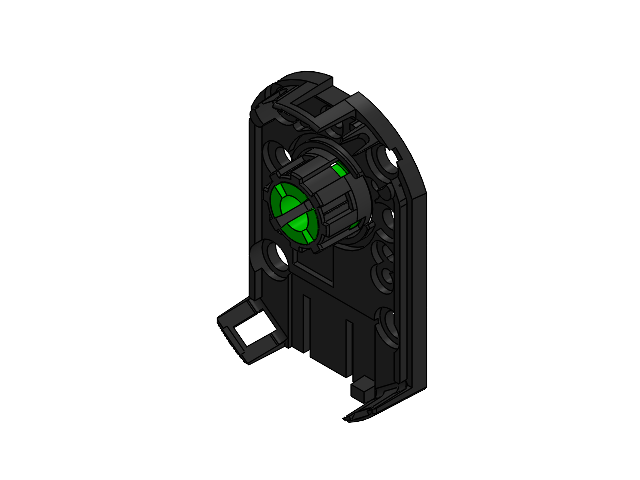
[picture p120: CAD file, 2025-02-25]
CAD/CDR_2025/Robot_Main/1.Base_Roulante/3.Roue_Encodeuse_2.0/Same_Sky_AMT102-0048-N5000-S/Same_Sky_CUI_DEVICES_AMT102-0048-N5000-S.SLDASM
Same_Sky_AMT-102-Base-REV-K
Same_Sky_AMT-Sleeve-REV-D(5 mm)
Same_Sky_AMT10X-Shaft-Adaptor-REV-E
