DaVinciBot/CDR-CAD/CAD/CDR_2025/Robot_Main/2.Toit/1.Lidar/Lidar_TIM561_V2.SLDASM

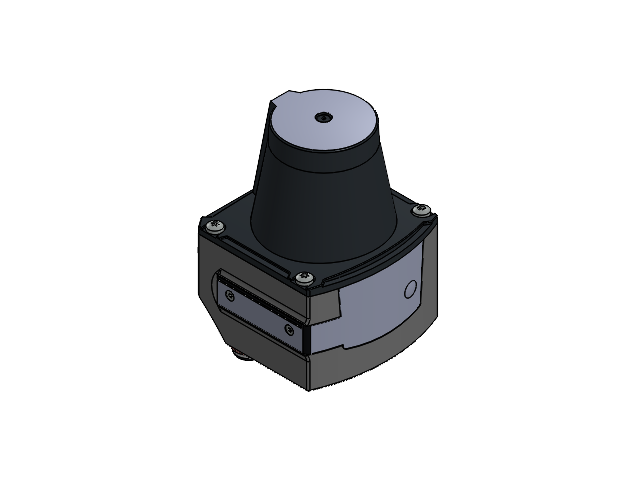
[picture p121: CAD file, 2025-05-21]
CAD/CDR_2025/Robot_Main/2.Toit/1.Lidar/Lidar_TIM561_V2.SLDASM
Lidar_TIM561_V2_1
Lidar_TIM561_V2_2
