DaVinciBot/CDR-CAD/CAD/CDR_2024/Robot Main/1.Base roulante/3.Roue_Encodeuse_V2/Assemblage_Encodeur_V2.SLDASM

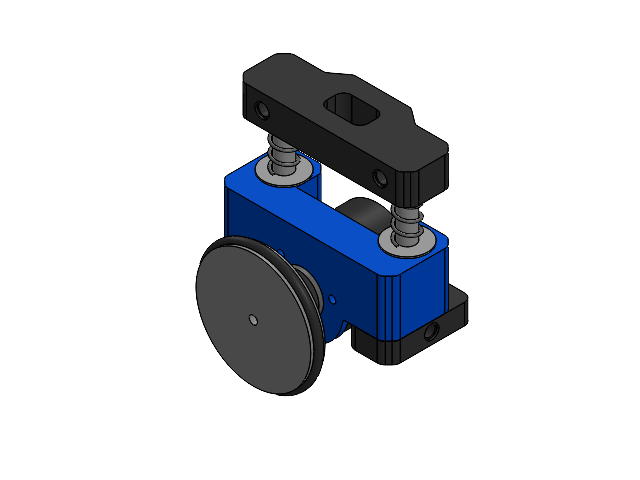
[picture p122: CAD file, 2025-04-10]
CAD/CDR_2024/Robot Main/1.Base roulante/3.Roue_Encodeuse_V2/Assemblage_Encodeur_V2.SLDASM
Support_Plaque_Encodeurs_V2
Axe_Guide_Encodeur_V2 x 2
Support_Ressort_V2
Ressort_M8_V2 x 2
Support_Encodeurs_V2
codeurs_travelers
Roulement_Lineaire_V2 x 2
Rondelle_M8_V2 x 2
Roue folle D56 BRS
Joint Torique D52 T4 BRS
