DaVinciBot/CDR-CAD/CAD/CDR_2024/Robot Main/4.Cartes électroniques/Assemblage15.SLDASM

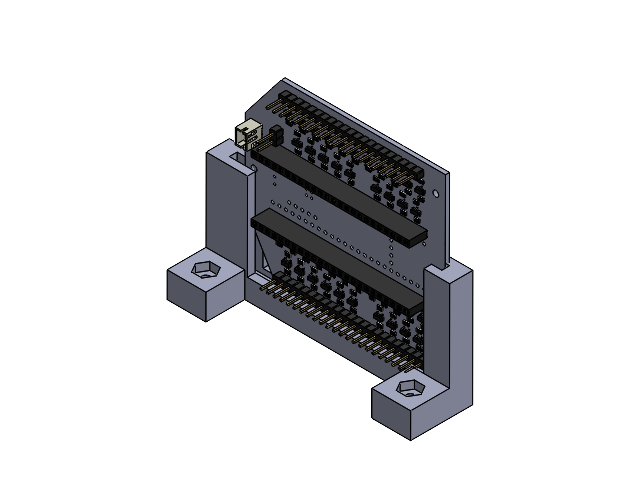
[picture p123: CAD file, 2024-04-08]
CAD/CDR_2024/Robot Main/4.Cartes électroniques/Assemblage15.SLDASM
SOLID_1.step x 42
SOLID-0_1.step x 84
SOLID-1.step
SOLID-2.step
SOLID-3.step x 2
SOLID-4.step
SOLID-5.step
Shield PCB.step
Support_Shield_Moteur
