DaVinciBot/CDR-CAD/CAD/CDR_2024/Robot Main/5.Plexi/Assemblage_Plexi_V2.SLDASM

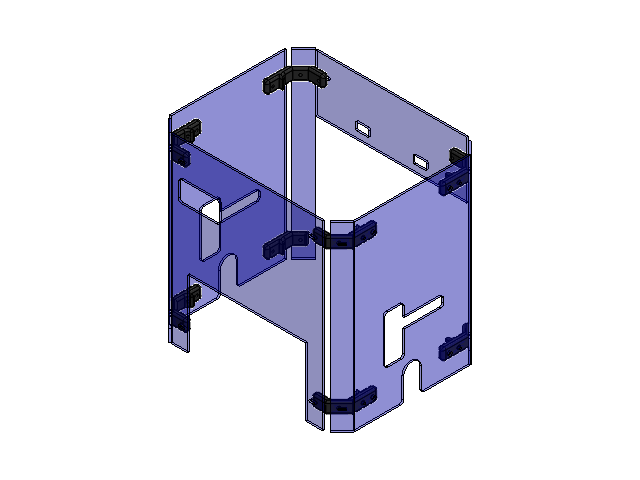
[picture p124: CAD file, 2025-04-10]
CAD/CDR_2024/Robot Main/5.Plexi/Assemblage_Plexi_V2.SLDASM
Plexi_Arriere_V2
Support_Plexi x 6
Plexi_Cote_V2 x 2
Plexi_Avant_V2
Support_Plexi_2 x 2
Plexi_Angle_V2 x 4
