DaVinciBot/CDR-CAD/(list of files, cad)

Other CAD files:
CAD/CDR_2022/Robot/etage 1/bras en L/bras en L.SLDASM
CAD/CDR_2023/Robot_1/1.Base roulante/base roulante/Roue/5mm/Assemblage 5mm.SLDASM
CAD/CDR_2023/Robot_2/Robot/etage 1/bras en L/bras en L.SLDASM
CAD/CDR_2023/Robot_2/Robot/Rdc/base roulante/Roue/5mm/Assemblage 5mm.SLDASM
CAD/CDR_2023/Robot_2/Robot/etage 1/bras pompe/bras pompe sans bras.SLDASM
CAD/CDR_2023/Robot_2/Robot/Rdc/actionneur abri de chantier/actionneur gauche.SLDASM
CAD/CDR_2024/Robot Main/1.Base roulante/3.Roue_Encodeuse_V2/roue encodeuse/Assemblage Roue Codeuse.SLDASM
CAD/CDR_2022/Robot/etage 1/bras pompe/bras pompe sans bras.SLDASM
CAD/CDR_2023/Robot_2/1.Base roulante/Roue/5mm/Assemblage 5mm.SLDASM
CAD/CDR_2023/Robot_2/Robot/etage 1/bras electrode/bras electrode sans bras.SLDASM
CAD/CDR_2025/Robot_Main/1.Base_Roulante/2.Bille_Porteuse/Assemblage Roue Porteuse V2.SLDASM
CAD/CDR_2023/Robot_2/Robot/etage 1/bras retourneur/bras retourneur sans bras.SLDASM
CAD/CDR_2023/Robot_2/Robot/toit/Lidar/Assemblage Support SICK TIM561.SLDASM
CAD/CDR_2022/Robot/Rdc/base roulante/encodeurs/Assemblage Systeme Encodeurs.SLDASM
CAD/CDR_2023/Robot_2/Robot/Rdc/actionneur abri de chantier/actionneur droit sans bras.SLDASM
CAD/CDR_2022/Robot/Rdc/actionneur abri de chantier/actionneur droit sans bras.SLDASM
CAD/CDR_2023/Robot_2/1.Base roulante/Assemblage Systeme Encodeurs.SLDASM
CAD/CDR_2022/Robot/Rdc/actionneur abri de chantier/Servo Motor SF90.SLDPRT
CAD/CDR_2022/Robot/Rdc/actionneur abri de chantier/Support servo moteur (droit).SLDPRT
CAD/CDR_2022/Robot/Rdc/actionneur abri de chantier/Support servo moteur (gauche).SLDPRT
CAD/CDR_2022/Robot/Rdc/actionneur abri de chantier/bras droit.SLDPRT
CAD/CDR_2022/Robot/Rdc/actionneur abri de chantier/bras gauche.SLDPRT
CAD/CDR_2022/Robot/Rdc/base roulante/Profilé Aluminium Bosch Rexroth 20 x 20 mm.SLDPRT
CAD/CDR_2022/Robot/Rdc/base roulante/Roue/5mm/moyeu pololu (axe 5mm) part 2.SLDPRT
CAD/CDR_2022/Robot/Rdc/base roulante/Roue/5mm/moyeux pololu (axe 5mm).SLDPRT
CAD/CDR_2022/Robot/Rdc/base roulante/Roue/Roue Scooter noire 70x25 mm 3272.SLDPRT
CAD/CDR_2022/Robot/Rdc/base roulante/bille porteuse/Assemblage Roue Porteuse.SLDASM
CAD/CDR_2022/Robot/Rdc/base roulante/bille porteuse/Bille D12.SLDPRT
CAD/CDR_2022/Robot/Rdc/base roulante/bille porteuse/Bille porteuse ALWAYE D12_7.SLDPRT
CAD/CDR_2022/Robot/Rdc/base roulante/bille porteuse/Ecrou M6.SLDPRT
CAD/CDR_2022/Robot/Rdc/base roulante/bille porteuse/Insert M4.SLDPRT
CAD/CDR_2022/Robot/Rdc/base roulante/bille porteuse/Rondelle M6.SLDPRT
CAD/CDR_2022/Robot/Rdc/base roulante/bille porteuse/Support Bille porteuse.SLDPRT
CAD/CDR_2022/Robot/Rdc/base roulante/encodeurs/Axe_Support_Codeurs.SLDPRT
CAD/CDR_2022/Robot/Rdc/base roulante/encodeurs/Codeurs Kuebler D24.SLDPRT
CAD/CDR_2022/Robot/Rdc/base roulante/encodeurs/Insert M4.SLDPRT
CAD/CDR_2022/Robot/Rdc/base roulante/encodeurs/Ressort M8.SLDPRT
CAD/CDR_2022/Robot/Rdc/base roulante/encodeurs/Rondelle M8.SLDPRT
CAD/CDR_2022/Robot/Rdc/base roulante/encodeurs/Roulement linéaire.SLDPRT
CAD/CDR_2022/Robot/Rdc/base roulante/encodeurs/Support Encodeurs (1).SLDPRT
CAD/CDR_2022/Robot/Rdc/base roulante/encodeurs/Support Encodeurs.SLDPRT
CAD/CDR_2022/Robot/Rdc/base roulante/encodeurs/Support Plaque Encodeurs.SLDPRT
CAD/CDR_2022/Robot/Rdc/base roulante/encodeurs/Support Ressort.SLDPRT
CAD/CDR_2022/Robot/Rdc/base roulante/encodeurs/Vis M3_L5.SLDPRT
CAD/CDR_2022/Robot/Rdc/base roulante/encodeurs/roue encodeuse/Assemblage Roue Codeuse.SLDASM
CAD/CDR_2022/Robot/Rdc/base roulante/encodeurs/roue encodeuse/Joint Torique D52 T4 BRS.SLDPRT
CAD/CDR_2022/Robot/Rdc/base roulante/encodeurs/roue encodeuse/Roue folle D56 BRS.SLDPRT
CAD/CDR_2022/Robot/Rdc/base roulante/plaque base roulante 2.SLDPRT
CAD/CDR_2022/Robot/Rdc/base roulante/support.SLDPRT
CAD/CDR_2022/Robot/etage 1/L298N pont H.SLDPRT
CAD/CDR_2022/Robot/etage 1/bras electrode/bras electrode.SLDPRT
CAD/CDR_2022/Robot/etage 1/bras electrode/servo 9g.SLDPRT
CAD/CDR_2022/Robot/etage 1/bras electrode/soutien servo fond.SLDPRT
CAD/CDR_2022/Robot/etage 1/bras electrode/soutien servo.SLDPRT
CAD/CDR_2022/Robot/etage 1/bras en L/bras electrode.SLDPRT
CAD/CDR_2022/Robot/etage 1/bras en L/servo 9g.SLDPRT
CAD/CDR_2022/Robot/etage 1/bras en L/soutien servo fond.SLDPRT
CAD/CDR_2022/Robot/etage 1/bras en L/soutien servo.SLDPRT
CAD/CDR_2022/Robot/etage 1/bras pompe/2e, petit bras.SLDPRT
CAD/CDR_2022/Robot/etage 1/bras pompe/Parallax Servo 900-00005.SLDPRT
CAD/CDR_2022/Robot/etage 1/bras pompe/soutien-servo M4 INSERT BIEN.sldprt
CAD/CDR_2022/Robot/etage 1/bras pompe/soutien-servo-fond M4 INSERT BIEN.SLDPRT
CAD/CDR_2022/Robot/etage 1/bras retourneur/2e, petit bras.SLDPRT
CAD/CDR_2022/Robot/etage 1/bras retourneur/Parallax Servo 900-00005.SLDPRT
CAD/CDR_2022/Robot/etage 1/bras retourneur/soutien-servo M4 INSERT BIEN.sldprt
CAD/CDR_2022/Robot/etage 1/bras retourneur/soutien-servo-fond M4 INSERT BIEN.SLDPRT
CAD/CDR_2022/Robot/etage 1/etage 1 .SLDPRT
CAD/CDR_2022/Robot/toit/Lidar/Support Sick TIM561 MK1 B_M.SLDPRT
CAD/CDR_2022/Robot/toit/Lidar/Support Sick TIM562 Bas.SLDPRT
CAD/CDR_2022/Robot/toit/Lidar/Support Sick TIM562 Haut.SLDPRT
CAD/CDR_2022/Robot/toit/Lidar/TIM561-Part.SLDPRT
CAD/CDR_2022/Robot/toit/Plaque supérieure robot 1.SLDPRT
CAD/CDR_2023/Elements de jeux/Support cerise (2).SLDPRT
CAD/CDR_2023/Panier/V1/Assemblage panier.SLDASM
CAD/CDR_2023/Panier/V1/Profilé 180mm 20x20.SLDPRT
CAD/CDR_2023/Panier/V1/Profilé 260mm 20x20.SLDPRT
CAD/CDR_2023/Panier/V1/Profilé 440mm 20x20.SLDPRT
CAD/CDR_2023/Panier/V1/goulot.SLDPRT
CAD/CDR_2023/Panier/V2/Récupérateur_de_balle.SLDPRT
CAD/CDR_2023/Panier/V2/Tobogan.SLDPRT
CAD/CDR_2023/Panier/V2/profilé 170x15x15.SLDPRT
CAD/CDR_2023/Panier/V2/profilé 270x15x15.SLDPRT
CAD/CDR_2023/Panier/V2/profilé 420x15x15.SLDPRT
CAD/CDR_2023/Robot_1/1.Base roulante/base roulante/4221G_BXTH _ moteur.SLDPRT
CAD/CDR_2023/Robot_1/1.Base roulante/base roulante/42gpt-2stage_standard+KSx _ reducteur.SLDPRT
CAD/CDR_2023/Robot_1/1.Base roulante/base roulante/Archive moteur/Assemblage Axe BRS.SLDASM
CAD/CDR_2023/Robot_1/1.Base roulante/base roulante/Archive moteur/Assemblage Moteur BRS.SLDASM
CAD/CDR_2023/Robot_1/1.Base roulante/base roulante/Archive moteur/Assemblage Poulie Lisse BRS.SLDASM
CAD/CDR_2023/Robot_1/1.Base roulante/base roulante/Archive moteur/Assemblage bloc moteur.SLDASM
CAD/CDR_2023/Robot_1/1.Base roulante/base roulante/Archive moteur/Courroie tendu BRS.SLDPRT
CAD/CDR_2023/Robot_1/1.Base roulante/base roulante/Archive moteur/Moteur faulhaber D26 BRS Access.SLDPRT
CAD/CDR_2023/Robot_1/1.Base roulante/base roulante/Archive moteur/Moteur faulhaber D26 BRS.SLDPRT
CAD/CDR_2023/Robot_1/1.Base roulante/base roulante/Archive moteur/Poulie D20 BRS.SLDPRT
CAD/CDR_2023/Robot_1/1.Base roulante/base roulante/Archive moteur/Poulie D32 BRS.SLDPRT
CAD/CDR_2023/Robot_1/1.Base roulante/base roulante/Archive moteur/Poulie Lisse D5 BRP.SLDPRT
CAD/CDR_2023/Robot_1/1.Base roulante/base roulante/Archive moteur/Support Axe Roue BRS.SLDPRT
CAD/CDR_2023/Robot_1/1.Base roulante/base roulante/Archive moteur/Support Dessus Moteur Axe BRS bloc unique.SLDPRT
CAD/CDR_2023/Robot_1/1.Base roulante/base roulante/Archive moteur/Support Dessus Moteur Axe BRS.SLDPRT
CAD/CDR_2023/Robot_1/1.Base roulante/base roulante/Archive moteur/Support Moteur BRS.SLDPRT
CAD/CDR_2023/Robot_1/1.Base roulante/base roulante/Assemblage BR_ancien_Faulhaber.SLDASM
CAD/CDR_2023/Robot_1/1.Base roulante/base roulante/Assemblage moteur-cache-insert Total.SLDASM
CAD/CDR_2023/Robot_1/1.Base roulante/base roulante/Cache moteur.SLDPRT
CAD/CDR_2023/Robot_1/1.Base roulante/base roulante/Cache moteur_V2.SLDPRT
CAD/CDR_2023/Robot_1/1.Base roulante/base roulante/Insert M4.SLDPRT
CAD/CDR_2023/Robot_1/1.Base roulante/base roulante/Optimisation support moteur/côté support.SLDPRT
CAD/CDR_2023/Robot_1/1.Base roulante/base roulante/Optimisation support moteur/dessus support.SLDPRT
CAD/CDR_2023/Robot_1/1.Base roulante/base roulante/Optimisation support moteur/support principal.SLDPRT
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
