DaVinciBot/CDR-CAD/PCB/CDR_2025/Robot_Main/carte 5V/carte 5V.kicad_pcb

## KiCad design PCB/CDR_2025/Robot_Main/carte 5V/carte 5V.kicad_pcb (2026-01-05)

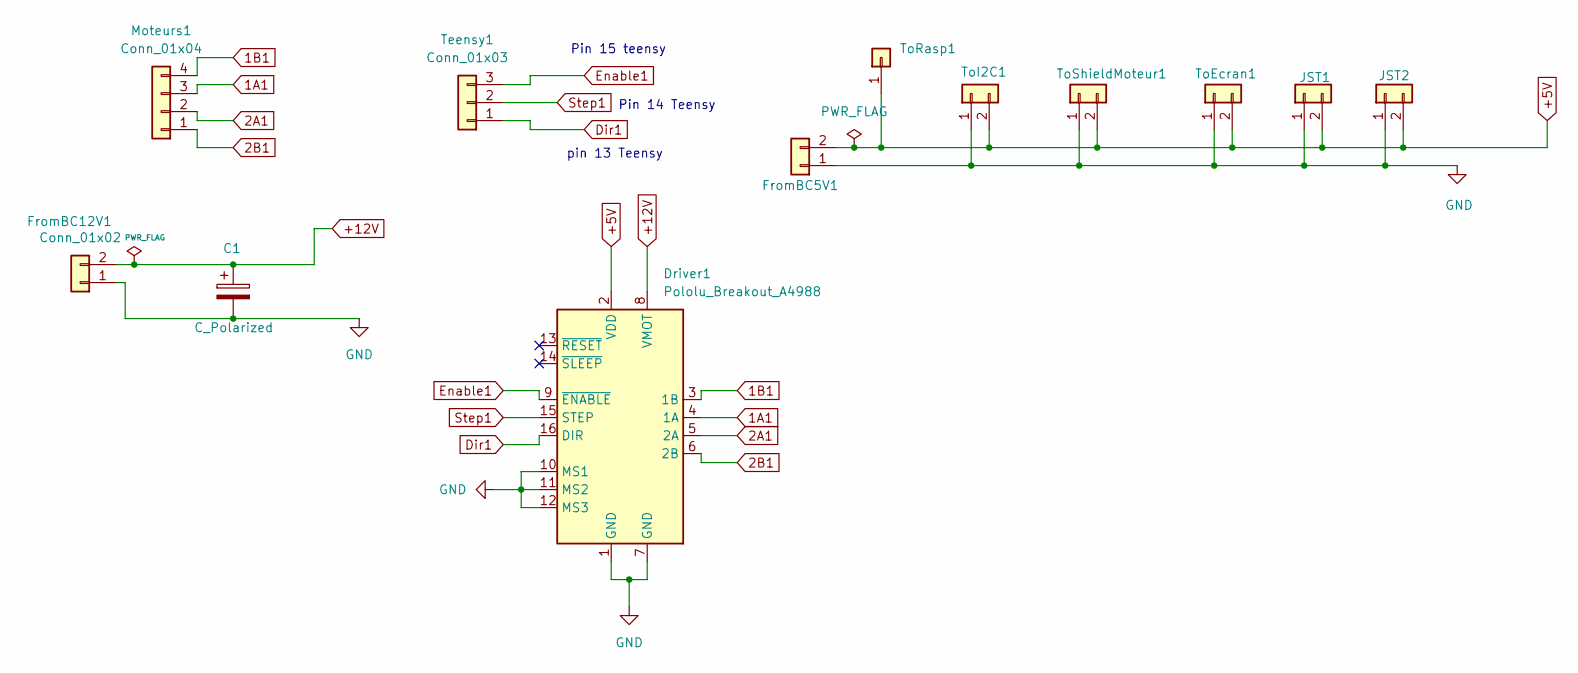
[picture p125: schematic carte 5V.kicad_sch]

Parts:
C1: C_Polarized; C_Radial_D12.5mm_H25.0mm_P5.00mm
Driver1: Pololu_Breakout_A4988; Pololu_Breakout-16_15.2x20.3mm
FromBC5V1, FromBC12V1: Conn_01x02; TerminalBlock_bornier-2_P5.08mm
JST1, JST2: Conn_01x02; JST_XH_B2B-XH-A_1x02_P2.50mm_Vertical
Moteurs1: Conn_01x04; JST_XH_B4B-XH-A_1x04_P2.50mm_Vertical
Teensy1: Conn_01x03; JST_XH_B3B-XH-A_1x03_P2.50mm_Vertical
ToEcran1: Conn_01x02; JST_XH_B2B-XH-A_1x02_P2.50mm_Vertical
ToI2C1: Conn_01x02; JST_XH_B2B-XH-A_1x02_P2.50mm_Vertical
ToRasp1: Conn_01x01; JST_XH_B1B-XH-AM_1x01_P2.50mm_Vertical
ToShieldMoteur1: Conn_01x02; JST_XH_B2B-XH-A_1x02_P2.50mm_Vertical

Connections:
1A1: Driver1.4 (1A), Moteurs1.3
1B1: Driver1.3 (1B), Moteurs1.4
2A1: Driver1.5 (2A), Moteurs1.2
2B1: Driver1.6 (2B), Moteurs1.1
+5V: Driver1.2 (VDD), FromBC5V1.2, JST1.2, JST2.2, ToEcran1.2, ToI2C1.2, ToRasp1.1, ToShieldMoteur1.2
+12V: C1.1, Driver1.8 (VMOT), FromBC12V1.2
Dir1: Driver1.16 (DIR), Teensy1.1
Enable1: Driver1.9 (~ENABLE), Teensy1.3
GND: C1.2, Driver1.1 (GND), Driver1.7 (GND), Driver1.10 (MS1), Driver1.11 (MS2), Driver1.12 (MS3), FromBC5V1.1, FromBC12V1.1, JST1.1, JST2.1, ToEcran1.1, ToI2C1.1, ToShieldMoteur1.1
Step1: Driver1.15 (STEP), Teensy1.2

Notes on the sheet:
Pin 15 teensy
Pin 14 Teensy
pin 13 Teensy

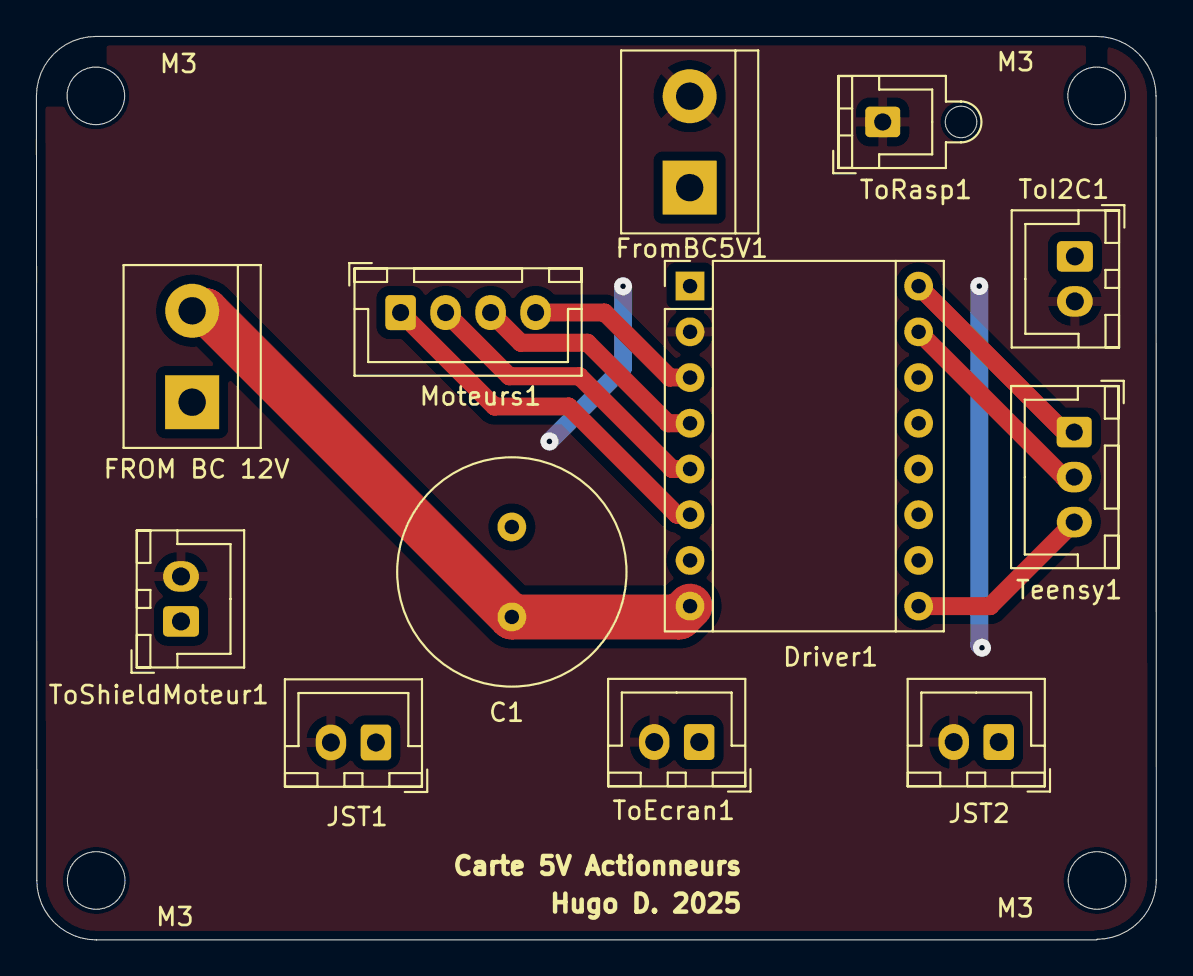
[picture p126: board carte 5V.kicad_pcb from above]

Board: 2 copper layers, 62.2 x 50.2 mm, 16 parts (0 on the bottom side), 10 nets.

Other parts of the board:
M3, M3#2, M3#3, M3#4: MountingHole_3.2mm_M3
