DaVinciBot/CDR-CAD/PCB/PAMI/carte_mere_pami/carte_mere_sokko.kicad_pcb

## KiCad design PCB/PAMI/carte_mere_pami/carte_mere_sokko.kicad_pcb (2025-09-29)

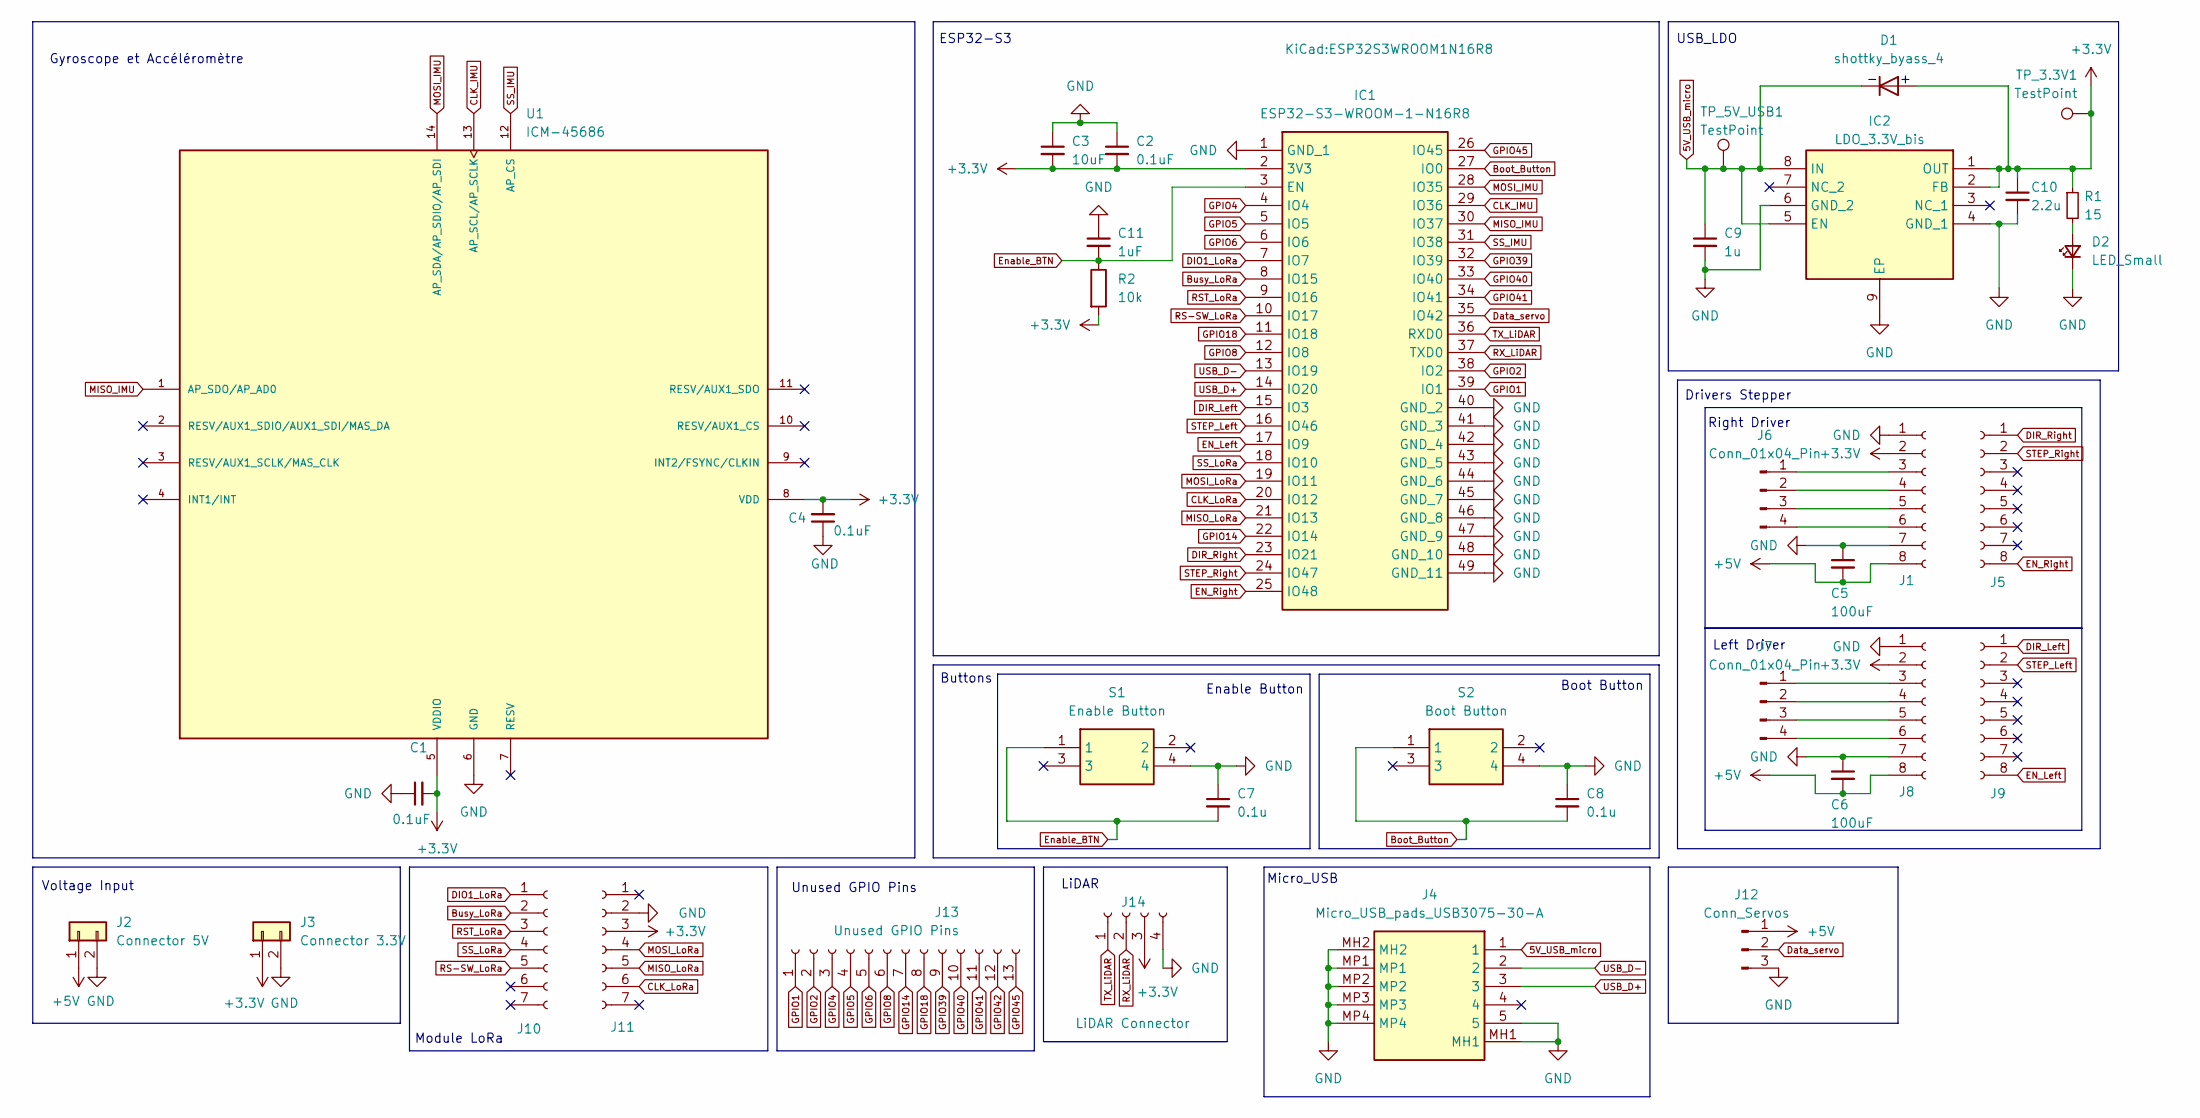
[picture p127: schematic carte_mere_sokko.kicad_sch]

Parts:
C1, C2, C4: 0.1uF; C_0805_2012Metric_Pad1.18x1.45mm_HandSolder
C3: 10uF; C_0805_2012Metric_Pad1.18x1.45mm_HandSolder
C5, C6: 100uF; C_0805_2012Metric_Pad1.18x1.45mm_HandSolder
C7, C8: 0.1u; C_0805_2012Metric_Pad1.18x1.45mm_HandSolder
C9: 1u; C_0402_1005Metric_Pad0.74x0.62mm_HandSolder
C10: 2.2u; C_0805_2012Metric_Pad1.18x1.45mm_HandSolder
C11: 1uF; C_0805_2012Metric_Pad1.18x1.45mm_HandSolder
D1: shottky_byass_4; SOD2512X113N
D2: LED_Small; LED_0603_1608Metric_Pad1.05x0.95mm_HandSolder
IC1: ESP32-S3-WROOM-1-N16R8; ESP32S3WROOM1N16R8; Manufacturer_Part_Number ESP32-S3-WROOM-1-N16R8; Mouser Part Number 356-ESP32S3WRM1N16R8
IC2: LDO_3.3V_bis; SOP65P490X110-9N; Manufacturer_Part_Number TLV76701DGNR; Mouser Part Number 595-TLV76701DGNR
J1, J5, J8, J9: Conn_01x08_Socket; PinSocket_1x08_P2.54mm_Vertical
J2: Connector 5V; JST_XH_B2B-XH-A_1x02_P2.50mm_Vertical
J3: Connector 3.3V; JST_XH_B2B-XH-A_1x02_P2.50mm_Vertical
J4: Micro_USB_pads_USB3075-30-A; USB307530A; Manufacturer_Part_Number USB3075-30-A; Mouser Part Number 640-USB3075-30-A
J6, J7: Conn_01x04_Pin; JST_XH_B4B-XH-A_1x04_P2.50mm_Vertical
J10, J11: Conn_01x07_Socket; PinHeader_1x07_P2.54mm_Vertical
J12: Conn_Servos; PinHeader_1x03_P2.00mm_Vertical
J13: Unused GPIO Pins; PinSocket_1x13_P2.54mm_Vertical
J14: LiDAR Connector; PinSocket_1x04_P2.54mm_Vertical
R1: 15; R_0805_2012Metric_Pad1.20x1.40mm_HandSolder
R2: 10k; R_0805_2012Metric_Pad1.20x1.40mm_HandSolder
S1: Enable Button; PTS810SJG250SMTRLFS; Manufacturer_Part_Number PTS810SJM250SMTRLFS; Mouser Part Number 611-PTS810SJM250SMTR
S2: Boot Button; PTS810SJG250SMTRLFS; Manufacturer_Part_Number PTS810SJM250SMTRLFS; Mouser Part Number 611-PTS810SJM250SMTR
TP_3.3V1, TP_5V_USB1: TestPoint; TestPoint_Pad_D2.0mm
U1: ICM-45686; IC_ICM-45686; PARTREV 0.2

Connections:
5V_USB_micro: C9.1, D1.1 (K), IC2.5 (EN), IC2.8 (IN), J4.1, TP_5V_USB1.1
+3.3V: C1.2, C2.2, C3.2, C4.2, C10.1, D1.2 (A), IC1.2 (3V3), IC2.1 (OUT), IC2.2 (FB), J1.2, J3.1, J8.2, J11.3, J14.3, R1.1, R2.2, TP_3.3V1.1, U1.5 (VDDIO), U1.8 (VDD)
+5V: C5.2, C6.2, J1.8, J2.1, J8.8, J12.1
Boot_Button: C8.2, IC1.27 (IO0), S2.1
Busy_LoRa: IC1.8 (IO15), J10.2
CLK_IMU: IC1.29 (IO36), U1.13 (AP_SCL/AP_SCLK)
CLK_LoRa: IC1.20 (IO12), J11.6
DIO1_LoRa: IC1.7 (IO7), J10.1
DIR_Left: IC1.15 (IO3), J9.1
DIR_Right: IC1.23 (IO21), J5.1
Data_servo: IC1.35 (IO42), J12.2
EN_Left: IC1.17 (IO9), J9.8
EN_Right: IC1.25 (IO48), J5.8
Enable_BTN: C7.2, C11.2, IC1.3 (EN), R2.1, S1.1
GND: C1.1, C2.1, C3.1, C4.1, C5.1, C6.1, C7.1, C8.1, C9.2, C10.2, C11.1, D2.1 (K), IC1.1 (GND_1), IC1.40 (GND_2), IC1.41 (GND_3), IC1.42 (GND_4), IC1.43 (GND_5), IC1.44 (GND_6), IC1.45 (GND_7), IC1.46 (GND_8), IC1.47 (GND_9), IC1.48 (GND_10), IC1.49 (GND_11), IC2.4 (GND_1), IC2.6 (GND_2), IC2.9 (EP), J1.1, J1.7, J2.2, J3.2, J4.5, J4.MH1, J4.MH2, J4.MP1, J4.MP2, J4.MP3, J4.MP4, J8.1, J8.7, J11.2, J12.3, J14.4, S1.4, S2.4, U1.6 (GND)
GPIO1: IC1.39 (IO1), J13.1
GPIO2: IC1.38 (IO2), J13.2
GPIO4: IC1.4 (IO4), J13.3
GPIO5: IC1.5 (IO5), J13.4
GPIO6: IC1.6 (IO6), J13.5
GPIO8: IC1.12 (IO8), J13.6
GPIO14: IC1.22 (IO14), J13.7
GPIO18: IC1.11 (IO18), J13.8
GPIO39: IC1.32 (IO39), J13.9
GPIO40: IC1.33 (IO40), J13.10
GPIO41: IC1.34 (IO41), J13.11
GPIO45: IC1.26 (IO45), J13.13
MISO_IMU: IC1.30 (IO37), U1.1 (AP_SDO/AP_AD0)
MISO_LoRa: IC1.21 (IO13), J11.5
MOSI_IMU: IC1.28 (IO35), U1.14 (AP_SDA/AP_SDIO/AP_SDI)
MOSI_LoRa: IC1.19 (IO11), J11.4
unnamed: D2.2 (A), R1.2
unnamed: J1.3, J6.1
unnamed: J1.4, J6.2
unnamed: J1.5, J6.3
unnamed: J1.6, J6.4
unnamed: J7.1, J8.3
unnamed: J7.2, J8.4
unnamed: J7.3, J8.5
unnamed: J7.4, J8.6
RS-SW_LoRa: IC1.10 (IO17), J10.5
RST_LoRa: IC1.9 (IO16), J10.3
RX_LiDAR: IC1.37 (TXD0), J14.2
SS_IMU: IC1.31 (IO38), U1.12 (AP_CS)
SS_LoRa: IC1.18 (IO10), J10.4
STEP_Left: IC1.16 (IO46), J9.2
STEP_Right: IC1.24 (IO47), J5.2
TX_LiDAR: IC1.36 (RXD0), J14.1
USB_D+: IC1.14 (IO20), J4.3
USB_D-: IC1.13 (IO19), J4.2

Notes on the sheet:
Voltage Input
Right Driver
ESP32-S3
LiDAR
Drivers Stepper
Buttons
USB_LDO
Enable Button
Unused GPIO Pins
Gyroscope et Accéléromètre
Left Driver
Boot Button
Module LoRa
Micro_USB

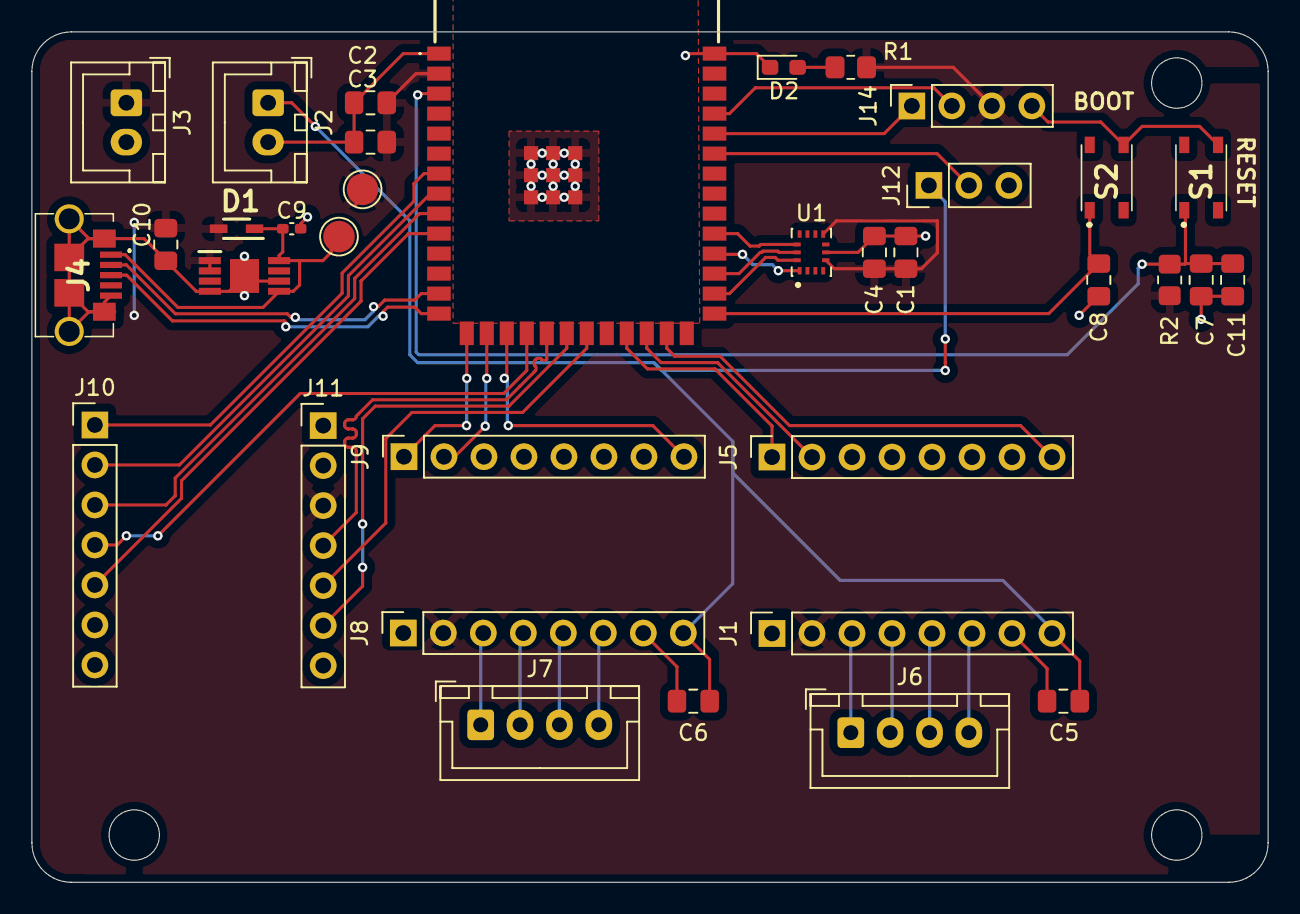
[picture p128: board carte_mere_sokko.kicad_pcb from above]

Board: 2 copper layers, 78.5 x 54.0 mm, 35 parts (0 on the bottom side), 38 nets.
