DaVinciBot/CDR-CAD/PCB/PAMI/PAMI_Power_board/PAMI_Power_board.kicad_pcb

## KiCad design PCB/PAMI/PAMI_Power_board/PAMI_Power_board.kicad_pcb (2025-09-29)

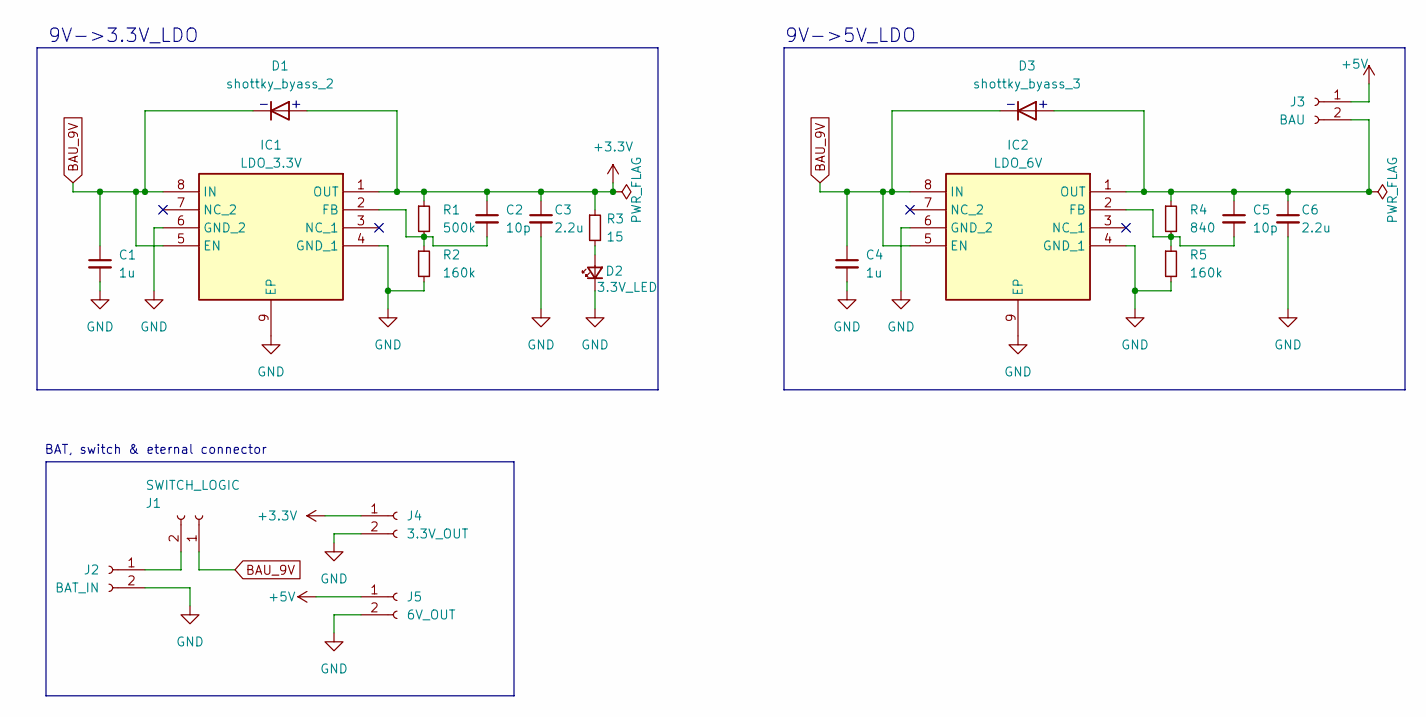
[picture p129: schematic PAMI_Power_board.kicad_sch]

Parts:
C1, C4: 1u; C_0402_1005Metric_Pad0.74x0.62mm_HandSolder
C2, C5: 10p; C_0805_2012Metric_Pad1.18x1.45mm_HandSolder
C3, C6: 2.2u; C_0805_2012Metric_Pad1.18x1.45mm_HandSolder
D1: shottky_byass_2; SOD2512X113N
D2: 3.3V_LED; ASCKCG00NW5X5020302
D3: shottky_byass_3; SOD2512X113N
IC1: LDO_3.3V; SOP65P490X110-9N; Manufacturer_Part_Number TLV76701DGNR; Mouser Part Number 595-TLV76701DGNR
IC2: LDO_6V; SOP65P490X110-9N; Manufacturer_Part_Number TLV76701DGNR; Mouser Part Number 595-TLV76701DGNR
J1: SWITCH_LOGIC; JST_XH_B2B-XH-A_1x02_P2.50mm_Vertical
J2: BAT_IN; JST_XH_B2B-XH-A_1x02_P2.50mm_Vertical
J3: BAU; JST_XH_B2B-XH-A_1x02_P2.50mm_Vertical
J4: 3.3V_OUT; JST_XH_B2B-XH-A_1x02_P2.50mm_Vertical
J5: 6V_OUT; JST_XH_B2B-XH-A_1x02_P2.50mm_Vertical
R1: 500k; R_0805_2012Metric_Pad1.20x1.40mm_HandSolder
R2, R5: 160k; R_0805_2012Metric_Pad1.20x1.40mm_HandSolder
R3: 15; R_0805_2012Metric_Pad1.20x1.40mm_HandSolder
R4: 840; R_0805_2012Metric_Pad1.20x1.40mm_HandSolder

Connections:
+3.3V: C2.1, C3.1, D1.2 (A), IC1.1 (OUT), J4.1, R1.1, R3.1
+5V: J3.1, J5.1
BAU_9V: C1.1, C4.1, D1.1 (K), D3.1 (K), IC1.5 (EN), IC1.8 (IN), IC2.5 (EN), IC2.8 (IN), J1.1
GND: C1.2, C3.2, C4.2, C6.2, D2.1 (K), IC1.4 (GND_1), IC1.6 (GND_2), IC1.9 (EP), IC2.4 (GND_1), IC2.6 (GND_2), IC2.9 (EP), J2.2, J4.2, J5.2, R2.2, R5.2; also elsewhere on the board
unnamed: D2.2 (A), R3.2
unnamed 5: C5.1, C6.1, D3.2 (A), IC2.1 (OUT), J3.2, R4.1; also elsewhere on the board
unnamed: C2.2, IC1.2 (FB), R1.2, R2.1
unnamed: C5.2, IC2.2 (FB), R4.2, R5.1
Switch: J1.2, J2.1

Notes on the sheet:
9V->3.3V_LDO
9V->5V_LDO
BAT, switch & eternal connector

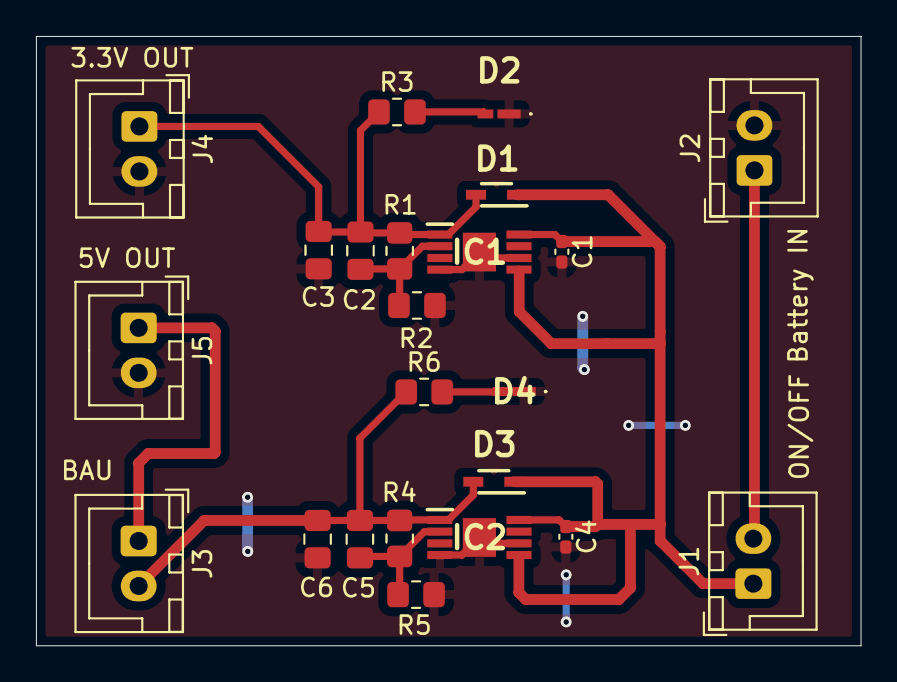
[picture p130: board PAMI_Power_board.kicad_pcb from above]

Board: 2 copper layers, 45.8 x 33.8 mm, 23 parts (0 on the bottom side), 10 nets.

Other parts of the board:
D4: 6V_LED; ASCKCG00NW5X5020302
R6: 135; R_0805_2012Metric_Pad1.20x1.40mm_HandSolder

Their connections:
GND: D4.1 (K); also elsewhere on the board
unnamed 5: R6.1; also elsewhere on the board
unnamed: D4.2 (A), R6.2
