DaVinciBot/CDR-CAD/(commit log)

2024-01-23 TAYOOOOO le repo
    [Cross.SLDPRT]
2024-01-29 Transfert de Grab-CAD vers Github
    [2e, petit bras.SLDPRT, 4221G_BXTH _ moteur.SLDPRT, 42gpt-2stage_standard+KSx _ reducteur.SLDPRT, ArduinoMega2560.step, ArduinoMega2560.step.SLDPRT, Assemblage 5mm.SLDASM, Assemblage Axe BRS.SLDASM, Assemblage BR_ancien_Faulhaber.SLDASM]
2024-02-03 Ajout de la modé du bras articulé
    (merci Théo)
    [M10 nut.SLDPRT, M10x25 bolt.SLDPRT, PLAN DE TES MORTS.SLDDRW, entretoise.SLDPRT, profile plate.SLDPRT, screen arm M8.SLDASM, screen arm female flat.SLDPRT, screen arm female.SLDPRT]
2024-02-13 sauvgarde actionneurs pince multiple
    [Assemblage_Robot_Main.SLDASM, Assemblage_pince multiple.SLDASM, Assemblage_pince multiple2.SLDASM, Pince mobile.SLDPRT, Pince multiple fixe - Copie.SLDPRT, Pince multiple fixe.SLDPRT, Poulie ascenseur.SLDPRT, Support ascenseur.SLDPRT]
2024-02-15 Réorganisation servo + main de dieu
    [Articulation_De_Dieu_1.SLDPRT, Articulation_De_Dieu_2.SLDPRT, Assemblage_Main_De_Dieu.SLDASM, Assemblage_Robot_Main.SLDASM, Assemblage_pince multiple2.SLDASM, Doigt_De_Dieu_1.SLDPRT, Doigt_De_Dieu_2.SLDPRT, M10 nut.SLDPRT]
2024-02-19 sauvegarde hebdo
    [Articulation_De_Dieu_1.SLDPRT, Articulation_De_Dieu_2.SLDPRT, Assemblage_Main_De_Dieu.SLDASM, Assemblage_Robot_Main.SLDASM, Assemblage_pince multiple2.SLDASM, Poulie_Main_De_Dieu.SLDPRT, Support_Main_De_Dieu - Copie.SLDPRT, Support_Tige_Main_De_Dieu.SLDPRT]
2024-03-05 Panneau Solaire et Zone de calcul
    Création de l'actionneur de panneau solaire ainsi que de la structure de la zone de calcul
    [Assemblage_Pic_Panneau_Solaire.SLDASM, Assemblage_Zone_Calcul.SLDASM, Base_Boite.SLDPRT, Bras_Panneau_Solaire.SLDPRT, CôtéDG_Boite.SLDPRT, Côté_Arrière_Boite.SLDPRT, Côté_Avant_Boite.SLDPRT, Routeur.SLDPRT]
2024-03-12 Sauvegarde Hebdomadaire
    [Assemblage Base roulante.SLDASM, Assemblage_Main_De_Dieu.SLDASM, Assemblage_Robot_Main.SLDASM, Plaque Base Roulante 1.SLDPRT, Poulie_De_Dieu.SLDPRT, Support_Main_De_Dieu - Copie.SLDPRT]
2024-03-19 Nouvelle version des éléments de jeu .step .stl / + autres
    Autres :
    Etage elec
    Support de camera Razer
    [Etage_Elec.SLDPRT, Marqueur d_identification.stp, Panneau Solaire.stp, Support Panneau Solaire.stp, Support_Camera.SLDPRT, plante.stp, pot.stp, start_tag.stp]
2024-03-21 Ajout du toit_proto
    [Assemblage Base roulante.SLDASM, Assemblage Lidar_Boitier.SLDASM, Assemblage_Main_De_Dieu.SLDASM, Assemblage_Main_De_Dieu_V2.SLDASM, Assemblage_Robot_1_V2.SLDASM, Assemblage_Robot_Main.SLDASM, Boitier Lidar Bas.SLDPRT, Boitier Lidar Haut.SLDPRT]
2024-04-08 Modification lidar
    [Assemblage Base roulante.SLDASM, Assemblage Lidar_Boitier.SLDASM, Assemblage15.SLDASM, Assemblage16.SLDASM, Assemblage_Bloc_Moteur_Droit.SLDASM, Assemblage_Bloc_Moteur_Droit_Allege.SLDASM, Assemblage_Bloc_Moteur_Gauche.SLDASM, Assemblage_Bloc_Moteur_Gauche_Allege.SLDASM]
2024-04-30 Sauvegarde pré-rush
    [Assemblage_Main_De_Dieu.SLDASM, Assemblage_Main_De_Dieu_V2.SLDASM, Assemblage_Main_De_Dieu_V3.SLDASM, Assemblage_Usinage_Moteurs.SLDASM, Joiture_Courroie.SLDPRT, Support_Main_De_Dieu.SLDPRT, Support_Main_De_Dieu_V2.SLDPRT, Support_Main_De_Dieu_V3.SLDPRT]
2024-05-04 Joute Solaire
    [Assemblage_Pic_Panneau_Solaire.SLDASM, Bras_Panneau_Solaire.SLDPRT, Bras_Panneau_Solaire_Horiz_Flex.SLDPRT, Support_Moteur_Stepper.SLDPRT, Support_Servo.SLDPRT, Support_Servo_Horiz.SLDPRT]
2024-05-05 roues encodeuses de rechanges
    [Articulation_De_Dieu_1.SLDPRT, Articulation_De_Dieu_2.SLDPRT, Assemblage Base roulante.SLDASM, Assemblage Roue Codeuse.SLDASM, Assemblage Roue Porteuse V2.SLDASM, Assemblage Systeme Encodeurs.SLDASM, Assemblage_Bloc_Moteur_Droit.SLDASM, Assemblage_Bloc_Moteur_Gauche.SLDASM]
2024-10-26 MAJ version finale 2024
    [2224U_SR-copie.SLDPRT, Assemblage16.SLDASM, Assemblage3.SLDASM, Assemblage_Compartiment_Batterie_Sol.SLDASM, Assemblage_Elements_De_Jeu.SLDASM, Assemblage_Encodeur_V2.SLDASM, Assemblage_Etage_Electrronique.SLDASM, Assemblage_Joute_Solaire.SLDASM]
2025-01-13 robot proto 2025
    [32-GPT_flange_a.stp, 32-GPT_flange_a.x_t, 32-GPT_flange_b.stp, 32-GPT_flange_b.x_t, 32-GPT_flange_c.stp, 32-GPT_flange_c.x_t, 32-GPT_flange_d.stp, 32-GPT_flange_d.x_t]
2025-04-10 grosse sauvegarde
    [3.Pince_A_Planche.SLDPRT, Articulation_De_Dieu_1.SLDPRT, Articulation_De_Dieu_2.SLDPRT, Assemblage Base roulante.SLDASM, Assemblage Roue Codeuse.SLDASM, Assemblage Roue Porteuse V2.SLDASM, Assemblage10384.SLDASM, Assemblage320.SLDASM]
2025-04-23 Add PAMI
    [17HM15-0904S.SLDPRT, Assemblage Base Roulante.SLDASM, Assemblage étage elek.SLDASM, CORPS test.SLDPRT, Corps + support moteur.SLDPRT, Moteur double assemblé.SLDPRT, Moteur.SLDPRT, PAMI.SLDASM]
2025-04-23 PAMI v2
    [Assemblage étage elek.SLDASM, Corps v2.SLDPRT, PAMI v2.SLDASM, PAMI.SLDASM, PCB alim.SLDPRT, carte_mere_sokko.SLDASM]
2025-05-11 Add PAMI PCB and PAMI v3, and remove SW temp file
    [Assemblage étage elek.SLDASM, BAT20JFILM.stp, Boitier.SLDPRT, Corps v2.STL, EDI2CAP.CFG, ESP32-S3-WROOM-1-N16R8.stp, ICM-45686.step, PAMI v3.SLDASM]
2025-05-11 Routing nearly done
    [carte_mere_sokko.kicad_pcb]
2025-05-12 PCB PAMI Nearly done, lack ground plane
    [JST_EH_B10B-EH-A_1x10_P2.50mm_Vertical.step, JST_EH_B11B-EH-A_1x11_P2.50mm_Vertical.step, JST_EH_B12B-EH-A_1x12_P2.50mm_Vertical.step, JST_EH_B13B-EH-A_1x13_P2.50mm_Vertical.step, JST_EH_B14B-EH-A_1x14_P2.50mm_Vertical.step, JST_EH_B15B-EH-A_1x15_P2.50mm_Vertical.step, JST_EH_B2B-EH-A_1x02_P2.50mm_Vertical.step, JST_EH_B3B-EH-A_1x03_P2.50mm_Vertical.step]
2025-05-13 V2 PAMI Motherboard
    [bom.csv, carte_mere_sokko.kicad_pcb, carte_mere_sokko.kicad_sch, designators.csv, positions.csv]
2025-05-21 pre ccompetition
    [Assemblage_Ascenseur.SLDASM, Assemblage_Attrape_Colonne_Aimant_Gauche_V4.SLDASM, Assemblage_Base_Roulante_2.0.SLDASM, Assemblage_Elements_De_Jeu.SLDASM, Assemblage_Main_De_Dieu_V3.SLDASM, Assemblage_Pince_A_Planche.SLDASM, Assemblage_Rail_Linéraie.SLDASM, Assemblage_Roue_Encodeuse_2.0.SLDASM]
2025-05-21 pre competition 2
    [Carte Alime Vfinale.SLDASM, Carte Alime Vfinale.step]
2025-05-21 pre competition 3
    [Assemblage6.SLDASM, Assemblage_Banderole.SLDASM, Assemblage_Lidar_Boitier.SLDASM, Assemblage_Lidar_Boitier_V2.SLDASM, Assemblage_Plexi.SLDASM, Assemblage_Teensy_Actionneur.SLDASM, Boitier_Lidar_Bas.SLDPRT, Boitier_Lidar_Bas_V2.SLDPRT]
2025-05-28 Fix PCB
    [ASCKCG00-NW5X5020302.stp, BAT20JFILM.stp, CMT-0525-75-SMT-TR.stp, DMN3065LW-7.stp, EDI2CAP.CFG, ESP32-S3-WROOM-1-N16R8.stp, IMB03ITS.stp, MPU-6050.stp]
2025-05-28 PAMI v4 from Damien's drive
    [Boitier.SLDPRT, Boitier.STL, Capot.SLDPRT, Pièce1.SLDPRT, ROUE.SLDPRT, YDLIDAR GS2.SLDPRT, antenne.STL, cache.SLDPRT]
2025-05-29 Improve PAMI motherboard
    Change footprint for the servo header
    link the 3.3 plane to improve reliability
    [carte_mere_sokko.kicad_pcb]
2025-06-05 Update hole position
    [carte_mere_sokko.kicad_pcb]
2025-06-14 Post CDR fix
    [Herse.SLDPRT, assemblage.SLDASM, cache.SLDPRT, etage.SLDPRT]
2025-09-29 2025 save last version
    [Assemblage_Ascenseur.SLDASM, Assemblage_Attrape_Colonne_Aimant_Gauche_V4.SLDASM, Assemblage_Banderole.SLDASM, Assemblage_Base_Roulante_2.0.SLDASM, Assemblage_Lidar_Boitier_V2.SLDASM, Assemblage_Pince_A_Planche.SLDASM, Assemblage_Plexi.SLDASM, Assemblage_Rail_Linéraie.SLDASM]
